2AMLogic/sg13g2-pll/sim/README.md

# sim/ — append-only PVT evidence records

This is the first work to land here (previously "Empty until the first work
lands here" — see the repo README's "Repo layout" and `spec/porting-plan.md`
§1.3, "Testbench / corner-harness structure"). The convention below is
carried over **as-is** from `gf180-pll`'s own `sim/README.md` (itself copied
from `2AMLogic/gf180-bandgap`) per that section's own disposition table — it
is methodology, not circuit data, so it needs no per-PDK re-derivation.

## Directory / naming convention

```
sim/
  <slug>/
    testbench/            ngspice deck(s) + any generator script that builds
                           per-corner netlists from them
    netlist-snapshots/    the exact design/**/netlist/*.spice this record
                           simulated, frozen at commit time -- independent of
                           whatever the live export says today
    corners/               the PVT/sensitivity matrix definition and the raw
                           per-corner results (a CSV or equivalent)
    records/               one Markdown file per run, `RECORD-NNN-<title>.md`,
                           numbered and never edited in place
```

One directory per **claim under test**, not per run — `<slug>` names the
claim (e.g. `sg13cmos5l-loop-filter-momcap`), and every new run against that
same claim adds a new `RECORD-NNN` file, not a rewrite of an old one. A
genuinely different DUT (a different block, a different question) gets its
own sibling slug rather than being folded into an existing one.

**Records are append-only.** A record's conclusion can be superseded by a
later record (e.g. a re-run against an updated netlist), but the old record
stays in place, unedited — the evidence trail is the history, not just the
latest answer.

**Netlist provenance.** Every record's `netlist-snapshots/` freezes the
exact `.spice` export it simulated, plus the commit SHA it was frozen at (in
each snapshot's own header comment) — independent of whatever
`design/**/netlist/*.spice` says by the time someone reads the record later.

**PVT corner matrix.** The default sweep is the full process x supply x temp
matrix; any subset (e.g. a passive network with no supply-dependent device,
so "supply corner" does not apply) must state the reason explicitly in the
record, not silently drop an axis. The corner *count* is PDK-specific — see
each record for the axes it actually swept and why.

**Host requirement — `cap_cmomi`-bearing decks need an x86-64 host, unless
the two MOM-capacitor OSDI models are rebuilt locally first.** The installed
`ihp-sg13cmos5l` tree ships `cap_cmomi.osdi` and `cap_cmomf.osdi` as
**prebuilt x86-64 ELF binaries tracked in upstream git** — unlike
`psp103`/`psp103_nqs`/`mosvar`/`r3_cmc`, which are host-local build products
of the sibling `ihp-sg13g2` tree. On an arm64 macOS host the two therefore
fail `dlopen` ("slice is not valid mach-o file") and every deck that
*instantiates* a `cap_cmomi` device aborts with `Unable to find definition of
model xcap:cap_cmomi_mod`. **That failure is a host/PDK-provisioning gap, not
a broken testbench.** The PDK ships its own fix —
`ihp-sg13cmos5l/libs.tech/verilog-a/openvaf-compile-va.sh` recompiles exactly
those two models from the Verilog-A sources in the same tree — and issue #59
verified on x86-64 that a locally rebuilt model reproduces two whole committed
campaigns byte-identically. What is *not* verified is the arm64 build itself
(OpenVAF-Reloaded publishes no macOS binary, so `openvaf-r` has to be built
from source there first). Read
[`PORTING-osdi-host-arch.md`](PORTING-osdi-host-arch.md) before running any
`sim/` campaign on a non-x86-64 host: it carries the rebuild command, what
stays unverified, and the numeric cross-check a rebuilt model must pass before
it is trusted for a **new** record. `sim/tools/check-osdi-arch.sh` is the
preflight the `cap_cmomi`-loading campaigns call, so they abort with that
diagnosis instead of with ngspice's message. One campaign
(`sg13cmos5l-lock-detector-window`) opts that single object out of the abort
with the preflight's `--soft` flag, because it has a validated closed-form
substitute for it and records which source produced every affected number in
the CSV's own `source` column — see `PORTING-osdi-host-arch.md` § "`--soft`".
Every other object stays a hard abort in every campaign, including that one.

**Closed-loop internal-timestep bound** and **charge-domain PFD/CP
characterization** (the other two `spec/porting-plan.md` §1.3 methodology
items carried over as-is) apply once a closed-loop or PFD/CP testbench
exists. **No record below is a transistor-level closed-loop testbench**, so
the internal-timestep bound still does not apply. The charge-domain PFD/CP
characterization is *partially* engaged as of issue #27:
`sg13cmos5l-cp-icp-trim` characterises the charge pump's own delivered
current and up/down mismatch, but at DC with the switches held static —
the *charge*-domain (per-reference-cycle, switching) part of that
methodology item is still not exercised, and that record says so in its own
"What this does not bound".

## Cold start

How a third party reproduces any recorded result, and the PDK revision the
repo is pinned to. Checked by `manifests/check_testbench_coverage.py` (T1
item 9, issue #179); every bench with a `records/` directory must be indexed
below and vice versa.

**Pinned PDK revisions.** One line per PDK tree (parsed by the gate):

```
PDK-PIN ihp-sg13cmos5l 607e18d4bd9214a52575c194b4181ef449f9252f
PDK-PIN ihp-sg13g2 5cccb161f7492697cfa52eb14dc03beb00bdca9e
```

Provenance of the pins, stated honestly: none of the 37 grandfathered
records cites a full PDK commit. They name only the install path and
`ngspice-46`/`-47`. The `ihp-sg13cmos5l` pin is the clean git checkout
installed at `~/share/pdk` on the worker host as of 2026-10-09 (commit date
2026-08-25). Its reflog shows one clone at 2026-08-25 15:54 UTC and no later
checkout.

The `ihp-sg13g2` pin (issue #210) is upstream `IHP-GmbH/IHP-Open-PDK` tag
`v0.3.0`, commit `5cccb161f7492697cfa52eb14dc03beb00bdca9e`. The worker's
tree is a release-tarball install (`.fetched-version` = `0.3.0`), not a git
checkout. The pin was established by a separate user-space clone of that
commit (under `/tmp`, nothing host-wide touched), compared with
`diff -rq` against the installed tree:

* every one of the commit's `ihp-sg13g2/` files is present and
  byte-identical (0 differing files);
* the installed tree only *adds* host-local products: the compiled
  `libs.tech/ngspice/osdi/*.osdi`, `__pycache__/`, and submodule content
  the tarball does not carry.

Upstream `main` has since changed 23 `ngspice/models` files, so a fresh
clone of `main` would not reproduce the run environment. Commands and
output: [`provenance-migration.md`](provenance-migration.md) § "Pin
verification".

Both pins are today's reproducibility targets. Neither proves what an
individual record ran against: several records ran on an arm64 macOS host
whose trees are unknown. Note also that `ihp-sg13cmos5l` tracks most of its
ngspice model cards and the `psp103`/`psp103_nqs`/`mosvar`/`r3_cmc` OSDI
paths as symlinks into the sibling `ihp-sg13g2` tree, so CMOS5L
transistor-level runs read both trees (see `provenance-migration.md`).

All 37 existing records (append-only, so not editable) stay grandfathered in
`KNOWN_DEFECTS`, tracked by issue #182. Their per-record inventory and
recovered/superseded dispositions are in `provenance-migration.md`. Item 9
stays `unmet` until every record is resolved; it is not claimed met here.

### Provenance addenda (append-only migration)

Committed records are never edited, renamed or deleted. A grandfathered
record (`KNOWN_DEFECTS` in `manifests/check_testbench_coverage.py`) is
resolved only by a **new** file `sim/<slug>/records/ADDENDUM-NNN-<topic>.md`
in the same bench, one addendum per original, made of `KEY: value` lines
(other prose is ignored). Two kinds:

```
ADDENDUM-FOR: <slug>/records/RECORD-001-....md   # the original, same bench
ADDENDUM-KIND: recovered
ADDENDUM-SHA256: <sha256 of the original's bytes>  # proves it is unmodified
ADDENDUM-PDK: ihp-sg13g2 <40-hex revision>        # repeat per tree if mixed
ADDENDUM-TOOL: ngspice-46
ADDENDUM-EVIDENCE: <what was recovered, e.g. host PDK checkout log, path/date>
```

```
ADDENDUM-FOR: <slug>/records/RECORD-001-....md
ADDENDUM-KIND: superseded
ADDENDUM-SHA256: <sha256 of the original>
ADDENDUM-RERUN: <slug>/records/RECORD-0NN-....md   # same bench, cites the original by file name
ADDENDUM-EVIDENCE: <what was rerun>
```

* `recovered` establishes the *historical* PDK revision(s) and tool of the old
  run from evidence. Revisions are never inferred from today's installed PDK
  or from the slug; a bench that used both trees lists both `ADDENDUM-PDK`
  lines. A recovered revision that differs from today's pin is kept and
  reported by the gate (the pin is today's reproducibility target, not a claim
  about the past). Contradicting a revision the original itself cites fails.
* `superseded` replaces the *evidence claim* with a new measurement. It must
  not carry `ADDENDUM-PDK`/`ADDENDUM-TOOL`: a new run does not prove the old
  run's environment. The rerun is an ordinary `RECORD-*.md` and must itself
  cite a PDK revision and tool version (and match the pin).
* A `RECORD-*.md` (including a rerun) may cite revisions for more than one
  known tree, written `PDK <tree> revision <hex>` or `<tree> <hex>`. Each
  tree-qualified revision is compared with **that tree's** pin; a mismatch is
  a DISCREPANCY. Use this when a `sg13cmos5l-*` bench reads `ihp-sg13g2`
  content through the upstream symlinks (cite both trees; never drop one).
  An unqualified revision is compared with the bench tree's pin, as before.
* The gate fails closed on: missing fields, bad hash, dangling or cross-bench
  references, a rerun that does not cite the original (unrelated), cyclic or
  self supersession, duplicate addenda for one record, unknown PDK tree or
  contradictory revisions, an addendum for a record with no defect, and an
  unresolved rerun. Resolved `KNOWN_DEFECTS` entries are retained (reported as
  resolved) until a human removes them; unresolved ones stay open.
  Item 9 stays unmet and uncited while any record is unresolved or any pin is
  `UNKNOWN`.

**Install steps** (no host-wide tools; everything is user-space):

1. Fetch the PDK trees and expose them as siblings under `PDK_ROOT`.
   `ihp-sg13cmos5l` is the `ihp-sg13cmos5l/` subtree of
   `https://github.com/IHP-GmbH/IHP-Open-PDK` (the split
   `IHP-GmbH/ihp-sg13cmos5l` repository is archived). Install pin, fetched as
   an exact-commit tarball and checked before extraction (copy the subtree
   into `$PDK_ROOT/ihp-sg13cmos5l`; do not symlink it, so its relative model
   symlinks resolve to the sibling `ihp-sg13g2`):
   `curl -fsSL -o pdk.tgz https://codeload.github.com/IHP-GmbH/IHP-Open-PDK/tar.gz/f7bca32694fe3d58be0cc7d9df4b9f5db7161a14 && echo "5eb6f8a9b0b2ecc4fa08cc30627668406f85b1a97834f278036c43f0c0dbc70b  pdk.tgz" | sha256sum -c - && tar -xzf pdk.tgz --strip-components=1 -C "$PDK_UNIFIED" IHP-Open-PDK-f7bca32694fe3d58be0cc7d9df4b9f5db7161a14/ihp-sg13cmos5l && cp -a "$PDK_UNIFIED/ihp-sg13cmos5l" "$PDK_ROOT/ihp-sg13cmos5l"`
   Note: the `PDK-PIN ihp-sg13cmos5l` line above and the recorded evidence
   still name the legacy split-repository commit; evidence reruns on the new
   pin and the pin switch are owned by #213-#218, so records made before that
   cite the legacy revision, not this install pin.
   The `ihp-sg13g2` tree is the `ihp-sg13g2/` subdirectory of
   `https://github.com/IHP-GmbH/IHP-Open-PDK` at its pin:
   `git clone https://github.com/IHP-GmbH/IHP-Open-PDK "$PDK_SRC" && git -C "$PDK_SRC" checkout 5cccb161f7492697cfa52eb14dc03beb00bdca9e`,
   then expose `$PDK_SRC/ihp-sg13g2` as `$PDK_ROOT/ihp-sg13g2`. It must be a
   sibling of `ihp-sg13cmos5l`, whose relative model symlinks resolve into
   it.
2. ngspice 46 with OSDI support (records were produced with `ngspice-46`;
   a few with `ngspice-47`, noted in those records).
3. Build the OSDI models the tree needs (`psp103`, `psp103_nqs`, `mosvar`,
   `r3_cmc`) per the PDK's `libs.tech/verilog-a/openvaf-compile-va.sh`; on a
   non-x86-64 host also rebuild `cap_cmomi`/`cap_cmomf` (see the host
   requirement above). `sim/tools/check-osdi-arch.sh` preflights this.
4. `export PDK_ROOT=<parent dir>`; `export PDK=ihp-sg13cmos5l` (or
   `ihp-sg13g2`), then run the entry point from the repo root.

On a shared worker, multi-corner grids go through `klt sim` to the batch
fleet rather than hand-launched ngspice loops.

**Bench index** (slug, entry point, invocation):

| Bench | Entry point | Invocation |
| --- | --- | --- |
| `sg13cmos5l-closed-loop-lock` | `testbench/run.sh` | `PDK_ROOT=$PDK_ROOT PDK=ihp-sg13cmos5l sim/sg13cmos5l-closed-loop-lock/testbench/run.sh` |
| `sg13cmos5l-closed-loop-lock` (mismatch-gain grid, batch fleet) | `testbench/gen_mismatch_gain_requests.py` | `python3 -I sim/sg13cmos5l-closed-loop-lock/testbench/gen_mismatch_gain_requests.py --pinned-pdk $PINNED_PDK OUTDIR && klt sim --batch-set OUTDIR/dc/*/request.json --wait-for-capacity 600 && klt sim --batch-set OUTDIR/loop/*/request.json --wait-for-capacity 600` (then `testbench/mismatch_gain_post.py`; see `records/RECORD-014`) |
| `sg13cmos5l-closed-loop-real-divider` | `testbench/run.sh` | `PDK_ROOT=$PDK_ROOT PDK=ihp-sg13cmos5l sim/sg13cmos5l-closed-loop-real-divider/testbench/run.sh` |
| `sg13cmos5l-cp-icp-trim` | `testbench/run.sh` | `PDK_ROOT=$PDK_ROOT PDK=ihp-sg13cmos5l sim/sg13cmos5l-cp-icp-trim/testbench/run.sh` |
| `sg13cmos5l-cp-icp-trim-mc` | `testbench/gen_requests.py` | `cd sim/sg13cmos5l-cp-icp-trim-mc && python3 -I testbench/gen_requests.py --pinned-pdk $PINNED_PDK && klt sim testbench/mc.request.json --backend batch --wait-for-capacity 600 --report-out reports/sim.mc.json` |
| `sg13cmos5l-divider-nrange-retiming` | `testbench/run.sh` | `PDK_ROOT=$PDK_ROOT PDK=ihp-sg13cmos5l sim/sg13cmos5l-divider-nrange-retiming/testbench/run.sh` |
| `sg13cmos5l-divider-retiming-sizing` | `testbench/gen_sizing_requests.py` | `python3 -I sim/sg13cmos5l-divider-retiming-sizing/testbench/gen_sizing_requests.py setup b:b && klt sim <request> --backend batch --wait-for-capacity 600` |
| `sg13cmos5l-klt-pex-signoff` | `run-klt-pex.sh` | `PDK_ROOT=$PDK_ROOT sim/sg13cmos5l-klt-pex-signoff/run-klt-pex.sh <block>` |
| `sg13cmos5l-lock-detector-window` | `testbench/run.sh` | `PDK_ROOT=$PDK_ROOT PDK=ihp-sg13cmos5l sim/sg13cmos5l-lock-detector-window/testbench/run.sh` |
| `sg13cmos5l-lock-detector-window` (batch fleet) | `testbench/run_batch.sh` | `sim/sg13cmos5l-lock-detector-window/testbench/run_batch.sh` (full grid; `NOMINAL_ONLY=1` for one corner; see `testbench/BATCH.md`) |
| `sg13cmos5l-supply-range` | `testbench/run_batch.sh` | `sim/sg13cmos5l-supply-range/testbench/run_batch.sh` |
| `sg13cmos5l-loop-bandwidth-pm` | `testbench/run.sh` | `PDK_ROOT=$PDK_ROOT PDK=ihp-sg13cmos5l sim/sg13cmos5l-loop-bandwidth-pm/testbench/run.sh` |
| `sg13cmos5l-loop-filter-momcap` | `testbench/run.sh` | `PDK_ROOT=$PDK_ROOT PDK=ihp-sg13cmos5l sim/sg13cmos5l-loop-filter-momcap/testbench/run.sh` |
| `sg13cmos5l-postlayout-pex-pvt` | `testbench/run.sh` | `PDK_ROOT=$PDK_ROOT PDK=ihp-sg13cmos5l sim/sg13cmos5l-postlayout-pex-pvt/testbench/run.sh` |
| `sg13cmos5l-vco-decap-momcap` | `testbench/run.sh` | `PDK_ROOT=$PDK_ROOT PDK=ihp-sg13cmos5l sim/sg13cmos5l-vco-decap-momcap/testbench/run.sh` |
| `sg13cmos5l-vco-duty-cycle` | `testbench/run.sh` | `PDK_ROOT=$PDK_ROOT PDK=ihp-sg13cmos5l sim/sg13cmos5l-vco-duty-cycle/testbench/run.sh` |
| `sg13cmos5l-vco-output-levels` | `testbench/run.sh` | `PDK_ROOT=$PDK_ROOT sim/sg13cmos5l-vco-output-levels/testbench/run.sh WORKDIR` |
| `sg13cmos5l-vco-kvco-table` | `testbench/run.sh` | `PDK_ROOT=$PDK_ROOT PDK=ihp-sg13cmos5l sim/sg13cmos5l-vco-kvco-table/testbench/run.sh` |
| `sg13g2-pfd-reset-parity` | `testbench/run.sh` | `PDK_ROOT=$PDK_ROOT PDK=ihp-sg13g2 sim/sg13g2-pfd-reset-parity/testbench/run.sh` |
| `sg13g2-divider-repair-reverification` | `testbench/run.sh` | `PDK_ROOT=$PDK_ROOT PDK=ihp-sg13g2 sim/sg13g2-divider-repair-reverification/testbench/run.sh` |
| `sg13g2-hbt-characterization` | `testbench/run.sh` | `PDK_ROOT=$PDK_ROOT PDK=ihp-sg13g2 sim/sg13g2-hbt-characterization/testbench/run.sh` |
| `sg13g2-lock-detector-window` | `testbench/run.sh` | `PDK_ROOT=$PDK_ROOT PDK=ihp-sg13g2 sim/sg13g2-lock-detector-window/testbench/run.sh` |
| `sg13g2-vco-kvco-table` | `testbench/run.sh` | `PDK_ROOT=$PDK_ROOT PDK=ihp-sg13g2 sim/sg13g2-vco-kvco-table/testbench/run.sh` |

**`sg13cmos5l-cp-icp-trim-mc` takes `$PINNED_PDK`, not `$PDK_ROOT`.** (So
does `sg13cmos5l-closed-loop-lock`'s `gen_mismatch_gain_requests.py`, for a
different reason: it ships the pinned model bytes with each batch job via
`options.stage_model_inputs` rather than resolving them on the fleet image.)
`sg13cmos5l-cp-icp-trim-mc` is the bench whose *result* depends on which of
the two `ihp-sg13cmos5l` revisions above it reads: the newer install defaults the HV MOS mismatch
subcircuits to `mm_ok=0`, and this repo's netlists carry no `mm_ok=` on their
instance lines, so the Monte Carlo campaign would return sigma exactly 0 on
every measurement and still report `pass`. `$PINNED_PDK` must be an
`ihp-sg13cmos5l` checkout at the `PDK-PIN` revision above; the bench's
generator refuses to emit a request against a tree it cannot prove will draw.
See `sg13cmos5l-cp-icp-trim-mc/README.md` and its `records/RECORD-002`.

**The `±3.5 %` that bench grades against is retired** (issue #385).
`spec/decision-records/DR-013-cp-mismatch-limit.md` retires it and proposes
no replacement bound: `sg13cmos5l-closed-loop-lock`'s
`records/RECORD-014-cp-mismatch-phase-error-gain.md` re-measured the gain it
was derived from on the DR-010 `cp` and found it ~30× smaller, of the
opposite sign, and not through the origin.
`sg13cmos5l-cp-icp-trim-mc/records/RECORD-003-regrade-proposed-limit.md`
re-grades the committed 1500 samples against DR-013's evidence-coverage
bound with `klt yield --limits` (99.60 %, `required_n` 154, sample-size
verdict `sufficient`), writing `reports/yield.mc.proposed-limit.json` beside
— never over — `reports/yield.mc.json`. `testbench/mc.request.json` is
unedited, so its `min -3.5 / max 3.5` is history, not a live bound. The
ruling the ratifiers are asked for is `spec/target-spec.md` R-12.

## PDK scope — two independent campaigns, one convention

This repo targets two PDKs in parallel (`design/README.md` "SG13CMOS5L
port"): the original SG13G2 design directly under `design/`, and the
SG13CMOS5L port under `design/sg13cmos5l/`. Both campaigns use the directory
convention above, distinguished by the `<slug>` prefix (`sg13cmos5l-*` here;
an unprefixed or `sg13g2-*` slug for the original PDK once that campaign
starts). **SG13G2 now has its own campaign** (`sg13g2-lock-detector-window`,
issues #81 and #82, Part of #16 via #78) — see "SG13G2 campaign status" below. Every
earlier campaign issue was scoped to the SG13CMOS5L port only, and none of
those add or edit an SG13G2 result. **One exception worth naming, because it
predates #81 and is a measurement of an SG13G2 netlist living in a
`sg13cmos5l-*` slug**:
`sg13cmos5l-lock-detector-window/corners/schmitt_rewire.csv` (issue #66)
carries a `pdk` column and 54 of its 108 rows measure
`design/netlist/lock_detector.spice`'s `schmitt_hv` on `ihp-sg13g2`. That is
deliberate — issue #66 fixes the same two-net feedback defect in the shared
cell on both PDKs, and "measured on both" is a stronger claim than "measured
on one and argued across". It is filed under the CMOS5L slug rather than
opening an SG13G2 slug for two nets, and it does not constitute an SG13G2
campaign: the SG13G2 `lock_detector`'s own `XRPU`/`XCW`/`XMPD` are still at
their pre-#52 values and nothing here measures them.

## SG13CMOS5L campaign status

Tracks issues #23, #27, #30, #36, #37, #38, #52 and #66 (all Part of #16). #23 owns the
specific obligation `spec/decision-records/DR-003-sg13cmos5l-port-readiness.md`
Finding 2 names: every spec row sensitive to the design's three `cap_cmomi`
MOM-cap instance sites (`loop_filter.XC1`/`XC2`, `vco.XCDECAP`) must be swept
across a plausible MOM-model-uncertainty band, because the installed PDK's
own `cap_cmomi`/`cap_cmomf` models carry **no characterised process-corner
or mismatch spread** (`cornerCAP.lib`'s own header, confirmed directly by
this campaign — see records below) and are "not validated on CMOS5L
silicon." #27 picks up the rows #23 explicitly deferred: the ones needing a
charge-pump characterisation, a loop-level combination of the three
measured block records, or a longer/edge-resolved transient. #36 (split out
of #27) takes row 3 — the `divider_chain`'s own functional N range and
retiming margin — which #27 built an exploratory testbench for but
deliberately never published. #37 (also split out of #27) picks up the
three rows that specifically need a real transistor-level closed loop, none
of which #27's own three records is. #38 measures `lock_detector` (row 16),
never attempted in #27, and closes the MOM-uncertainty gap on its own two
`cap_cmomi` instances (`XCW`/`XDW.XC1`), which are outside DR-003 Finding
2's three-instance list. #52 is the first issue in this campaign to
**change the design and re-measure it**: it re-sizes the three
`lock_detector` devices #38's own record root-caused (`XRPU`, `XCW`,
`XDW.XC1`) and re-runs #38's campaign against the resized block, appending
`RECORD-002` beside `RECORD-001` rather than replacing it. #66 then fixes the
two mechanisms RECORD-002 measured but was out of scope to change
(`schmitt_hv`'s feedback wiring and the `XRPU`/`XMPD` strength ratio) and
runs the campaign a third time, appending `RECORD-003` — closing row 16's
last measurable criterion. **#30 is the first campaign here that measures a
*layout* rather than a schematic**: it re-runs two of the matrices below
against parasitic-annotated netlists extracted from the routed GDS, each
alongside a schematic-level control arm re-run on the same host, and is the
named follow-up issue #24 deferred post-layout PVT to. It adds **no new spec
row and amends none** — it re-measures rows already bounded above and reports
how far layout moves them. The table below is the whole campaign, in the
order the records landed.

| Slug | Claim under test | Spec row(s) (`spec/porting-plan.md` §1.2) | Status |
|---|---|---|---|
| [`sg13cmos5l-loop-filter-momcap`](sg13cmos5l-loop-filter-momcap/) | `loop_filter` R1/C1/C2 corner + MOM-cap-uncertainty sensitivity (zero/pole location) | 6/6a (loop bandwidth / phase margin) | Zero/pole location **bounded** by a real PVT+MOM sweep; the row's own kHz/degree numbers stay `insufficient-evidence` (needed the not-yet-re-derived Kvco table and Icp-trim table; both landed, and `sg13cmos5l-loop-bandwidth-pm` below now closes the row) |
| [`sg13cmos5l-vco-decap-momcap`](sg13cmos5l-vco-decap-momcap/) | `vco.XCDECAP` capacitance value + supply-decoupling pole sensitivity | 8 (period jitter), 12 (supply sensitivity) | Capacitance value **bounded** by a real MOM sweep; the absolute jitter-ps / dB-attenuation numbers stay `insufficient-evidence` (need a post-layout parasitic source impedance and a closed-loop phase-noise method ngspice cannot run today — DR-002 Decision 5) |
| [`sg13cmos5l-vco-kvco-table`](sg13cmos5l-vco-kvco-table/) | Open-loop `vco` frequency vs. `VCTRL` vs. 2-bit band code, real transient sweep (not MOM-cap-sensitive — no `cap_cmomi` instance survives this testbench's own XCDECAP-strip, see that record's "Tooling note") | 4/5 (Kvco bound / band-selection rule) | Kvco-vs-band-code table **bounded** by a real PVT-cornered open-loop sweep (3 corner bundles x 4 band codes x 5 `VCTRL` points); row 6/6a's own loop-bandwidth number is now closed by `sg13cmos5l-loop-bandwidth-pm` below, and row 3 (divider retiming margin) still needs the divider chain's own re-derivation |
| [`sg13cmos5l-cp-icp-trim`](sg13cmos5l-cp-icp-trim/) | `cp` delivered current vs. mirror trim code, and up/down mismatch vs. output voltage (all-MOS DUT — no resistor and no `cap_cmomi` instance, so neither the RES-corner nor the MOM axis applies) | 6/6a (Icp-trim table), 10 (reference spur, mismatch input) | Icp-trim table **bounded** by 306 real DC sweeps (5 MOS corners x 3 temps + a ±10% supply sub-axis x 6 trim codes x 3 switch states): the mirror-referenced ladder tracks its reference to within 0.14% across the whole PVT matrix. Row 10's own dBc number stays `insufficient-evidence` — the *static* mismatch is now real, but a spur level additionally needs switching charge mismatch, the PFD reset window, and a stable loop to define a carrier |
| [`sg13cmos5l-loop-bandwidth-pm`](sg13cmos5l-loop-bandwidth-pm/) | Linearised open-loop gain around the **real** `loop_filter` subckt, with `Icp` and `Kvco` taken from the two measured records above | 6/6a (loop bandwidth / phase margin) | **`insufficient-evidence` CLEARED — and the bound is a failure to meet the criteria.** `f_c` = 0.33–4.64 MHz, PM = 1.55–20.33° across 90 real-subckt AC runs; **0 of 90 meet the ≥45° criterion** with the as-drawn filter, and `Icp` cannot trade one criterion against the other. A separate proposal sweep (`corners/proposal.csv`, explicitly *not* the committed design) shows `R1` ×20 with the 10 µA trim code meets both criteria at every PVT bundle. Also records that the ported `f_ref` = 1–25 MHz / `N` = 4–64 rows are mutually inconsistent with the measured VCO band |
| [`sg13cmos5l-vco-duty-cycle`](sg13cmos5l-vco-duty-cycle/) | Open-loop `vco` output duty cycle (rising *and* falling 50%-of-rail crossings), plus the ring's own average supply current | 13 (output duty cycle), 11 (power, one domain) | Duty cycle **bounded** by 300 real transient runs (5 MOS corners — including the `mos_sf`/`mos_fs` split corners the Kvco record left open — x 3 temps x 4 band codes x 5 `VCTRL` points): 43.74–51.56%, with **30 of 300 points below the 45% floor**, all at −40 C. Reproduces gf180-pll's own carried-forward duty-cycle design flag on a different process. Row 11 stays `insufficient-evidence` (only the `vdd_vco` and `cp` domains are measured) |
| [`sg13cmos5l-vco-output-levels`](sg13cmos5l-vco-output-levels/) | Open-loop `vco` output levels (settled V_OH / V_OL) into a 50 fF load on `CLK`, as one `klt sim` batch request | 14 (output levels / drive) | **54 of 54 points inside the bounds** (3 PVT bundles x 3 temps x band `00`/`11` x 3 `VCTRL`): worst V_OH 3.003 V vs >= 2.97 V (`mos_ss`, 125 C, band `11`, `VCTRL` 2.7 V, +33 mV), worst V_OL 0.122 V vs <= 0.33 V. Schematic only; `mos_sf`/`mos_fs`, band `01`/`10`, mismatch, post-layout not swept. Spec row not edited (R-10) |
| [`sg13cmos5l-closed-loop-lock`](sg13cmos5l-closed-loop-lock/) | Transistor-level closed loop (`pfd`+`cp`+`loop_filter`+`vco`+`divider_chain`+`lock_detector`, testbench-local wiring — no `pll_top` schematic exists), single PVT point (runtime-cost subset, see that record's own `corners/matrix.md`) | 7 (lock time), 10 (reference spur), 11 (power, remaining domains) | **Row 11 bounded** (with caveats): all five remaining domains measured simultaneously at one operating point — `pfd`+`cp`+`vco`+`lock_detector` = 2.483 mA (8.20 mW); `divider_chain` alone = 7.653 mA (25.26 mW), but flagged as very likely inflated by that block's own known malfunction (see below), not a clean design figure. **Rows 7 and 10 stay `insufficient-evidence`**, but the `pfd` self-reset inverter-parity defect `records/RECORD-002` (issue #50) root-caused is now **fixed and re-verified** (`records/RECORD-003`, issue #56): with the corrected `pfd`, the proposal loop (Part B) achieves genuine **frequency lock** (`Δf`/`f_ref` within 0.03% of `f_ref` for a full microsecond, zero cycle slips — vs. `RECORD-001`'s own monotonically-diverging ≈23% `Δf`) but settles at a stable **static phase error of ≈9.18% of a reference period**, ~1.8× this record's own 5% row-7 threshold, so the dual lock criterion is still not met. **`records/RECORD-004` (issue #70) then confirms the mechanism**: an ideal, diagnostic-only substitution forcing `cp`'s `up`/`dn` currents to be exactly equal (NOT a change to the committed `cp`) collapses the static phase error to a mean of −0.00044% in the pinned dual-tree rerun (`records/RECORD-012-icp-mismatch-diagnostic-rerun-pinned.md`, #228; −0.00235% in the original run; both from 9.176%, `RECORD-003`'s own final-20-cycle window) and to simulator floating-point noise in the fully-settled tail, while also extending the longest continuous dual-lock run from 4 cycles to 41 (41 cycles and the 450 ns `lock_time` reproduce identically in the rerun). RECORD-004's own decision: this is a design-level `cp` current-mirror-matching defect worth mitigating, not an acceptable residual — filed as issue #72. The as-drawn loop (Part A) still does not lock, independently over-determined by the separate `divider_chain` defect (#36). **`records/RECORD-005` (issue #72) then implements and re-runs the real mitigation** (`design/sg13cmos5l/cp.sch` gains an on-chip high-swing cascode bias replica, `spec/decision-records/DR-006`): the DC-measured up/dn mismatch this mitigation targets drops 20x at the loop's own operating point (`sim/sg13cmos5l-cp-icp-trim/records/RECORD-002`: −6.42% → −0.298%), but the closed-loop static phase error only drops from 9.176% to **8.203%** — an ~11% relative reduction, not the ~3,900x collapse RECORD-004's idealized diagnostic showed for the same nominal mechanism — and the longest continuous dual-lock run stays at 4 cycles. **Row 7 still fails for the mitigated design, not just the as-drawn one.** RECORD-005's own analysis: RECORD-004's ideal substitution likely also removed switching/dynamic charge-mismatch effects (already flagged as unmeasured by `sim/sg13cmos5l-cp-icp-trim/RECORD-002`) alongside the DC magnitude term it was built to isolate, and that dynamic term — not DC magnitude, which is now small — is the best-fitting remaining candidate for row 7's residual, though not itself confirmed by a dedicated diagnostic. **This slug's own testbench also hosts `run_closed_loop_vwin_dwell.sh` (issue #76)**, which instruments both `lock_detector` revisions side by side inside a closed-loop acquisition to answer a `sg13cmos5l-lock-detector-window` question (whether `schmitt_hv`'s crowbar current is reachable in real operation, not a claim this slug's own rows track) — see that slug's `records/RECORD-004-crowbar-current-mitigation.md`<br><br>**`RECORD-006` (#150, diagnostic, nominal corner, proposal deck): the 8.2% residual is dump-node charge sharing in `cp`** (`VDUMP` ≈0.94 V below `VOUT`, ≈41 fC per cycle); an ideal `VDUMP = VOUT` reaches 1.05%/locked, but row 7 still fails for the committed design<br><br>**`RECORD-014` (#385, diagnostic, proposal deck, −40/27/125 °C): the mismatch-to-static-phase-error gain on the DR-010 `cp` is −0.0394 to −0.0484 pp/pp — ~30× smaller than the +1.43 pp/pp the `sg13cmos5l-cp-icp-trim-mc` ±3.5% screening limit assumed, and of the opposite sign.** Six injected DC mismatch points spanning −11.998 to +12.009% (±3.1σ), each snapshot's own mismatch measured rather than assumed; a linear-through-origin model is rejected (forcing the intercept to zero multiplies the fit residual by 22×–90×) because the intercept is the DR-010 `cp`'s own 0.75–0.84 pp zero-mismatch residual. The worst static phase error anywhere in the span is 1.3265%, against the 5% criterion. `spec/decision-records/DR-013` retires the ±3.5% value and proposes no replacement bound; target-spec R-12 carries the ruling. **New failure retained: at 125 °C the proposal deck does not acquire lock at any mismatch point, including the unperturbed one** (`vctrl` rails at 3.289 V) — newly visible because every earlier closed-loop record here ran at 27 °C only |
| [`sg13cmos5l-closed-loop-real-divider`](sg13cmos5l-closed-loop-real-divider/) | Nominal-only (`mos_tt`/`res_typ`/27 C/3.3 V, one point, pre-layout) closed loop with the repaired transistor-level `divider_chain` (N=64, 20 MHz ref), vs. a behavioural /64 control arm; plus a divider-alone speed diagnostic at 200/640/1280 MHz (edge counts persisted in `corners/edges_divspeed_*`) | 7 (lock time) | **Row 7 still fails**: the real-divider loop does not acquire (dual-lock never met); the divider alone divides by 64 at 200 and 640 MHz but by 96 at 1.28 GHz. Not a PVT campaign and no post-layout or sign-off claim. See [`records/RECORD-001`](sg13cmos5l-closed-loop-real-divider/records/RECORD-001-repaired-divider-in-loop-nominal.md) (issue #159, follow-up #168) |
| [`sg13cmos5l-lock-detector-window`](sg13cmos5l-lock-detector-window/) | Real-subckt `lock_detector` assert window, hysteresis, chatter and supply current, plus the `XCW`/`XDW.XC1` MOM-uncertainty sensitivity | 16 (lock-detector targets), 11 (power, one more domain) | **`RECORD-001` (#38, pre-resize): window, hysteresis and no-chatter all bounded, and all three fail the ported criteria at every corner.** Window = 0.219–0.409 ns (target ≥2.5 ns); no hysteresis resolves at the ladder's 0.15×-window step at any of 92 points (target ≥25% of window); **92/92 points chatter**, including at a 10×-window static phase error. Cause is measured directly: the integrating node's own `XRPU`·`XCW` time constant (0.71–1.71 ns) is 23–1412× shorter than the reference period across the whole ported 1–25 MHz range, so `VWIN` fully re-settles every cycle regardless of phase-error size. The ±20% MOM band moves the window 7–8% (not the dominant term) and does not change the chatter/no-hysteresis verdict at any point. Static-phase-offset comparison stays `insufficient-evidence` (needs an unmeasured PFD/CP record); `lock_detector`'s own supply current (0.79–60.3 µA) is bounded, corroborating the combined figure in the `sg13cmos5l-closed-loop-lock` row above with a dedicated per-domain measurement.<br><br>**`RECORD-002` (#52, post-resize): `XRPU` `l=6u`→`l=700u`, `XCW` `w=8u l=8u`→`w=40u l=40u`, `XDW.XC1` `w=4u l=4u`→`w=40u l=40u` — the window and no-chatter criteria now PASS.** Window = 3.688–11.24 ns against the ≥2.5 ns floor at 81/81 points (worst-case margin 1.475×, including an explicit worst-case axis stack RECORD-001's grid did not contain); `steady` at 18/18 ladder corners at a 10×-window static phase error, at both ends of row 2's DR-005-amended 3.5–24.4 MHz range; `R·C` = 2.29–5.58 µs = **8.0–19.5×** the slowest reference period (6.4–23.4× including the ±20% MOM band), against 23–1412× *below* it before. **Hysteresis still fails** (<20% of window vs ≥25%), and RECORD-002 separates the cause into two measured terms that are both outside the three devices #52 resized: `schmitt_hv`'s feedback devices are tied to the wrong rails (0.9–1.6 mV measured, vs 881–979 mV for the classic connection) and — binding over that — the settled-`VWIN`-vs-phase-error transition is ≤0.05× the window wide, set by the `XRPU`/`XMPD` strength ratio, so rewiring the Schmitt alone measurably changes nothing. Row 11's `lock_detector` domain re-bounded at 2.48–95.1 µA for the resized block. One fixed sizing covers the whole amended `f_ref` range, so **row 2 needs no narrowing and no decision record is owed**.<br><br>**`RECORD-003` (#66, post-hysteresis-fix): `schmitt_hv`'s two feedback devices re-tied to the classic connection and `XMPD` `w=2u l=0.5u`→`w=0.25u l=16u` — ALL THREE of row 16's measurable criteria now PASS.** Hysteresis **50–800% of the window, 0 of 21 corners below the ≥25% criterion** (worst case 50%, i.e. 2.0× the criterion, at the 24.4 MHz corners); `steady` at **21/21** at a **20×**-window static phase error (RECORD-002 probed 10×); assert window **3.688–11.24 ns at 102/102** points and `R·C` **byte-identical** to RECORD-002 at 8.0–19.5× `T_ref`, so #52's two passing criteria are re-measured rather than assumed. The two fixes are each necessary and neither is sufficient: `schmitt_hv` goes from **0.88–1.58 mV** to **804 mV–1.058 V** of input-referred hysteresis (measured on **both** PDKs, 108 rows), and `XMPD`'s size is a **two-sided measured bound** — stronger fails the criterion at the fast end, weaker pushes the de-assert threshold past two-thirds of a reference period at the slow end. This record also runs on **x86-64**, so `cap_cmomi.osdi` loads and the `real` DUT variant returns: it closes RECORD-002's own arm64 gap (the closed-form nominal matches the real model to every printed digit; `real` vs. `ideal0.00` moves `twin_r` by ≤0.057%). Row 11's `lock_detector` domain re-bounds to **2.47–234 µA**, the top of which is attributed by control to `schmitt_hv` crowbar current while `VWIN` rests inside the now-wide hysteresis band, not to switching<br><br>**`RECORD-004` (#76, post-crowbar-mitigation): decided by measurement that the crowbar current is an accepted residual in realistic operation, then mitigated anyway.** A `sg13cmos5l-closed-loop-lock` deck (`run_closed_loop_vwin_dwell.sh`) instruments the pre-mitigation block inside a genuine closed-loop acquisition at three initial control voltages, now representative since issue #72's `cp` mismatch closed via #85: **`VWIN` never enters the hysteresis band** (`dwell_frac` = 0.000000 at all three `VC0` points; the pre-#52 control block reaches 0.0001 at one). `schmitt_hv`'s six channel lengths are lengthened `l=0.5u`→`l=2u` regardless (crowbar current 3.2–4.3× lower at every corner, `../sg13cmos5l-lock-detector-window/corners/schmitt_crowbar_variants.csv`, 180 rows; hysteresis-in-volts changes only 0.978–1.036×; the static in-band phase-error zone this cell reaches is unchanged at every corner to within ~1.4 percentage points of `T_ref`) and landed on the SG13G2 sibling `schmitt_hv.sch` in this same change. **All three of row 16's measurable criteria re-verified, unchanged in substance**; row 11's `lock_detector` domain re-bounds to **2.48–113 µA** (10×-window probe, down from 234 µA) / 40.75–103.29 µA (20×-window probe, now the full 21-corner matrix rather than one spot-checked corner)<br><br>**`RECORD-005` (#136, `XRPU` bulk `sub!`→`VSS`, the layout LVS repair): nominal corner only, byte-identical to `RECORD-004`; full grid NOT re-run.** One netlist line changes (`XRPU VDD VWIN sub! rhigh` → `… VSS …`); every deck in this slug already ties `sub!` and `VSS` to 0 V. At `mos_tt`/`res_typ`/27 °C/3.3 V/3.5 MHz/`real` every reduced row (window, R, C, Schmitt, assert/de-assert, hysteresis 300 % of window, `steady`, `trec`, `idd`) is byte-identical to `RECORD-004`; 4/21 raw ladder rows differ by ≤ 20 µV on `VWIN` (solver noise, disclosed). The other 20 ladder corners and the window/Schmitt grids were not run: this host class must send corner grids to the batch fleet, and `klt sim`'s batch backend refuses `ihp-sg13cmos5l` (klayout-tools#2727). Full-PVT verdicts remain `RECORD-004`'s, owed a re-run<br><br>**`RECORD-011` (#139, full grid on the batch fleet, `run_batch.sh`, jobs `klt-sim-4cd2688193ce`/`b42084f0bd7f`/`c47978accdd4`/`91d00c2cba7d`): the full-grid run for the `XRPU`-bulk DUT is done, compared with `RECORD-004`'s `*_crowbarfix` outputs, 0 missing rows.** All R-independent rows (window, Schmitt, tstep, C extraction) match to the last printed digit at 163 of 165 rows; the ladder shifts at 21/21 corners because the PDK `rhigh` card moved after the pins (`f7bca326` vs `607e18d4`, R(XRPU) −4.5 to −8.7 %), so ladder-derived row-16/row-11 results are **not attributed to the DUT alone** (same-PDK control owed to #257). Row 16 criteria hold on the current PDK (0/102 below 2.5 ns, 0/21 below 25 %, `steady` 21/21); row 11 10×-probe 2.49–116 µA. The 20×-window `idd_outlock` probe is not in the batch driver and is still owed; full-grid status for it is not cleared |
| [`sg13cmos5l-divider-nrange-retiming`](sg13cmos5l-divider-nrange-retiming/) | `divider_chain` functional N range + `XFRT` retiming margin at the measured top-of-band frequency, plus the chain's own average supply current | 3 (multiplication ratio / retiming margin), 11 (power, one more domain) | **The committed (as-drawn) design does not function as a divider at any of 9 tested corners** — its `dff_tg_hv` hold path is a self-biased inverter, not a real latch (0/9 corners hold at the rail; settles to a process/supply-dependent mid-rail voltage instead). This is the block-level root cause of the same non-toggling feedback node `sg13cmos5l-closed-loop-lock`'s Part A independently observed in a real closed loop. A proposal variant (`fbfix`, not committed) with a minimal 3-line hold-path fix holds cleanly at the rail in 9/9 corners and divides by exactly `N=64` (one exact simulated calibration point) at a 100 MHz low-frequency baseline, matching the structural `N ∈ [64,127]` formula's floor. Retiming margin at the measured top-of-band frequency (1562.0 MHz) is judged **inadequate** for this specific proposal sizing (its own single-flop setup-time sweep fails to capture at every tested `TSU` up to 300 ps, at all 3 tested corners) — no numeric margin bound is claimed (`insufficient-evidence`, whole-chain transient convergence was not reliably reproducible in this session). The missing-reset / OP-convergence gap is recorded as its own design finding, not routed around. On row 11: the functional `fbfix` variant draws ≈166 µA average at the 100 MHz baseline, ~46× below the 7.653 mA the closed-loop record measured for the as-drawn `divider_chain` — corroborating that row's own flag that its figure is inflated by the malfunction rather than a clean design number (different variant and operating frequency, so corroboration, not a like-for-like substitute) |
| [`sg13cmos5l-divider-retiming-sizing`](sg13cmos5l-divider-retiming-sizing/) | `dff_tg_hv` width-sizing sweep against the row-3 one-edge retiming closure (issue #189) | 3 (retiming closure, R-3) | **Closure at 1562.0 MHz not reached; partial campaign.** Uniform width scaling breaks the chain; per-group sizing (8 variants) leaves the tt/27 and ff/-40 setup floor at 500 to 600 ps (needs `t_arr` <= ~140 ps vs 484.9 ps measured); only ss/125 improved (1000-1500 to 600-700 ps, feedback weakened). No resized variant has a measured `t_arr`, so no improved closing bound is claimed. RECORD-002: 9-corner retime of feedback-weakened variants + opposite-edge retiming (best deck bound 1301 MHz at tt/-40 C, still short); ss/27 C and tt/125 C divider core stops dividing between 1400 and 1562 MHz; in-situ capture looks k+1, conflicting with the setup-deck reading (unresolved). RECORD-003 (waveforms, tt/27 C and tt/-40 C, 1562 MHz): rising `DIVOUT` is captured k+1 with clk->Q 387 to 451 ps (nrange RECORD-003's k+2 reading excluded), falling `DIVOUT` is captured k+2 (retimed `FB` duty-distorted by about one period); the isolated setup deck only scores `Q` correct within 160 ps, which explains the disagreement; spec unchanged |
| [`sg13cmos5l-postlayout-pex-pvt`](sg13cmos5l-postlayout-pex-pvt/) | **Post-layout**: the `vco` and `cp` campaigns above re-run against parasitic-annotated netlists `klt extract --deck sg13cmos5l --parasitics` produced from the ROUTED layout, each alongside a schematic-level control arm re-run on the same host | 4/5 (Kvco), 6/6a (Icp trim) -- re-measured post-layout, not re-derived | **Real extracted parasitics WERE modelled** -- stated in as many words, per issue #30's own AC: klt's curated `sg13cmos5l` metal R/C coefficients (klayout-tools#2126, merged 2026-09-19, closing #2113), with `metals_without_coefficient` EMPTY for all six routed blocks. Extraction re-run from a clean upstream checkout and reproduces the committed netlists byte-identically. **`cp` (LVS match, 20/20 devices): the ratified Icp-trim table survives post-layout unchanged** -- +0.055..+0.632% (UP) / +0.017..+0.211% (DN) over 306 PVT points, worst case 0.51 uA on a 2.5-80 uA ladder. **`vco`: 0.4768-0.5312x the schematic frequency at 60/60 points** (band 223.7-789.5 MHz vs. 445.3-1562.0 MHz), attributed by a 7-variant diagnostic to **~99% parasitic CAPACITANCE** (extracted device geometry alone: 0.69%; parasitic R: a further ~0.7 pp). **Three caveats the record states rather than implies**: (a) that 2x is an UPPER BOUND set by routing style, not a floorplan prediction -- this flow draws 7178 um of wire for a ~45-device ring VCO, 413 um on `ring1` alone, and a C-scaling bracket puts a 10x-less-wire floorplan near -6..-10%; (b) `vco` has NO confirmed layout-vs-schematic topology match, so part of its deviation could be the unmatched comparison (bounded, not root-caused); (c) the deck's coefficients are the uncalibrated public-data starter values klayout-tools' own docstring says they are. Both control arms reproduce their committed campaigns (VCO 60/60 byte-identical; `cp` to 4.9e-5%). **No spec row is amended** on a non-representative floorplan |
| [`sg13cmos5l-klt-pex-signoff`](sg13cmos5l-klt-pex-signoff/) | `klt pex` envelopes (nominal corner) for `pfd`, `cp`, `loop_filter`, `vco`, `divider_chain` on the layout record the manifest's `4.analog` names (`20261010-012952-a4ca1b8` since #195; `20261003-183059-dc5644a` before) -- the evidence T1 item 7 cites (#152); `lock_detector` withheld (#157) | 7 (post-layout) | `RECORD-001`: all five `body_bias: biased`; deltas not graded (no limits): vco period +151 %, loop_filter t63 +29.6 %, pfd up_avg +77.8 %, cp +0.17 %/-0.05 %, divider ratio 64.0 both legs.<br><br>**`RECORD-002` (#195): re-bound to the DR-010 `pll_cp` redraw.** All five were re-run on the new record. The four unchanged blocks reproduce RECORD-001 exactly. cp is now +0.141 %/-0.039 % (Icp at DC only; the bench does not observe `VDUMP` tracking). Needs an OSDI-v0.4 ngspice (ngspice-46); the host's ngspice-42 cannot load the PDK's `psp103`, and `--backend batch` refuses `osdi_preload`. |

**Still deferred, and explicitly `insufficient-evidence`** (follow-up issues
filed off #27, each Part of #16):

| Spec row | Why it is still open |
|---|---|
| 3 — divider retiming margin, numeric bound only (#36) | The functional half of this row is now **closed** by `sg13cmos5l-divider-nrange-retiming` (above): the committed design does not divide at any tested corner (root cause: a `dff_tg_hv` hold path that is a single inversion loop, not a bistable latch — the same defect `sg13cmos5l-closed-loop-lock`'s Part A saw as a non-toggling feedback node), and a proposal variant's low-frequency `N=64` behaviour is bounded against the structural `N ∈ [64,127]` range. What remains open is the narrower gap: the specific top-of-band (1562.0 MHz) retiming-margin *number* stays `insufficient-evidence` — the whole-chain transient there was not reliably reproducible within that session's compute budget, so the qualitative "inadequate margin" conclusion rests on a lighter-weight single-flop setup-time sweep instead |
| 7 — lock time (#37) | `sg13cmos5l-closed-loop-lock` attempted this directly. `records/RECORD-001` found neither loop acquiring lock; `records/RECORD-002` (issue #50) root-caused Part B's own non-convergence to a `pfd` self-reset inverter-parity defect; `records/RECORD-003` (issue #56) fixes that defect and re-runs both decks. Part B now **frequency-locks** (zero cycle slips, `Δf`/`f_ref` within 0.03% of `f_ref` held for the full final microsecond) but settles at a stable ≈9.18%-of-`T_ref` static phase error, above the 5% threshold this record's own row-7 criterion uses. `records/RECORD-004` (issue #70) then **confirms** the previously-stated-but-unconfirmed hypothesis: a diagnostic-only substitution forcing `cp`'s `up`/`dn` currents exactly equal collapses that residual to noise-level (mean −0.00044% in the pinned dual-tree rerun, `RECORD-012`; −0.00235% in the original run, vs. 9.176%) and extends the longest dual-lock-holding run from 4 to 41 cycles (identical in the rerun), with the reset-chain delay-symmetry candidate correspondingly ruled out as a material contributor. Still `insufficient-evidence` for the COMMITTED design (no mitigated `cp` has been built or verified yet — that is issue #72's own scope), but the causal chain is now bounded rather than merely plausible, and a specific design-level mitigation path (tighten `cp`'s current-mirror matching) is identified. Part A still does not lock, independently over-determined by the separate `divider_chain` defect (#36). **`records/RECORD-005` (issue #72) implements that mitigation** (`design/sg13cmos5l/cp.sch`'s on-chip cascode bias replica, `DR-006`) and re-runs Part B against the real, transistor-level mitigated block: the static phase error drops only to **8.203%** (from 9.176%), still above the 5% threshold — **row 7 stays `insufficient-evidence`/fails for the mitigated design too**, and the causal weight shifts from the now-small DC magnitude mismatch (−0.298% at this operating point) toward an unconfirmed but best-fitting switching/dynamic charge-mismatch candidate RECORD-005 names but does not itself isolate **`records/RECORD-006` (issue #150) isolates that candidate on the same proposal deck, nominal corner only: it is dump-node charge sharing, not switch timing or the PFD reset window.** `cp_dumpbuf` (an NMOS source follower) holds `VDUMP` ≈0.94 V below `VOUT`, so every UP and every DN turn-on pulls ≈20–23 fC out of the filter to recharge the leg's switch-common node (open-loop: −41.3 fC per pulse pair, same sign for both legs, width-independent). That predicts 8.22% vs. 8.20% measured. An ideal `VDUMP = VOUT` diagnostic gives 1.05% with a 45-cycle lock (lock time 250 ns); restoring only the 0.94 V level shift brings 7.40% back; ideal switches give 5.18%; and reset-window changes (overlap 0.86×/1.17×) move the error by ≤0.012 pp. **Row 7 still fails for the committed design**; the proposed fix (make `VDUMP` track `VOUT` at DC) is a separately scoped `cp.sch` change **Nominal real-divider re-run (issue #159, evidence retained in #168):** with the repaired `divider_chain` in the loop at the nominal point only, the N=64 loop still does not acquire and the divider alone miscounts at 1.28 GHz (96 edges per FB period) — see [`sg13cmos5l-closed-loop-real-divider/records/RECORD-001`](sg13cmos5l-closed-loop-real-divider/records/RECORD-001-repaired-divider-in-loop-nominal.md); not a PVT or post-layout result, row 7 still fails |
| 10 — reference spur (#37) | `sg13cmos5l-closed-loop-lock` attempted this directly; stays `insufficient-evidence` — even post-`pfd`-fix (`records/RECORD-003`, issue #56), Part B is frequency-locked but not phase-locked within row 7's own criterion, so there is still no stable, locked carrier to define a spur around per this row's own requirement |

Row 16 (lock-detector window/hysteresis/chatter) is no longer deferred —
`sg13cmos5l-lock-detector-window` (#38) bounds it, and the bound is a
failure to meet the ported criteria at every corner; (#52) then re-sizes
the block and re-measures it — the assert-window and no-chatter criteria
pass at every corner re-measured, with the hysteresis criterion still
failing and its cause separated into two measured terms outside that
resize's own scope; (#66) then fixes both of those terms and re-measures
again — **all three of row 16's measurable criteria now pass**, hysteresis
at 50–800% of the window against a ≥25% target with 0 of 21 corners below
it. The "≥ 2× worst static phase offset" half of the row stays
`insufficient-evidence` (see the campaign table above). Row 11 (power) is likewise no longer deferred as a whole: every
domain has now been measured somewhere in the campaign table — `vdd_vco`
(#27), `cp` (#27), the five remaining domains simultaneously at one
operating point (#37), `lock_detector` per-domain (#38) and
`divider_chain` per-domain (#36) — though the as-drawn `divider_chain`
figure carries the malfunction caveat noted in both of those rows, so a
clean whole-PLL total still waits on the design fixes (#56). Row 3 is the
only row above whose *functional* question is answered while a numeric
sub-bound stays open. None of the remaining deferred rows is
MOM-cap-sensitive in DR-003 Finding 2's own sense, so they remain outside
that record's specific obligation even though they are open
`spec/porting-plan.md` "re-derive" rows.

## SG13G2 campaign status

Tracks issues #81, #82 (Part of #16 via #78), #97 and #120. #81/#82 are
Phases 1/2 and 2/2 of the decomposition #78's own Scope section calls for
("stand up the slug + extract R/C" then "re-derive and re-measure"); both
have landed. #97 is a second, independent SG13G2 slug — the SG13G2 twin of
the SG13CMOS5L port's own `sg13cmos5l-vco-kvco-table` (issue #23). #120 is
the third: re-verification of the #112 divider repair ported to the
non-port `design/` tree.

| Slug | Claim under test | Spec row(s) (`spec/porting-plan.md` §1.2) | Status |
|---|---|---|---|
| [`sg13g2-lock-detector-window`](sg13g2-lock-detector-window/) | Real-subckt SG13G2 `lock_detector` assert window, hysteresis, chatter and supply current, plus `cap_cmim`'s own real process-corner sensitivity | 16 (lock-detector targets), 11 (power, `lock_detector` domain) | **Phase 1 (#81, pre-resize): extraction and stand-up only, no `RECORD-NNN`** — `rc_extract.csv`: `R` = 11.8–28.6 kΩ, `C` = 22.2–27.1 fF (`XDW.XC1`) and 49.5–60.4 fF (`XCW`) across `cap_cmim`'s own real `cap_typ`/`cap_bcs`/`cap_wcs` corner × temperature (a real corner axis this device has and SG13CMOS5L's `cap_cmomi` does not — see the slug's README). The window/ladder/schmitt/tstep CSVs from that run show the same pre-resize signature the SG13CMOS5L sibling's `RECORD-001` found (`R·C` = 0.65–1.57 ns, 0.0023–0.038× `T_ref`; chatter at 36/36; window 0.219–0.393 ns).<br><br>**`RECORD-001` (#82, post-re-derivation): `XRPU` `l=6u`→`l=500u`, `XCW` `w=6u l=6u`→`w=45u l=45u`, `XDW.XC1` `w=4u l=4u`→`w=45u l=45u`, `XMPD` `w=2u l=0.5u`→`w=0.25u l=12u` — ALL THREE of row 16's measurable criteria PASS.** Assert window **3.732–10.249 ns at 37/37** points (worst case 1.493× the ≥2.5 ns floor, at an explicit worst-case axis stack #81's grid did not contain); **`steady` at 21/21** ladder corners at a **20×**-window static phase error; hysteresis **25–800% of window, 0 of 21 corners below the ≥25% criterion**, and the single 25.0% corner — which is the ladder's own 0.25×-window quantum — resolves to **43.0% (1.72×)** on a 0.05×-window sweep interpolated against that corner's own measured Schmitt trip points (`hysteresis_diag.csv`). `R·C` = **2.65–7.88 µs = 9.26–27.59×** the slowest reference period, against 0.0023–0.038× before. **Every one of the four numbers is derived on THIS PDK, and none equals the SG13CMOS5L sibling's** (`rc_sizing.csv`/`rc_pairing.csv`, `window_sizing.csv`, `xmpd_sizing.csv` are the sizing evidence) — `cap_cmim` is ≈1.5 fF/µm² against `cap_cmomi`'s ≈1.06, so SG13G2 reaches the same window delay from 2025 µm² of MIM instead of 2 × 1600 µm² of MoM, and can afford a lower-impedance 0.97–2.36 MΩ integrating node. **Two findings recorded beyond the pass**: (a) the settled-`VWIN` characteristic has a *narrow-pulse knee* that makes row 16's hysteresis criterion **non-monotonic in `XMPD`'s length** (`l=8u` measures 13.0%, worse than the stronger `l=6u`'s 20.3%), so a bisecting sizing pass would converge to the wrong answer; (b) the admissible `XMPD` band is narrow (~1.6× in `L`, ~1.03× if de-assert must stay inside half a reference period) because row 16's hysteresis and the de-assert threshold's reach pull against each other across row 2's 7× `f_ref` span — structural, not fixable with the four devices in scope. Row 11's `lock_detector` domain bounded at **2.44–100.5 µA** (20×-window out-of-lock probe, not comparable with #81's 10× probe). The record also documents a **measurement error it made and corrected**: a 16 µs settling cap left `settle_frac` = 0.893 at the `res_wcs`/−40 °C corner, and an under-settled two-start-state ladder **manufactures hysteresis** — the committed data runs at 32 µs, `settle_frac` ≥ 0.9817 everywhere |
| [`sg13g2-vco-kvco-table`](sg13g2-vco-kvco-table/) | Open-loop SG13G2 `vco` frequency vs. `VCTRL` vs. 2-bit band code, real transient sweep (`XCDECAP`/`cap_cmim` kept, not stripped — see that record's `corners/matrix.md`) | 1 (output band), 4/5 (Kvco bound / band-selection rule) | **`RECORD-001` (#97): output band and Kvco-vs-band-code table bounded by a real PVT-cornered open-loop sweep (3 corner bundles x 4 band codes x 5 `VCTRL` points, 60/60 valid).** Band **445.26–1561.97 MHz**; Kvco avg **144.2–422.4 MHz/V**, Kvco peak local **162.2–379.9 MHz/V**; band select inert at `VCTRL=0.3V`, up to ~2.8x spread at `VCTRL=2.7V` (same shape as the SG13CMOS5L sibling). **Every one of the 60 measured frequencies is byte-for-byte identical to `sg13cmos5l-vco-kvco-table/records/RECORD-001`'s own table** — expected, since both designs' active devices (`sg13_hv_nmos`/`sg13_hv_pmos`) and corner-model files are literally shared between the two PDK trees, and the one per-instance difference (`XCDECAP`'s `cap_cmim`/`cap_cmomi` decap) is provably invisible to an ideal-voltage-source-driven measurement. **Confirms, rather than contradicts, `spec/decision-records/DR-005-fref-n-vco-band-reconciliation.md`'s own SG13CMOS5L-proxy assumption** — the SG13G2 band does not fall outside what DR-005 cited, so no follow-up decision record is needed. Row 3's top-of-band data point (1561.97 MHz) likewise matches DR-005's own 1562.0 MHz figure |
| [`sg13g2-divider-repair-reverification`](sg13g2-divider-repair-reverification/) | The non-port SG13G2 `divider_chain`, as repaired by #120 (the #112 repair ported verbatim to `design/dff_tg_hv.sch`): latch hold, exact commanded divide ratio, OP convergence, and the chain's own average supply current | 3 (multiplication ratio / retiming margin), 11 (power, `divider_chain` domain) | **`RECORD-001` (#120): the repair is confirmed on the SG13G2 PDK itself — DC OP converges (both ic modes; the broken as-drawn design never did), latch hold 9/9 corners at the rail, and the divide ratio is exact at every freshly simulated point (`N=64.000` at the `mos_tt`/`mos_ss`/`mos_ff` speed bracket; `N` = 65.000/96.000/127.000 structural bracket at nominal), with `idd` −218.6…−237.7 µA inside the port record's own 9-corner range.** The DUT netlist, every model card, and every OSDI object the all-MOS DUT loads are **byte-identical** to the port campaign's already-swept set (three `cmp`/`diff` checks quoted in the record), so the port RECORD-003 numbers for the stages not freshly re-run (remaining PVT points, remaining code words, tolerance arms, `setup`/`retime`) transfer as the same simulation — the same cross-PDK identity pattern `sg13g2-vco-kvco-table` established. Row 3's retiming-margin numeric sub-bound stays open exactly as the port record left it; row 3's functional-`N` half is now closed for the SG13G2 tree too |

Issue #82 (Part of #16 via #78) has since closed that loop: it re-derived
`XRPU`/`XCW`/`XDW.XC1` against `R·C ≫ T_ref` and `XMPD` against a two-sided
hysteresis / de-assert-reach bound using this slug's own `rc_extract.csv`,
and recorded the result as this slug's
`records/RECORD-001-resized-window-hysteresis-chatter.md` — following the
SG13CMOS5L sibling's `RECORD-001`→`RECORD-002`→`RECORD-003` precedent
(issue #38 measures, #52 resizes `XRPU`/`XCW`/`XDW.XC1`, #66 resizes `XMPD`)
but compressed into a single record on this PDK, because `schmitt_hv`'s
feedback wiring was already fixed here by #66 and so the second half of that
sibling sequence had nothing left to repair. **The two PDKs' `lock_detector`
sizings are now both measured and are deliberately not identical** — see
`design/README.md` § "SG13G2 `lock_detector`: re-derived, no longer
provisional" for the device-by-device comparison.

## Provenance of this convention

Per `spec/porting-plan.md` §1.3: this directory structure and its
append-only discipline are carried over from `2AMLogic/gf180-pll`'s own
`sim/README.md` (itself copied from `2AMLogic/gf180-bandgap`) — a
methodology convention, not circuit data, so no SG13G2/SG13CMOS5L
re-derivation applies to the convention itself.
