2AMLogic/sg13g2-pll/sim/sg13cmos5l-closed-loop-lock/records/RECORD-014-cp-mismatch-phase-error-gain.md

# RECORD-014: the DC up/dn mismatch-to-static-phase-error gain on the DR-010 `cp` is -0.039 to -0.048 %/% , about 30x smaller than the +1.43 %/% the `+/-3.5 %` screening limit assumes, and not through the origin

- **Slug**: `sg13cmos5l-closed-loop-lock`
- **Issue**: #385 (follow-up to #178). The limit this measurement feeds:
  `spec/decision-records/DR-013-cp-mismatch-limit.md`. The campaign whose
  screening limit it re-derives:
  `../../sg13cmos5l-cp-icp-trim-mc/records/RECORD-002-cp-mismatch-mc-yield.md`
  and its re-grade `../../sg13cmos5l-cp-icp-trim-mc/records/RECORD-003-regrade-proposed-limit.md`.
- **Append-only.** This record edits no earlier record, snapshot, CSV or
  script. New files: `../testbench/gen_mismatch_gain_requests.py`,
  `../testbench/mismatch_gain_metrics.py`, `../testbench/mismatch_gain_post.py`,
  `../testbench/test_mismatch_gain_metrics.py`, and
  `../corners/{mismatch_gain.csv, mismatch_gain_fit.json,
  mismatch_gain_points.json, sim_mismatch_gain_dc.json,
  sim_mismatch_gain_loop.json}`. `cpdiag_metrics.py`, `cpdiag_build.py`,
  `cpdiag_post.py`, `tb_pll_cpdiag.sp.tmpl` and
  `run_closed_loop_otabuf.sh` are used **unmodified** (their sha256 are
  cited by the committed `cpdiag_summary_*.json` files and must not move).
- **What this is, and what it is not.** This is RECORD-007's deck -- which is
  RECORD-005/006's **proposal deck** -- re-run at seven injected DC
  mismatch points. Everything that makes it a proposal deck is unchanged
  and the numbers are **not committed-PLL performance and not sign-off
  evidence**:
  - a behavioural XSPICE divide-by-64 instead of the committed
    `divider_chain`;
  - `R1` resized 120u to 2400u;
  - ideal capacitors for every MOM cap;
  - `XCDECAP` stripped;
  - ideal `IREF` sources into `cp`'s bias pins.

  The `cp` itself is the committed DR-010 design, perturbed only as
  described below.
- **Tooling**: `ngspice-47` on the fleet workers (`/usr/local/bin/ngspice`,
  `environment.engine_version: "47"` in every corner report) and
  `ngspice-47` locally for the two single-point checks below;
  `klt 0.9.2.dev964+g02db14ecf46b` (client; it submitted, sharded and
  collected every unit).
  PDK `ihp-sg13cmos5l` revision `607e18d4bd9214a52575c194b4181ef449f9252f`
  -- the `sim/README.md` pin -- shipped to the workers as bytes by `options.stage_model_inputs` rather
  than resolved on the fleet image (17 staged files per unit;
  `cornerMOShv.lib` `source_sha256` `5a1f862dc304fdfe...`, equal to the
  hash RECORD-013 cites for the pinned tree; `cornerRES.lib`
  `2c18502104146804...`; OSDI `psp103` `2e4299c46839...`, `psp103_nqs`
  `839b16448320...`, `mosvar` `25e64a374ab5...`, `r3_cmc` `4fead17bc2e9...`,
  the same prefixes RECORD-013 cites). Python 3.12.3 (stdlib only),
  `set num_threads=1` per unit. Fleet instances `c7i.8xlarge`, `us-east-1`.

## What was injected, and how the x-axis is measured

`design/sg13cmos5l/cp.sch` is **not** edited. This is a diagnostic
substitution in the style of RECORD-004: the committed snapshot
`../netlist-snapshots/cp_otabuf.spice` (sha256 `c8a55d8d2234c468...`) is
copied and the **two cascode mirror devices of the UP leg only**
(`.subckt cp_leg_p`: `XM1` tail and `XM2` cascode, `sg13_hv_pmos w=24u
l=1u`) have their width scaled by one factor `k`. The DN leg, the bias
replica, both steering-switch pairs, the inverters and the DR-010 dump
buffer are byte-identical to the committed snapshot at every point.
`k = 1` returns the snapshot **byte for byte** -- the `mm_nom` deck's
sha256 is `c8a55d8d2234c468...`, equal to `cp_otabuf.spice` -- so the
unperturbed baseline is the committed `cp`, not a re-rendered copy of it.

**The x-axis is measured, not assumed.** Each perturbed snapshot's own DC
up/dn mismatch is measured by a separate `klt sim` DC request using the
Monte Carlo bench's own deck and definition
(`../../sg13cmos5l-cp-icp-trim-mc/README.md`: one `Vup` sweep over
{0, 3.3 V} through one `XCP`, `VOUT` = 2.40 V, `Iref` = 10 uA,
`mismatch_pct = (Iup + Idn) / ((Iup - Idn) / 2) * 100`), at the same three
temperatures as the closed-loop runs.

Scaling one mirror leg gives clean, monotonic steps that land within
0.08 pp of their target at every temperature, and the DN-leg current does
not move with `k` at all:

| point | `k` | `mismatch_pct` -40 C | 27 C | 125 C | `Idn` (all `k`, 27 C) |
|---|---|---|---|---|---|
| `mm_n12` | 0.889453 | -11.9984 % | -11.9616 % | -11.9268 % | -10.0300 uA |
| `mm_n8`  | 0.925841 | -8.0141 %  | -7.9757 %  | -7.9395 %  | " |
| `mm_nom` | **1.0 (committed)** | -0.3396 % | **-0.2985 %** | -0.2603 % | " |
| `mm_p4`  | 1.043929 | +3.9457 %  | +3.9881 %  | +4.0272 %  | " |
| `mm_p8`  | 1.086577 | +7.9345 %  | +7.9779 %  | +8.0177 %  | " |
| `mm_p12` | 1.131043 | +11.9244 % | +11.9686 % | +12.0089 % | " |
| `mm_n4`  | 0.963658 | -4.0287 %  | -3.9888 %  | -3.9514 %  | " |

The `mm_nom` value at 27 C, **-0.298465 %**, equals the Monte Carlo bench's
own negative-control value (`../../sg13cmos5l-cp-icp-trim-mc/README.md`:
-0.298465 %) and the sibling corner bench's nominal
(`../../sg13cmos5l-cp-icp-trim/records/RECORD-002`: -0.298 %) to every
printed digit, so the DC deck here reproduces the committed figure before
anything is perturbed.

The span reached is **-11.998 % to +12.009 %**, i.e. +/-3.1 sigma of the
campaign's measured 3.8769 % mismatch sigma (`RECORD-002`); 3 sigma is
11.63 %.
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
