2AMLogic/sg13g2-pll/sim/sg13cmos5l-loop-filter-momcap/records/RECORD-003-rc-corner-momcap-rerun-batch.md

# RECORD-003: rerun of RECORD-001's R1/C1/C2 corner and MOM-cap sensitivity on the batch fleet (issue #321)

- **Slug**: `sg13cmos5l-loop-filter-momcap`
- **Issue**: #321 (split from #214, item 9 provenance migration, Part of #199). Append-only. Reruns the bench of `RECORD-001-rc-corner-momcap-sensitivity.md` and is the `ADDENDUM-RERUN` target of `ADDENDUM-001-record-001-superseded.md`. It edits neither the original nor its CSVs; new data is `../corners/results_rerun321.csv`.
- **DUT**: ``loop_filter` as drawn at `fac4e4a`: `XR1` rppd `w=4u l=120u`, `XC1` cap_cmomi `w=40u l=40u`, `XC2` cap_cmomi `w=10u l=10u` (`../netlist-snapshots/loop_filter.spice`, unmodified)`. Corner coverage: the original's full grid, 3 process (`res_typ`/`res_bcs`/`res_wcs`) x 3 temperature (-40/27/125 C) x 3 uniform MOM-cap fractions (-20/0/+20 %) = 27 rows (R1 measured per process x temperature = 9 decks; C1/C2 measured at 27 C and checked at -40/125 C; the MOM band is applied analytically exactly as in `run.sh`). Supply is not swept (the DUT has no active device), as in the original.
- **Not rerun**: `testbench/tb_composite_ac_crosscheck.sp` (RECORD-001's composite AC cross-check) was not part of this grid.
- **Tool / host**: `klt sim --backend batch --wait-for-capacity 600` (client `klt 0.9.2.dev868+g937ab1c98ca5`, runner klt 0.9.0) on the Spot batch fleet; ngspice-46 (`/usr/local/bin/ngspice` on the runner). Submitted from `loom-worker-1`. The originals state no host or ngspice build beyond "ngspice-46, x86-64 Linux" (RECORD-001 Tooling line), so host equivalence is unknown.
- **Batch jobs**: single-corner probe `klt-sim-ace9d0bf810c` (as-drawn R1, `res_typ`, 27 C; `c7i.8xlarge` spot, exit 0, `rval = 7.805817e+03`), then the grid `klt-sim-c165c43bf163` (24 decks shared by this record and its sibling, `m7i.4xlarge` spot, exit 0, 24/24 pass). A previous attempt's grid submit failed with `batch_no_capacity` (job `klt-sim-b25621d67592`, `BATCH_MAX_VCPU=224`, quota shared with `ci-spot`) and was never run locally; this is the retry. No local grid was run.
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
