2AMLogic/sg13g2-pll/sim/sg13cmos5l-divider-retiming-sizing/corners/setup-pvt9.csv

variant | corner | temp_c | t_setup_lo_ps | t_setup_hi_ps
cb_f1-1-0p25-1 | mos_ff | 27 | 500.0 | 600.0
cb_f1-1-0p25-1 | mos_fs | 27 | 500.0 | 600.0
cb_f1-1-0p25-1 | mos_sf | 27 | 500.0 | 600.0
cb_f1-1-0p25-1 | mos_ss | 27 | 500.0 | 600.0
cb_f1-1-0p25-1 | mos_tt | -40 | 500.0 | 600.0
cb_f1-1-0p25-1 | mos_tt@2.97V | 27 | 500.0 | 600.0
cb_f1-1-0p25-1 | mos_tt | 27 | 500.0 | 600.0
cb_f1-1-0p25-1 | mos_tt@3.63V | 27 | 500.0 | 600.0
cb_f1-1-0p25-1 | mos_tt | 125 | 600.0 | 700.0
cb_f1-1-0p5-1 | mos_ff | 27 | 500.0 | 600.0
cb_f1-1-0p5-1 | mos_fs | 27 | 500.0 | 600.0
cb_f1-1-0p5-1 | mos_sf | 27 | 500.0 | 600.0
cb_f1-1-0p5-1 | mos_ss | 27 | 500.0 | 600.0
cb_f1-1-0p5-1 | mos_tt | -40 | 500.0 | 600.0
cb_f1-1-0p5-1 | mos_tt@2.97V | 27 | 500.0 | 600.0
cb_f1-1-0p5-1 | mos_tt | 27 | 500.0 | 600.0
cb_f1-1-0p5-1 | mos_tt@3.63V | 27 | 500.0 | 600.0
cb_f1-1-0p5-1 | mos_tt | 125 | 600.0 | 700.0
cb_f2-0p5-0p5-1 | mos_ff | 27 | 500.0 | 600.0
cb_f2-0p5-0p5-1 | mos_fs | 27 | 500.0 | 600.0
cb_f2-0p5-0p5-1 | mos_sf | 27 | 500.0 | 600.0
cb_f2-0p5-0p5-1 | mos_ss | 27 | 500.0 | 600.0
cb_f2-0p5-0p5-1 | mos_tt | -40 | 500.0 | 600.0
cb_f2-0p5-0p5-1 | mos_tt@2.97V | 27 | 500.0 | 600.0
cb_f2-0p5-0p5-1 | mos_tt | 27 | 500.0 | 600.0
cb_f2-0p5-0p5-1 | mos_tt@3.63V | 27 | 500.0 | 600.0
cb_f2-0p5-0p5-1 | mos_tt | 125 | 500.0 | 600.0
cb_fb | mos_ff | 27 | 500.0 | 600.0
cb_fb | mos_fs | 27 | 600.0 | 700.0
cb_fb | mos_sf | 27 | 500.0 | 600.0
cb_fb | mos_ss | 27 | 600.0 | 700.0
cb_fb | mos_tt | -40 | 500.0 | 600.0
cb_fb | mos_tt@2.97V | 27 | 600.0 | 700.0
cb_fb | mos_tt | 27 | 500.0 | 600.0
cb_fb | mos_tt@3.63V | 27 | 500.0 | 600.0
cb_fb | mos_tt | 125 | 600.0 | 700.0
