2AMLogic/sg13g2-pll/sim/sg13g2-hbt-characterization/corners/analysis-output.md

### HBT r_o (ohm), npn13G2 Nx=1, mirror-biased; span 0.9->1.5 V Vce (forward-active at every corner) | span 0.6->0.9 V
| process | T (C) | Vbe @ Iref=2.5/10/80 uA (V) | r_o 2.5 uA | r_o 10 uA | r_o 80 uA | (0.6->0.9) 10 uA | Ic(1.5V)/Iref @10 uA |
|---|---|---|---|---|---|---|---|
| hbt_typ | -40 | 0.776 / 0.804 / 0.848 | 58.14 M | 8.80 M | 0.279 M | 9.22 M | 1.0039 |
| hbt_typ | 27 | 0.689 / 0.726 / 0.784 | 55.45 M | 9.49 M | 0.335 M | 10.52 M | 1.0008 |
| hbt_typ | 125 | 0.555 / 0.604 / 0.681 | 40.73 M | 8.66 M | 0.393 M | 12.00 M | 0.9988 |
| hbt_bcs | -40 | 0.771 / 0.799 / 0.843 | 57.53 M | 8.63 M | 0.264 M | 9.06 M | 1.0061 |
| hbt_bcs | 27 | 0.683 / 0.720 / 0.777 | 54.60 M | 9.30 M | 0.319 M | 10.34 M | 1.0047 |
| hbt_bcs | 125 | 0.547 / 0.596 / 0.672 | 39.58 M | 8.41 M | 0.376 M | 11.78 M | 1.0051 |
| hbt_wcs | -40 | 0.782 / 0.810 / 0.855 | 59.06 M | 9.02 M | 0.297 M | 9.44 M | 1.0004 |
| hbt_wcs | 27 | 0.697 / 0.734 / 0.792 | 56.76 M | 9.77 M | 0.356 M | 10.78 M | 0.9945 |
| hbt_wcs | 125 | 0.565 / 0.615 / 0.692 | 42.43 M | 9.02 M | 0.417 M | 12.34 M | 0.9885 |

### HBT mirror-ratio mismatch (50 MC samples x 4 output devices = 200 ratios per cell; ratio = Ic_out/Iref at Vce = 0.9 V)
| process | T (C) | Iref | mean ratio | sigma(ratio) % | sigma(dVbe-equiv) mV = Vt*sigma(ln ratio) |
|---|---|---|---|---|---|
| hbt_bcs | -40 | 2p5u | 1.0189 | 13.91 | 2.75 |
| hbt_bcs | -40 | 10u | 1.0193 | 13.91 | 2.75 |
| hbt_bcs | -40 | 80u | 1.0210 | 13.92 | 2.75 |
| hbt_bcs | 27 | 2p5u | 0.9807 | 13.21 | 3.41 |
| hbt_bcs | 27 | 10u | 0.9813 | 13.21 | 3.41 |
| hbt_bcs | 27 | 80u | 0.9843 | 13.22 | 3.41 |
| hbt_bcs | 125 | 2p5u | 0.9948 | 13.49 | 4.64 |
| hbt_bcs | 125 | 10u | 0.9956 | 13.50 | 4.64 |
| hbt_bcs | 125 | 80u | 1.0001 | 13.52 | 4.65 |
| hbt_typ | -40 | 2p5u | 1.0420 | 15.61 | 3.13 |
| hbt_typ | -40 | 10u | 1.0426 | 15.61 | 3.13 |
| hbt_typ | -40 | 80u | 1.0441 | 15.62 | 3.13 |
| hbt_typ | 27 | 2p5u | 0.9830 | 13.28 | 3.45 |
| hbt_typ | 27 | 10u | 0.9838 | 13.28 | 3.45 |
| hbt_typ | 27 | 80u | 0.9866 | 13.29 | 3.45 |
| hbt_typ | 125 | 2p5u | 1.0231 | 13.23 | 4.52 |
| hbt_typ | 125 | 10u | 1.0241 | 13.24 | 4.52 |
| hbt_typ | 125 | 80u | 1.0284 | 13.26 | 4.52 |
| hbt_wcs | -40 | 2p5u | 0.9902 | 12.96 | 2.53 |
| hbt_wcs | -40 | 10u | 0.9909 | 12.97 | 2.53 |
| hbt_wcs | -40 | 80u | 0.9922 | 12.97 | 2.53 |
| hbt_wcs | 27 | 2p5u | 1.0147 | 14.42 | 3.75 |
| hbt_wcs | 27 | 10u | 1.0158 | 14.43 | 3.76 |
| hbt_wcs | 27 | 80u | 1.0186 | 14.44 | 3.76 |
| hbt_wcs | 125 | 2p5u | 0.9749 | 12.93 | 4.35 |
| hbt_wcs | 125 | 10u | 0.9760 | 12.94 | 4.35 |
| hbt_wcs | 125 | 80u | 0.9797 | 12.95 | 4.36 |

### CMOS cp_leg_n cascode leg, mos_tt/novdd/27C only (local single-corner probe)
| Iref | Isink @0.3/0.9/1.5/2.1/3.0 V Vout (uA) | r_o 1.2->3.0 V | r_o 0.9->1.5 V | Vout where Isink >= 98% of Isink(3.0V) |
|---|---|---|---|---|
| 2p5u | 2.493 / 2.502 / 2.507 / 2.512 / 2.529 | 75.09 M | 119.05 M | 0.3 |
| 10u | 9.810 / 10.003 / 10.015 / 10.025 / 10.056 | 39.22 M | 51.72 M | 0.6 |
| 80u | 67.087 / 79.521 / 80.216 / 80.258 / 80.293 | 11.38 M | 0.86 M | 0.9 |
