2AMLogic/sg13g2-pll/sim/sg13cmos5l-vco-kvco-table/corners/results_rerun318.csv

pvt_bundle | mos_corner | res_corner | temp_c | band_code | vctrl_v | period_s | freq_hz
typ | mos_tt | res_typ | 27 | 00 | 0.3 | 2.024444e-09 | 493962786.81949216
typ | mos_tt | res_typ | 27 | 00 | 0.9 | 1.875885e-09 | 533081718.7620777
typ | mos_tt | res_typ | 27 | 00 | 1.5 | 1.526759e-09 | 654982220.5076244
typ | mos_tt | res_typ | 27 | 00 | 2.1 | 1.270005e-09 | 787398474.8091543
typ | mos_tt | res_typ | 27 | 00 | 2.7 | 1.097720e-09 | 910979120.3585614
typ | mos_tt | res_typ | 27 | 10 | 0.3 | 2.024444e-09 | 493962786.81949216
typ | mos_tt | res_typ | 27 | 10 | 0.9 | 1.822716e-09 | 548631821.9623902
typ | mos_tt | res_typ | 27 | 10 | 1.5 | 1.337217e-09 | 747821782.104176
typ | mos_tt | res_typ | 27 | 10 | 2.1 | 1.042432e-09 | 959295186.6404716
typ | mos_tt | res_typ | 27 | 10 | 2.7 | 8.849525e-10 | 1130004152.7652614
typ | mos_tt | res_typ | 27 | 01 | 0.3 | 2.024444e-09 | 493962786.81949216
typ | mos_tt | res_typ | 27 | 01 | 0.9 | 1.792122e-09 | 557997725.6012704
typ | mos_tt | res_typ | 27 | 01 | 1.5 | 1.233190e-09 | 810905051.1275635
typ | mos_tt | res_typ | 27 | 01 | 2.1 | 9.302927e-10 | 1074930503.0556512
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
