2AMLogic/sg13g2-pll/sim/sg13cmos5l-vco-duty-cycle/corners/results_rerun317.csv

mos_corner | res_corner | temp_c | band_code | vctrl_v | period_s | thigh_s | duty_pct | period2_s | thigh2_s | duty2_pct | idd_avg_a
mos_tt | res_typ | -40 | 00 | 0.3 | 1.920070e-09 | 8.597100e-10 | 44.7749 | 1.920000e-09 | 8.597000e-10 | 44.7760 | 1.370040e-03
mos_tt | res_typ | -40 | 00 | 0.9 | 1.803020e-09 | 8.074300e-10 | 44.7821 | 1.803820e-09 | 8.099200e-10 | 44.9003 | 1.410270e-03
mos_tt | res_typ | -40 | 00 | 1.5 | 1.466870e-09 | 6.621100e-10 | 45.1376 | 1.466670e-09 | 6.624500e-10 | 45.1669 | 1.525200e-03
mos_tt | res_typ | -40 | 00 | 2.1 | 1.219460e-09 | 5.563600e-10 | 45.6235 | 1.219400e-09 | 5.560500e-10 | 45.6003 | 1.665530e-03
mos_tt | res_typ | -40 | 00 | 2.7 | 1.053910e-09 | 4.872600e-10 | 46.2335 | 1.054600e-09 | 4.853800e-10 | 46.0250 | 1.784690e-03
mos_tt | res_typ | -40 | 10 | 0.3 | 1.920070e-09 | 8.597100e-10 | 44.7749 | 1.920000e-09 | 8.597000e-10 | 44.7760 | 1.370040e-03
mos_tt | res_typ | -40 | 10 | 0.9 | 1.759390e-09 | 7.880900e-10 | 44.7934 | 1.759350e-09 | 7.877900e-10 | 44.7773 | 1.416370e-03
mos_tt | res_typ | -40 | 10 | 1.5 | 1.282690e-09 | 5.832600e-10 | 45.4716 | 1.282710e-09 | 5.833500e-10 | 45.4779 | 1.621810e-03
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
