2AMLogic/sg13g2-pll/sim/sg13g2-divider-repair-reverification/corners/func.csv

tag | variant | mos_corner | temp_c | vdd_v | fin_hz | p_word | n_nominal | reltol | ck1_max | ck1_min | ck2_max | ck2_min | ck3_max | ck3_min | ck4_max | ck4_min | ck5_max | ck5_min | dvo_max | dvo_min | fb_max | fb_min | tdiv_a_s | tdiv_b_s | tck_a_s | tck_b_s | idd_a
baseline | repaired | mos_tt | 27 | 3.3 | 1.000000e+08 | 000000 | 64 | 0.001 | 3.35633e+00 | -3.94779e-02 | 3.35697e+00 | -3.65241e-02 | 3.35755e+00 | -3.79401e-02 | 3.35660e+00 | -3.69907e-02 | 3.35646e+00 | -3.71396e-02 | 3.38280e+00 | -9.01653e-02 | 3.39637e+00 | -7.66895e-02 | 6.53560e-07 | 1.29356e-06 | 2.00300e-08 | 3.00300e-08 | -2.27600e-04
baseline | repaired | mos_ss | 27 | 3.3 | 1.000000e+08 | 000000 | 64 | 0.001 | 3.36093e+00 | -3.75635e-02 | 3.35672e+00 | -3.72541e-02 | 3.36141e+00 | -3.45907e-02 | 3.35226e+00 | -3.53086e-02 | 3.35235e+00 | -3.76612e-02 | 3.38163e+00 | -8.63069e-02 | 3.40396e+00 | -8.35469e-02 | 6.54001e-07 | 1.29400e-06 | 2.00300e-08 | 3.00300e-08 | -2.18878e-04
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
