2AMLogic/sg13g2-pll/sim/sg13g2-divider-repair-reverification/corners/hold.csv

variant | mos_corner | temp_c | vdd_v | q_end_v | s_end_v | t_decay_s
repaired | mos_tt | 27 | 3.3 | 3.30000e+00 | 3.30000e+00 | NA
repaired | mos_ss | 27 | 3.3 | 3.30000e+00 | 3.30000e+00 | NA
repaired | mos_ff | 27 | 3.3 | 3.30000e+00 | 3.30000e+00 | NA
repaired | mos_sf | 27 | 3.3 | 3.30000e+00 | 3.30000e+00 | NA
repaired | mos_fs | 27 | 3.3 | 3.30000e+00 | 3.30000e+00 | NA
repaired | mos_tt | -40 | 3.3 | 3.30000e+00 | 3.30000e+00 | NA
repaired | mos_tt | 125 | 3.3 | 3.30000e+00 | 3.30000e+00 | NA
repaired | mos_tt | 27 | 2.97 | 2.97000e+00 | 2.97000e+00 | NA
repaired | mos_tt | 27 | 3.63 | 3.63000e+00 | 3.63000e+00 | NA
