2AMLogic/sg13g2-pll/sim/sg13g2-divider-repair-reverification/corners/opconv.csv

variant | ic | converged | note
repaired | none | yes | ok
repaired | applied | yes | ok
