2AMLogic/sg13g2-pll/sim/sg13cmos5l-vco-duty-cycle/corners/results.csv

mos_corner | res_corner | temp_c | band_code | vctrl_v | period_s | thigh_s | duty_pct | period2_s | thigh2_s | duty2_pct | idd_avg_a
mos_tt | res_typ | -40 | 00 | 0.3 | 1.909220e-09 | 8.543900e-10 | 44.7507 | 1.909440e-09 | 8.544400e-10 | 44.7482 | 1.368460e-03
mos_tt | res_typ | -40 | 00 | 0.9 | 1.794440e-09 | 8.057100e-10 | 44.9004 | 1.793690e-09 | 8.034900e-10 | 44.7954 | 1.411620e-03
mos_tt | res_typ | -40 | 00 | 1.5 | 1.460480e-09 | 6.597000e-10 | 45.1701 | 1.460460e-09 | 6.596700e-10 | 45.1686 | 1.527420e-03
mos_tt | res_typ | -40 | 00 | 2.1 | 1.213470e-09 | 5.543500e-10 | 45.6830 | 1.214670e-09 | 5.549900e-10 | 45.6906 | 1.665400e-03
mos_tt | res_typ | -40 | 00 | 2.7 | 1.048990e-09 | 4.838600e-10 | 46.1263 | 1.049140e-09 | 4.837700e-10 | 46.1111 | 1.792380e-03
mos_tt | res_typ | -40 | 10 | 0.3 | 1.909220e-09 | 8.543900e-10 | 44.7507 | 1.909440e-09 | 8.544400e-10 | 44.7482 | 1.368460e-03
mos_tt | res_typ | -40 | 10 | 0.9 | 1.750670e-09 | 7.861500e-10 | 44.9057 | 1.750380e-09 | 7.859000e-10 | 44.8988 | 1.423460e-03
mos_tt | res_typ | -40 | 10 | 1.5 | 1.277640e-09 | 5.810400e-10 | 45.4776 | 1.276680e-09 | 5.815800e-10 | 45.5541 | 1.623390e-03
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
