2AMLogic/sg13g2-pll/sim/sg13cmos5l-closed-loop-lock/corners/results_as_drawn_rerun225.csv

tag | tstop_s | i_pfd_a | i_cp_a | i_vco_a | i_div_a | i_ld_a | vc_avg_v | vc_max_v | vc_min_v | vc_end_v | vc_start_v | lock_time_s | spur_dbc | vctrl_ripple_at_fref_v | n_ref_cycles_observed
as_drawn | 5.000000000000001e-07 | -1.88111e-05 | -2.25564e-05 | -0.00243096 | -0.00765327 | -1.11825e-05 | 2.401285 | 2.421593 | 2.264026 | 2.39371315 | 2.46 |  | -39.6489105993124 | 0.0012674530404634318 | 0
