2AMLogic/sg13g2-pll/sim/sg13cmos5l-cp-icp-trim/corners/rerun-record-001-results.csv

mos_corner | temp_c | vdd_v | iref_a | state | vout_v | icp_a
mos_tt | 27 | 3.3 | 2.5u | up | 1.6500 | 2.517839e-06
mos_tt | 27 | 3.3 | 2.5u | dn | 1.6500 | -2.648221e-06
mos_tt | 27 | 3.3 | 2.5u | both | 1.6500 | -1.303817e-07
mos_tt | 27 | 3.3 | 5u | up | 1.6500 | 5.029253e-06
mos_tt | 27 | 3.3 | 5u | dn | 1.6500 | -5.240831e-06
mos_tt | 27 | 3.3 | 5u | both | 1.6500 | -2.115773e-07
mos_tt | 27 | 3.3 | 10u | up | 1.6500 | 1.004605e-05
mos_tt | 27 | 3.3 | 10u | dn | 1.6500 | -1.036921e-05
mos_tt | 27 | 3.3 | 10u | both | 1.6500 | -3.231609e-07
mos_tt | 27 | 3.3 | 20u | up | 1.6500 | 2.006837e-05
mos_tt | 27 | 3.3 | 20u | dn | 1.6500 | -2.052925e-05
mos_tt | 27 | 3.3 | 20u | both | 1.6500 | -4.608806e-07
mos_tt | 27 | 3.3 | 40u | up | 1.6500 | 4.008966e-05
mos_tt | 27 | 3.3 | 40u | dn | 1.6500 | -4.069191e-05
mos_tt | 27 | 3.3 | 40u | both | 1.6500 | -6.022494e-07
mos_tt | 27 | 3.3 | 80u | up | 1.6500 | 8.007441e-05
mos_tt | 27 | 3.3 | 80u | dn | 1.6500 | -8.076259e-05
mos_tt | 27 | 3.3 | 80u | both | 1.6500 | -6.881761e-07
mos_tt | 125 | 3.3 | 2.5u | up | 1.6500 | 2.518475e-06
mos_tt | 125 | 3.3 | 2.5u | dn | 1.6500 | -2.630235e-06
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
