2AMLogic/sg13g2-pll/sim/sg13cmos5l-cp-icp-trim/corners/results.csv

mos_corner | temp_c | vdd_v | iref_a | state | vout_v | icp_a
mos_tt | 27 | 3.3 | 2.5u | up | 1.6500 | 2.500258e-06
mos_tt | 27 | 3.3 | 2.5u | dn | 1.6500 | -2.508545e-06
mos_tt | 27 | 3.3 | 2.5u | both | 1.6500 | -8.287036e-09
mos_tt | 27 | 3.3 | 5u | up | 1.6500 | 5.000325e-06
mos_tt | 27 | 3.3 | 5u | dn | 1.6500 | -5.012047e-06
mos_tt | 27 | 3.3 | 5u | both | 1.6500 | -1.172204e-08
mos_tt | 27 | 3.3 | 10u | up | 1.6500 | 1.000047e-05
mos_tt | 27 | 3.3 | 10u | dn | 1.6500 | -1.001753e-05
mos_tt | 27 | 3.3 | 10u | both | 1.6500 | -1.705763e-08
mos_tt | 27 | 3.3 | 20u | up | 1.6500 | 2.000082e-05
mos_tt | 27 | 3.3 | 20u | dn | 1.6500 | -2.002622e-05
mos_tt | 27 | 3.3 | 20u | both | 1.6500 | -2.540491e-08
mos_tt | 27 | 3.3 | 40u | up | 1.6500 | 4.000269e-05
mos_tt | 27 | 3.3 | 40u | dn | 1.6500 | -4.004874e-05
mos_tt | 27 | 3.3 | 40u | both | 1.6500 | -4.604798e-08
mos_tt | 27 | 3.3 | 80u | up | 1.6500 | 8.004954e-05
mos_tt | 27 | 3.3 | 80u | dn | 1.6500 | -8.023154e-05
mos_tt | 27 | 3.3 | 80u | both | 1.6500 | -1.819514e-07
mos_tt | 125 | 3.3 | 2.5u | up | 1.6500 | 2.500495e-06
mos_tt | 125 | 3.3 | 2.5u | dn | 1.6500 | -2.508103e-06
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
