2AMLogic/sg13g2-pll/sim/sg13cmos5l-cp-icp-trim/corners/results_issue79_finetrim.csv

mos_corner | temp_c | vdd_v | iref_a | state | vout_v | icp_a
mos_ff | -40 | 3.3 | 11u | up | 1.6500 | 1.100049e-05
mos_ff | -40 | 3.3 | 11u | dn | 1.6500 | -1.102240e-05
mos_ff | -40 | 3.3 | 11u | both | 1.6500 | -2.191701e-08
mos_tt | 27 | 3.3 | 11u | up | 1.6500 | 1.100050e-05
mos_tt | 27 | 3.3 | 11u | dn | 1.6500 | -1.101848e-05
mos_tt | 27 | 3.3 | 11u | both | 1.6500 | -1.797570e-08
mos_ss | 125 | 3.3 | 11u | up | 1.6500 | 1.100077e-05
mos_ss | 125 | 3.3 | 11u | dn | 1.6500 | -1.101604e-05
mos_ss | 125 | 3.3 | 11u | both | 1.6500 | -1.529873e-08
