2AMLogic/sg13g2-pll/sim/sg13cmos5l-loop-bandwidth-pm/records/RECORD-005-issue196-cp-vout-capacitance-pm-recheck.md

# RECORD-005: the real `cp`'s idle VOUT capacitance in the PM bench, and the DR-007 / DR-008 tuples re-checked (issue #196)

- **Slug**: `sg13cmos5l-loop-bandwidth-pm`
- **Issue**: #196 (Part of #16).
- **Append-only.** This record edits no earlier record, template, script,
  snapshot or corners file. `RECORD-001`..`RECORD-004`,
  `tb_loop_ac_real_resized.sp.tmpl`, `run_issue79_finetrim.sh`,
  `run_issue83_finetrim.sh` and every existing `../corners/*.csv` are
  untouched. Every artifact cited below is new.
- **Claim under test**: `RECORD-003` (DR-007) and `RECORD-004` (DR-008)
  closed their spec row 6/6a tuples with an ideal transconductor `Gcp` on the
  loop-filter node. That model leaves out everything the real `cp` hangs on
  VCTRL: the off steering switches, the leg drains, and (since DR-010) the
  `cp_dumpbuf` input gates. `C2` is only about 100 fF, and DR-008's `fast`
  bundle closed with a 0.592 deg PM margin. This record measures the missing
  capacitance and puts the real `cp` back on VCTRL.
- **DUTs** (frozen, `../netlist-snapshots/`):
  - `loop_filter_resized.spice` (sha256 `5c829308…843a`), the same DR-006
    filter `RECORD-002`..`004` use.
  - `cp_otabuf.spice` (sha256
    `c8a55d8d2234c4686f85054830d92eb4b41a256bfaeb44e039b1089033294452`). This
    is a byte-identical copy of
    `../../sg13cmos5l-cp-icp-trim/netlist-snapshots/cp_otabuf.spice`, the
    DR-010 `cp` measured by cp-icp-trim `RECORD-005`. Its body is identical to
    today's `design/sg13cmos5l/netlist/cp.spice` (checked with `diff` when
    this record was written).
- **Operating points**: `Icp`, `Kvco`, `n_div` and `f_ref` for each tuple are
  read from the committed `../corners/results_resized_issue79_finetrim.csv`
  (DR-008, 11 uA) and `../corners/results_resized_issue83_finetrim.csv`
  (DR-007, 3.75 uA) by the generator. They are not re-derived.
- **Tooling**: `klt 0.7.0+g5e5b55992a7f` (`klt sim`), `ngspice-46`
  (`~/.local/bin/ngspice`),
  `ihp-sg13cmos5l` PDK revision `607e18d4bd9214a52575c194b4181ef449f9252f` (clean checkout, equal to the
  `sim/README.md` pin), x86-64 Linux shared worker.
- **Scope: schematic only.** Every capacitance here comes from the
  schematic-level compact models. Layout parasitics of `pll_cp` (and the
  DR-010 redraw, #195) are not included. That is PEX territory.

## Method

Both benches are generated by `../testbench/gen_issue196_ccp_requests.py` and
reduced by `../testbench/summarize_issue196.py`.

### 1. Idle cp capacitance on VOUT: `tb_cp_cout_issue196.sp`

For 14 VOUT points (0.3 to 2.9 V, 0.2 V steps), four idle cp instances
(UP = DN = 0, the state the loop filter sees between reference edges) sit on
one AC source. Each has its own 0 V ammeter:

- the real `cp` at the 3.75 uA (DR-007), 10 uA and 11 uA (DR-008) codes;
- `cp_idealdump` at 10 uA. This is the snapshot's `cp` with `XBUF` replaced
  by an ideal VCVS, as in cp-icp-trim's `tb_cp_otabuf_cin.sp`. It is the legs,
  switches and bias replica without the buffer.

Nothing else loads the source, so `imag(i)/omega` is the **total** cp
capacitance ("real cp vs no cp"). That is the quantity cp-icp-trim's
buffer-only bench could not give. `c10 - b10` is the buffer-only part.

### 2. PM with the real cp on VCTRL: `tb_loop_ac_ccp_issue196.sp`

This uses option 2 of the issue: the real `cp` subckt, idle, on the
loop-filter node. It is not a lumped estimate, so the cp's whole small-signal
admittance (C and G) is in the loop, at the tuple's own trim code. For each
of the four tuples the deck holds:

- `<t>_nocp`: the `RECORD-003`/`004` loop verbatim (ideal `Gcp`, no cp). This
  is the regression anchor.
- `<t>_lonly`: the VCTRL bias network alone (1 TH inductor to a 1.5 V source,
  no cp). This control must equal `_nocp`.
- `<t>_v<V>`: the loop plus the real idle cp, with VCTRL biased to V through
  the inductor, for the same 14 points. At 400 kHz the inductor is 2.5e15 Ohm
  against R1 = 344 kOhm. Its resonance with C1 + C2 is about 0.1 Hz, below
  the 10 Hz sweep start. The VCO integrator is driven by `v(vc) - v(vb)`. `vb`
  has no AC, so the AC loop is unchanged, but without this the DC bias winds
  the ideal integrator to about 1e23 V and the operating point fails. That
  happened on the first attempt and was fixed before any result was taken.

PM = 180 deg + `vp(fb)` at `|fb| = 0 dB` (ngspice `.meas`, linear
interpolation; the sweep is `dec 200 10 1e9` as before).

**Which VCTRL is graded.** Each tuple's Kvco is the secant of its own
interval (`../corners/matrix.md`): `low` is 0.3 to 0.9 V and `mid` is 0.9 to
1.5 V. So the loop really sits inside that interval. Two verdicts are reported
per tuple: the worst case over the tuple's **own interval** points, and the
worst case over the **full 0.3-2.9 V** range, as the issue's test plan asks.
The full-range figure is the more conservative of the two.

**Every corner evaluates every tuple's loops.** A `klt sim` request has one
netlist and cannot bind per-corner `.param` values to a process bundle (see
2AMLogic/klayout-tools#2725). So all four tuples' loops are in one deck, and
a tuple's result is read only from its own bundle's corner. The off-bundle
loops at the `typ` corner are used below only as a labelled sensitivity
estimate. They are never used as a verdict.

**Bundles**, as in `RECORD-002`..`004`: `fast` = `mos_ff` + `res_bcs` at
-40 C, `typ` = `mos_tt` + `res_typ` at 27 C, `slow` = `mos_ss` + `res_wcs` at
125 C.

## What was run, and what was not

| Request (`../testbench/`) | Corners | Backend | Ran? | Report (`../reports/`) |
|---|---|---|---|---|
| `cout_nominal.request.json` | `typ` (mos_tt / 27 C) | local, one corner | **yes**, pass (report-only) | `sim.cout_nominal.json` |
| `pm_ccp_nominal.request.json` | `typ` (mos_tt + res_typ / 27 C) | local, one corner | **yes**, pass (report-only) | `sim.pm_ccp_nominal.json` |
| `pm_ccp_bundles.request.json` | `fast`, `slow` (2) | batch fleet | **submitted, not run** (runner refused) | `sim.pm_ccp_bundles.batch.json` |
| `cout_bundles.request.json` | `fast`, `slow` (2) | batch fleet | **not run** (withdrawn before launch, same runner) | none |

**Why the grids did not run.** Host policy sends every corner grid to the
Spot batch fleet as a `klt sim` request and forbids a local grid.
`pm_ccp_bundles.request.json` was submitted once. It launched
(`m6i.4xlarge` spot, job `klt-sim-3a086f48e27a`) and exited 87 after 4 s.
The fleet runner runs `klt 0.5.0` against the `0.7.0+g5e5b55992a7f` client
(`runner_compatibility: mismatch`), so both corners came back
`batch_job_failed` and the request was not run. This is the same refusal
cp-icp-trim `RECORD-005` hit (2AMLogic/klayout-tools#2851 and #2901; data
point posted on #2851). `models.pdk` is omitted because the batch backend
refuses `ihp-sg13cmos5l` (#2727). `cout_bundles.request.json` would hit the
same runner, so it was withdrawn rather than spend another instance on a
known failure. **No corner other than `typ` was simulated for this record,
and no local grid was run.** The two batch requests are committed and ready
to re-submit.

## Result 1: the cp's idle VOUT capacitance (typ, 1 MHz)

From `../corners/cout_issue196.csv`:

| VOUT (V) | 0.3 | 0.5 | 0.7 | 0.9 | 1.1 | 1.3 | 1.5 | 1.7 | 1.9 | 2.1 | 2.3 | 2.5 | 2.7 | 2.9 |
|---|---|---|---|---|---|---|---|---|---|---|---|---|---|---|
| total, 11 uA (fF) | 11.64 | 11.75 | **13.28** | 12.21 | 10.42 | 10.05 | 9.92 | 9.83 | 9.78 | 9.75 | 9.95 | 14.82 | **16.58** | 14.99 |
| total, 3.75 uA (fF) | 11.35 | 11.67 | 12.54 | **10.49** | 10.07 | 9.93 | 9.84 | 9.76 | 9.71 | 9.67 | 9.66 | 10.41 | **15.81** | 14.92 |
| total, 10 uA (fF) | 11.61 | 11.74 | 13.23 | 12.04 | 10.34 | 10.03 | 9.91 | 9.83 | 9.77 | 9.74 | 9.87 | 14.51 | 16.53 | 14.98 |
| legs + switches only, 10 uA (fF) | 6.43 | 6.34 | 6.26 | 6.19 | 6.14 | 6.09 | 6.06 | 6.03 | 6.02 | 6.01 | 6.02 | 6.03 | 6.07 | 6.12 |
| buffer only, 10 uA (fF) | 5.17 | 5.40 | 6.97 | 5.85 | 4.20 | 3.94 | 3.85 | 3.79 | 3.75 | 3.73 | 3.86 | 8.48 | 10.46 | 8.85 |

- **The method reproduces the earlier buffer-only measurement.** The
  buffer-only row matches cp-icp-trim `RECORD-005`'s `cin_ff_*` at every
  point to the printed 0.01 fF (5.17 ... 10.46 ... 8.85).
- **The legs and switches add 6.0-6.4 fF.** The issue estimated about
  5-6 fF.
- **Total C_cp at 11 uA (DR-008)** is 11.6-13.3 fF over the `low` interval
  (max 13.28 fF at 0.7 V) and 9.7-16.6 fF over the full range (max
  **16.58 fF at 2.7 V**, 0.98% of C1). **At 3.75 uA (DR-007)** it is
  9.8-10.5 fF over the `mid` interval (max 10.49 fF at 0.9 V) and at most
  15.81 fF over the full range. The trim code matters only where the buffer's
  tails do (around 0.7-0.9 V and 2.5 V).
- **Frequency and conductance.** At 11 uA the 400 kHz and 1 MHz values agree
  to 0.01 fF except at 0.5 V (12.01 vs 11.75) and 2.9 V (15.35 vs 14.99). The
  conductance is -0.4 to +1.9 nS, which is negligible against R1. The PM bench
  carries both effects anyway, because it uses the real cp, not this table.

## Result 2: PM and f_c per tuple, before and after

Spec row 6/6a: PM >= 45 deg and f_c < f_ref/10 = 450 kHz. "Before" is the
committed `RECORD-003`/`004` value. The anchor is this bench with no cp. From
`../corners/results_resized_issue196_ccp.csv`:

| Tuple | Bundle | Code | PM before (deg) | Anchor, no cp (deg) | PM after, own interval (deg) [worst VCTRL] | PM after, full 0.3-2.9 V (deg) [worst VCTRL] | f_c after, max (Hz) | Verdict, own interval | Verdict, full range |
|---|---|---|---|---|---|---|---|---|---|
| DR-008 band 00 / low / 4.5 MHz | `typ` | 11 uA | 49.043 | 49.043 | **48.390** [0.7 V] | **48.231** [2.7 V] | 383449 | **pass** | **pass** |
| DR-008 band 00 / low / 4.5 MHz | `fast` | 11 uA | 45.592 | -- | **blocked** | **blocked** | -- | **not measured** | **not measured** |
| DR-008 band 00 / low / 4.5 MHz | `slow` | 11 uA | 53.454 | -- | **blocked** | **blocked** | -- | **not measured** | **not measured** |
| DR-007 band 00 / mid / 4.5 MHz | `slow` | 3.75 uA | 49.973 | -- | **blocked** | **blocked** | -- | **not measured** | **not measured** |

At `typ` the real cp costs DR-008's tuple **-0.653 deg** over the `low`
interval and **-0.812 deg** over the full range. The tuple still passes with
3.2-3.4 deg of margin. f_c falls from 385151 to at most 383449 Hz, 14.8% under
the ceiling.

**The regression anchor holds.** For `dr008_typ`, `_nocp` gives 49.043 deg /
385151 Hz against `RECORD-004`'s 49.043 deg / 385147.8 Hz. The 3 Hz difference
is `.meas` linear interpolation versus the old script's log interpolation.
The bias-only control gives 49.043 deg, so the bias network is invisible.

**Sanity check against the issue's analytic estimate.** That estimate was
about -0.9 deg for +16 fF at f_c = 0.5 MHz. This bench gives -0.81 deg at
f_c = 0.38 MHz with up to 16.6 fF (`typ`, full range). The two agree in sign
and size. In every case f_c moves *down* (by about 0.4-0.5%), so the
450 kHz ceiling only gains headroom.

## Verdict flips

**No flip was measured.** The one tuple that could be measured (`typ`) passes
before and after.

**One flip is projected: DR-008's `fast` tuple.** It closed with +0.592 deg
of margin (45.592 deg). The `dr008_fast` loops were also evaluated at the
`typ` corner, with the `fast` tuple's own Kd, Kv and N but `typ` models and
the `typ` cp. They lose **-0.658 deg** (own interval) and **-0.818 deg**
(full range) to the cp. Applied to the measured `fast` baseline, that
projects **about 44.93 deg (own interval) and 44.77 deg (full range)**, both
below the 45 deg floor. This is an estimate, not a verdict. The `fast`
corner's own models and cp capacitance were not simulated. It is filed as
**#203** (a measured `fast`/`slow` grid, then a new decision record if it
fails). DR-008 is not edited here.

The other blocked tuples project well clear. They use the same off-bundle
sensitivities (`dr008_slow` -0.848 deg, `dr007_slow` -0.705 deg, full range),
with the same caveat:

| Tuple | Before (deg) | Sensitivity at `typ` models, full range (deg) | Projected (deg) | Projected verdict |
|---|---|---|---|---|
| DR-008 `fast` | 45.592 | -0.818 (own interval -0.658) | 44.77 (44.93) | **fail (projected flip)** |
| DR-008 `slow` | 53.454 | -0.848 (own interval -0.682) | 52.61 | pass |
| DR-007 `slow` | 49.973 | -0.705 (own interval -0.470) | 49.27 | pass |

f_c moves down in every loop (by 0.4-0.5% at `typ`), so the f_c < f_ref/10
criterion cannot newly fail because of the cp. This matters most for DR-008
`slow`, which had only 3.28% of headroom.

## Spec-row disposition

- **Row 6a is not relaxed.** DR-007 and DR-008 are not edited.
- **Row 6/6a, DR-008 band 00 / low / f_ref 4.5 MHz, `typ`**: passes with
  the real cp's idle capacitance in the loop (48.231 deg worst case,
  schematic-level).
- **DR-008 `fast` and `slow`, and DR-007 `slow`: not re-verified.** They are
  blocked on the batch runner (klayout-tools#2851 / #2727). DR-008 `fast` is
  **projected to fail** row 6a by about 0.07-0.23 deg once the cp is
  included. Until #203 lands a measured grid, `RECORD-004`'s `fast` closure
  should be read as resting on the ideal-Gcp model and as at risk.

## What this does not bound

- **Layout parasitics.** Everything here is schematic-level (see Scope).
  `pll_cp`'s routed VOUT net and the DR-010 redraw (#195) add capacitance on
  the same node. The post-layout PM is owed to the PEX flow.
- **Supply corners and Monte Carlo.** VDD is 3.3 V throughout. No mismatch
  sampling was run.
- **The sampled-loop and dynamic cp effects.** This is still a linear,
  continuous-time open-loop AC bench. The cp's charge-sharing and switching
  terms are closed-loop transient territory
  (`sim/sg13cmos5l-closed-loop-lock`).
- **The other 28 (band, interval, f_ref) combinations of `RECORD-002`.** They
  were not re-run. Their PM margins are wider than the sub-1-deg ones
  re-checked here, but none is re-verified by this record.

## Reproduce

```bash
cd sim/sg13cmos5l-loop-bandwidth-pm/testbench
PDK_ROOT=$HOME/share/pdk python3 gen_issue196_ccp_requests.py   # regenerates decks + requests
klt sim cout_nominal.request.json   --backend local --format json > ../reports/sim.cout_nominal.json
klt sim pm_ccp_nominal.request.json --backend local --format json > ../reports/sim.pm_ccp_nominal.json
# grids: batch fleet only, never locally
klt sim cout_bundles.request.json   --format json
klt sim pm_ccp_bundles.request.json --format json
python3 summarize_issue196.py      # writes ../corners/{cout_issue196,results_resized_issue196_ccp}.csv
```

Both local runs were repeated in a fresh `klt sim` invocation. The
measurement values were identical to every printed digit.
