2AMLogic/sg13g2-pll/sim/sg13cmos5l-loop-bandwidth-pm/testbench/tb_cp_cout_issue196.sp

* sg13g2-pll :: sim/sg13cmos5l-loop-bandwidth-pm (issue #196, RECORD-005)
* GENERATED by gen_issue196_ccp_requests.py -- do not edit by hand.
* Circuit body for `klt sim` (AC, 400 kHz / 700 kHz / 1 MHz). Total idle-state (UP =
* DN = 0) capacitance the cp presents on VOUT: each instance is alone on its
* own 0 V ammeter Vm_<inst> from the shared source Vs_<k> (no baseline is
* subtracted), so imag(i(Vm))/omega is the whole cp ("real cp vs no cp").
.include ../netlist-snapshots/cp_otabuf.spice

* buffer-less baseline: the snapshot's cp top-level subckt with XBUF -> EDUMP
.subckt cp_idealdump UP DN IBP ICP IBN ICN VOUT VDD VSS
*.ipin UP
*.ipin DN
*.iopin IBP
*.iopin ICP
*.iopin IBN
*.iopin ICN
*.opin VOUT
*.iopin VDD
*.iopin VSS
XIUP UP UPB VDD VSS inv_hv
XIDN DN DNB VDD VSS inv_hv
XLEGP IBP ICP UP UPB VOUT VDUMP VDD cp_leg_p
XLEGN IBN ICN DN DNB VOUT VDUMP VSS cp_leg_n
EDUMP VDUMP VSS VOUT VSS 1
XMBP nxp IBP VDD VDD sg13_hv_pmos w=24u l=1u ng=1 m=1
XMBPC IBP ICP nxp VDD sg13_hv_pmos w=24u l=1u ng=1 m=1
XMCP ICP ICP VDD VDD sg13_hv_pmos w=6u l=3u ng=1 m=1
XMBN nxn IBN VSS VSS sg13_hv_nmos w=8u l=1u ng=1 m=1
XMBNC IBN ICN nxn VSS sg13_hv_nmos w=8u l=1u ng=1 m=1
XMCN ICN ICN VSS VSS sg13_hv_nmos w=2u l=3u ng=1 m=1
.ends

Vdd VDD 0 dc 3.3
Xc375_0 0 0 ibp_c375_0 icp_c375_0 ibn_c375_0 icn_c375_0 vo_c375_0 VDD 0 cp
Irbp_c375_0 ibp_c375_0 0 dc 3.75u
Ircp_c375_0 icp_c375_0 0 dc 3.75u
Irbn_c375_0 0 ibn_c375_0 dc 3.75u
Ircn_c375_0 0 icn_c375_0 dc 3.75u
Vm_c375_0 vs_0 vo_c375_0 dc 0
Xc10_0 0 0 ibp_c10_0 icp_c10_0 ibn_c10_0 icn_c10_0 vo_c10_0 VDD 0 cp
Irbp_c10_0 ibp_c10_0 0 dc 10u
Ircp_c10_0 icp_c10_0 0 dc 10u
Irbn_c10_0 0 ibn_c10_0 dc 10u
Ircn_c10_0 0 icn_c10_0 dc 10u
Vm_c10_0 vs_0 vo_c10_0 dc 0
Xc11_0 0 0 ibp_c11_0 icp_c11_0 ibn_c11_0 icn_c11_0 vo_c11_0 VDD 0 cp
Irbp_c11_0 ibp_c11_0 0 dc 11u
Ircp_c11_0 icp_c11_0 0 dc 11u
Irbn_c11_0 0 ibn_c11_0 dc 11u
Ircn_c11_0 0 icn_c11_0 dc 11u
Vm_c11_0 vs_0 vo_c11_0 dc 0
Xb10_0 0 0 ibp_b10_0 icp_b10_0 ibn_b10_0 icn_b10_0 vo_b10_0 VDD 0 cp_idealdump
Irbp_b10_0 ibp_b10_0 0 dc 10u
Ircp_b10_0 icp_b10_0 0 dc 10u
Irbn_b10_0 0 ibn_b10_0 dc 10u
Ircn_b10_0 0 icn_b10_0 dc 10u
Vm_b10_0 vs_0 vo_b10_0 dc 0
Vs_0 vs_0 0 dc 0.3 ac 1
Xc375_1 0 0 ibp_c375_1 icp_c375_1 ibn_c375_1 icn_c375_1 vo_c375_1 VDD 0 cp
Irbp_c375_1 ibp_c375_1 0 dc 3.75u
Ircp_c375_1 icp_c375_1 0 dc 3.75u
Irbn_c375_1 0 ibn_c375_1 dc 3.75u
Ircn_c375_1 0 icn_c375_1 dc 3.75u
Vm_c375_1 vs_1 vo_c375_1 dc 0
Xc10_1 0 0 ibp_c10_1 icp_c10_1 ibn_c10_1 icn_c10_1 vo_c10_1 VDD 0 cp
Irbp_c10_1 ibp_c10_1 0 dc 10u
Ircp_c10_1 icp_c10_1 0 dc 10u
Irbn_c10_1 0 ibn_c10_1 dc 10u
Ircn_c10_1 0 icn_c10_1 dc 10u
Vm_c10_1 vs_1 vo_c10_1 dc 0
Xc11_1 0 0 ibp_c11_1 icp_c11_1 ibn_c11_1 icn_c11_1 vo_c11_1 VDD 0 cp
Irbp_c11_1 ibp_c11_1 0 dc 11u
Ircp_c11_1 icp_c11_1 0 dc 11u
Irbn_c11_1 0 ibn_c11_1 dc 11u
Ircn_c11_1 0 icn_c11_1 dc 11u
Vm_c11_1 vs_1 vo_c11_1 dc 0
Xb10_1 0 0 ibp_b10_1 icp_b10_1 ibn_b10_1 icn_b10_1 vo_b10_1 VDD 0 cp_idealdump
Irbp_b10_1 ibp_b10_1 0 dc 10u
Ircp_b10_1 icp_b10_1 0 dc 10u
Irbn_b10_1 0 ibn_b10_1 dc 10u
Ircn_b10_1 0 icn_b10_1 dc 10u
Vm_b10_1 vs_1 vo_b10_1 dc 0
Vs_1 vs_1 0 dc 0.5 ac 1
Xc375_2 0 0 ibp_c375_2 icp_c375_2 ibn_c375_2 icn_c375_2 vo_c375_2 VDD 0 cp
Irbp_c375_2 ibp_c375_2 0 dc 3.75u
Ircp_c375_2 icp_c375_2 0 dc 3.75u
Irbn_c375_2 0 ibn_c375_2 dc 3.75u
Ircn_c375_2 0 icn_c375_2 dc 3.75u
Vm_c375_2 vs_2 vo_c375_2 dc 0
Xc10_2 0 0 ibp_c10_2 icp_c10_2 ibn_c10_2 icn_c10_2 vo_c10_2 VDD 0 cp
Irbp_c10_2 ibp_c10_2 0 dc 10u
Ircp_c10_2 icp_c10_2 0 dc 10u
Irbn_c10_2 0 ibn_c10_2 dc 10u
Ircn_c10_2 0 icn_c10_2 dc 10u
Vm_c10_2 vs_2 vo_c10_2 dc 0
Xc11_2 0 0 ibp_c11_2 icp_c11_2 ibn_c11_2 icn_c11_2 vo_c11_2 VDD 0 cp
Irbp_c11_2 ibp_c11_2 0 dc 11u
Ircp_c11_2 icp_c11_2 0 dc 11u
Irbn_c11_2 0 ibn_c11_2 dc 11u
Ircn_c11_2 0 icn_c11_2 dc 11u
Vm_c11_2 vs_2 vo_c11_2 dc 0
Xb10_2 0 0 ibp_b10_2 icp_b10_2 ibn_b10_2 icn_b10_2 vo_b10_2 VDD 0 cp_idealdump
Irbp_b10_2 ibp_b10_2 0 dc 10u
Ircp_b10_2 icp_b10_2 0 dc 10u
Irbn_b10_2 0 ibn_b10_2 dc 10u
Ircn_b10_2 0 icn_b10_2 dc 10u
Vm_b10_2 vs_2 vo_b10_2 dc 0
Vs_2 vs_2 0 dc 0.7 ac 1
Xc375_3 0 0 ibp_c375_3 icp_c375_3 ibn_c375_3 icn_c375_3 vo_c375_3 VDD 0 cp
Irbp_c375_3 ibp_c375_3 0 dc 3.75u
Ircp_c375_3 icp_c375_3 0 dc 3.75u
Irbn_c375_3 0 ibn_c375_3 dc 3.75u
Ircn_c375_3 0 icn_c375_3 dc 3.75u
Vm_c375_3 vs_3 vo_c375_3 dc 0
Xc10_3 0 0 ibp_c10_3 icp_c10_3 ibn_c10_3 icn_c10_3 vo_c10_3 VDD 0 cp
Irbp_c10_3 ibp_c10_3 0 dc 10u
Ircp_c10_3 icp_c10_3 0 dc 10u
Irbn_c10_3 0 ibn_c10_3 dc 10u
Ircn_c10_3 0 icn_c10_3 dc 10u
Vm_c10_3 vs_3 vo_c10_3 dc 0
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
Xb10_13 0 0 ibp_b10_13 icp_b10_13 ibn_b10_13 icn_b10_13 vo_b10_13 VDD 0 cp_idealdump
Irbp_b10_13 ibp_b10_13 0 dc 10u
Ircp_b10_13 icp_b10_13 0 dc 10u
Irbn_b10_13 0 ibn_b10_13 dc 10u
Ircn_b10_13 0 icn_b10_13 dc 10u
Vm_b10_13 vs_13 vo_b10_13 dc 0
Vs_13 vs_13 0 dc 2.9 ac 1
