2AMLogic/sg13g2-pll/sim/sg13g2-hbt-characterization/layout-probe/npn_probe.extracted.spice

* extracted by klt extract --deck sg13g2

* cell npn_probe
* pin vsubs
.SUBCKT npn_probe vsubs
.ENDS npn_probe
