2AMLogic/sg13g2-pll/sim/sg13g2-hbt-characterization/layout-probe/npn_probe.reference.spice

* Reference netlist for the minimal npn13G2 probe cell (one device, Nx=1).
.subckt npn_probe c b e sub
XQ1 c b e sub npn13G2 Nx=1
.ends npn_probe
