2AMLogic/sg13g2-pll/layout/pll/reports/20261027-175143-74cf8d0-dirty/divider_chain_nfet_w2_l0p5.spice

* extracted by klt extract --deck sg13g2

* cell divider_chain_nfet_w2_l0p5
* pin vsubs
.SUBCKT divider_chain_nfet_w2_l0p5 vsubs
* device instance $1 r0 *1 0.67,1 nfet
M$1 \$199 \$1 \$198 vsubs nfet L=0.5U W=2U AS=0.84P AD=0.84P PS=4.84U PD=4.84U
* device instance $2 r0 *1 2.41,1 nfet
M$2 \$201 \$2 \$200 vsubs nfet L=0.5U W=2U AS=0.84P AD=0.84P PS=4.84U PD=4.84U
* device instance $3 r0 *1 4.15,1 nfet
M$3 \$203 \$3 \$202 vsubs nfet L=0.5U W=2U AS=0.84P AD=0.84P PS=4.84U PD=4.84U
* device instance $4 r0 *1 5.89,1 nfet
M$4 \$205 \$4 \$204 vsubs nfet L=0.5U W=2U AS=0.84P AD=0.84P PS=4.84U PD=4.84U
* device instance $5 r0 *1 7.63,1 nfet
M$5 \$207 \$5 \$206 vsubs nfet L=0.5U W=2U AS=0.84P AD=0.84P PS=4.84U PD=4.84U
* device instance $6 r0 *1 9.37,1 nfet
M$6 \$209 \$6 \$208 vsubs nfet L=0.5U W=2U AS=0.84P AD=0.84P PS=4.84U PD=4.84U
* device instance $7 r0 *1 11.11,1 nfet
M$7 \$211 \$7 \$210 vsubs nfet L=0.5U W=2U AS=0.84P AD=0.84P PS=4.84U PD=4.84U
* device instance $8 r0 *1 12.85,1 nfet
M$8 \$213 \$8 \$212 vsubs nfet L=0.5U W=2U AS=0.84P AD=0.84P PS=4.84U PD=4.84U
* device instance $9 r0 *1 14.59,1 nfet
M$9 \$215 \$9 \$214 vsubs nfet L=0.5U W=2U AS=0.84P AD=0.84P PS=4.84U PD=4.84U
* device instance $10 r0 *1 16.33,1 nfet
M$10 \$217 \$10 \$216 vsubs nfet L=0.5U W=2U AS=0.84P AD=0.84P PS=4.84U PD=4.84U
* device instance $11 r0 *1 18.07,1 nfet
M$11 \$219 \$11 \$218 vsubs nfet L=0.5U W=2U AS=0.84P AD=0.84P PS=4.84U PD=4.84U
* device instance $12 r0 *1 19.81,1 nfet
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
* device instance $187 r0 *1 324.31,1 nfet
M$187 \$571 \$187 \$570 vsubs nfet L=0.5U W=2U AS=0.84P AD=0.84P PS=4.84U
+ PD=4.84U
* device instance $188 r0 *1 326.05,1 nfet
M$188 \$573 \$188 \$572 vsubs nfet L=0.5U W=2U AS=0.84P AD=0.84P PS=4.84U
+ PD=4.84U
* device instance $189 r0 *1 327.79,1 nfet
M$189 \$575 \$189 \$574 vsubs nfet L=0.5U W=2U AS=0.84P AD=0.84P PS=4.84U
+ PD=4.84U
* device instance $190 r0 *1 329.53,1 nfet
M$190 \$577 \$190 \$576 vsubs nfet L=0.5U W=2U AS=0.84P AD=0.84P PS=4.84U
+ PD=4.84U
* device instance $191 r0 *1 331.27,1 nfet
M$191 \$579 \$191 \$578 vsubs nfet L=0.5U W=2U AS=0.84P AD=0.84P PS=4.84U
+ PD=4.84U
* device instance $192 r0 *1 333.01,1 nfet
M$192 \$581 \$192 \$580 vsubs nfet L=0.5U W=2U AS=0.84P AD=0.84P PS=4.84U
+ PD=4.84U
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
