2AMLogic/sg13g2-pll/sim/sg13cmos5l-closed-loop-lock/corners/log_cppulse_ideal_dump_rerun239.txt

=== cp pulse-charge bench variant=ideal_dump ===
ngspice exit status: 0
i_cp_avg_quiet      =  -3.00001e-05 from=  2.00000e-08 to=  9.00280e-08
i_out_quiet         =  -4.73463e-15 from=  2.00000e-08 to=  9.00280e-08
vdump_quiet         =  2.38700e+00 from=  2.00000e-08 to=  9.00280e-08
i_cp_avg_quiet = -3.00001e-05
i_out_quiet = -4.73464e-15
vdump_quiet = 2.387000e+00
[ideal_dump_rerun239] up: I=10.0002 uA  Q0=-4.394 fC  resid=0.003 fC
[ideal_dump_rerun239] dn: I=-10.0266 uA  Q0=-3.515 fC  resid=0.003 fC
[ideal_dump_rerun239] both: I=-0.0263 uA  Q0=-8.099 fC  resid=0.003 fC
