2AMLogic/sg13g2-pll/(commit log)

2026-08-20 Initial commit: phase-locked loop on IHP SG13G2
    Scaffolds the block: spec, schematics, ngspice sim, and klayout-tools-driven
    layout signoff.
    Second block on the third PDK. The design is deliberately a proven one — a
    port of the fleet's gf180 and sky130 integer-N PLLs — so that anything which
    breaks is attributable to the PDK, the deck, or the tools rather than the
    circuit. SG13G2's real SiGe bipolar devices are the interesting variable:
    they widen the option space exactly where a PLL is sensitive (VCO, charge
    pump, dividers) and hand the young decks a device class they have barely met.
    Unlike sg13g2-bandgap at its opening, this repo starts unblocked: klt
    resolves SG13G2 and a curated D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
2026-08-20 docs: add porting plan from gf180-pll and sky130-pll to spec/ (#2)
    Adds spec/porting-plan.md: a per-block breakdown of what carries over
    from the sibling PLL ports as-is, with a device swap, or must be
    re-derived on SG13G2; what SG13G2's SiGe HBT devices add to the VCO,
    charge pump, and divider option space plus the 1.2V/3.3V/bipolar
    supply-flavor decision; and what the current starter-grade SG13G2
    klayout-tools deck cannot check yet (thick-oxide MOS misclassifies as
    thin-oxide, no bipolar/resistor/capacitor device recognition), read
    directly from the deck's own source. Links spec/README.md to the new
    document.
2026-08-24 docs(spec): ratify PLL architecture + supply/device-flavor decision records (#9)
    Adds DR-001 (loop type, VCO topology, feedback divider architecture) and
    DR-002 (CMOS supply/device flavor + per-element bipolar insertions), the
    two prerequisite decision records spec/porting-plan.md's own closing
    Summary names before any block's schematic/sizing work (#7, #6) can start.
    - DR-001: confirms the type-II charge-pump loop; keeps the ported
    current-starved CMOS ring, explicitly rejecting an HBT-based LC-tank VCO
    for v1 (phase-noise-evidence gap + 20:1 tuning-range mismatch); picks
    gf180-pll's cascaded ÷2/3 (Vaucher) divider over sky130-pll's synchronous
    down-counter, resolving the disagree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
2026-08-25 feat(design): port PLL block schematics to SG13G2 3.3V thick-oxide CMOS (#10)
    Ports the six blocks spec/porting-plan.md Sec1.4 names (PFD, charge pump,
    loop filter, VCO, feedback divider, lock detector) plus their supporting
    leaf cells from gf180-pll's reference design onto SG13G2's sg13_hv_nmos/
    sg13_hv_pmos devices, per DR-001 (architecture) and DR-002 (3.3V
    thick-oxide CMOS throughout, no bipolar in v1). Adds design/netlist.sh to
    regenerate the committed design/netlist/*.spice exports from the
    schematics (checked via --check), and documents the per-block layout,
    first-pass sizing/topology simplifications, and already-tracked upstream
    klayout-tools LVS-deck gaps in design/README.md.
    All 2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
    [cp.sch, cp_dumpbuf.sch, cp_leg_n.sch, cp_leg_p.sch, delaywin_hv.sch, dff_tg_hv.sch, div23_cell.sch, divider_chain.sch]
2026-08-25 ratification: install the two-key reviewer variant (EE key + market key) (#4)
    Installs the generated public reviewer variants — ratification/ee-key/
    and ratification/market-key/ — scoped to this repo's block class
    (pll), mirroring the six prior installs (e.g. gf180-pll#176).
    Part of 2AMLogic/2am#525 (2AMLogic/2am#372 Phase C2 follow-up, Pass 1 of
    the "5 ready canaries" batch).
2026-08-27 ratification: fix inaccurate market-key MANIFEST.md comp-data list (#12)
    The section listed all 4 original COMP_CLASSES entries
    (ldo, pll, sar-adc, bandgap) instead of the single comp file this repo
    actually carries in ratification/market-key/comps/ — the installer
    committed generate-canary-variant.py's raw output instead of hand-scoping
    it per canary-variant.md's install procedure.
    Not a disclosure leak (every listed filename names another public
    canary's own block class); a documentation-accuracy fix only.
    Part of 2AMLogic/2am#589
2026-08-29 layout: derive PLL device-level plan; klt gen blocked for sg13g2 (Part of #13) (#14)
    Adds layout/bin/pll_layout.py, a schematic-driven device plan derived from
    design/netlist/*.spice (six blocks, 482 devices total, recursively
    flattened through each block's own sub-cell hierarchy), plus PDK-free unit
    tests covering the derivation (layout/tests/test_pll_layout_plan.py, 27
    tests) and the DR-002 3.3V-thick-oxide-only device-flavor guard.
    Re-verifying klt gen end-to-end against the exact commit that merged
    klayout-tools#1449 (closing this issue's former dependency, #1448) found
    that closing #1448 did not, in practice, unblock drawing this design:
    mos_array/diff_pair reject the sg13g2 PDK family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
2026-08-29 layout: draw, extract, and compose the PLL device-level layout on sg13g2 (Closes #13) (#15)
    klayout-tools#1448's closure did not, by itself, unblock sg13g2 device
    generation (PR #14's own finding) -- mos_array/diff_pair and res_array
    still hard-rejected the family. Both gaps have since been fixed upstream
    (klayout-tools#1450 via klayout-tools PR #1453, #1451 via PR #1452); bump
    layout/requirements.txt's pin to the main commit that carries both fixes
    and extend layout/bin/pll_layout.py from a plan-only derivation to a real
    draw (klt gen) -> extract (klt extract --deck sg13g2) -> compose
    (klt gen-compose, placement only) flow, with a schematic-vs-extraction
    cross-check per group and per compos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
2026-08-29 docs: audit SG13CMOS5L port readiness for the PLL (DR-003) (#21)
    Reads the installed ihp-sg13cmos5l PDK directly against this design's
    committed netlists: MOSFETs and poly resistors need no device-name change,
    but every cap_cmim instance (loop_filter, vco, lock_detector) has no MIM
    equivalent on SG13CMOS5L and must become cap_cmomi/cap_cmomf with an
    unvalidated, no-corner/mismatch model. Also records a rail-interpretation
    recommendation for the brief's 1.2V/3.3V split and a klayout-tools deck
    tooling gate for the layout phase.
    Part of #16
2026-08-30 schematic: port PLL blocks to SG13CMOS5L (MIM->MoM swap, rail ratification) (#26)
    Draws design/sg13cmos5l/ as a parallel-PDK schematic tree (24 .sch/.sym
    pairs mirroring design/'s flat namespace): MOSFETs/rppd/rhigh need only a
    symbol-library path change per DR-003 Finding 1, and the four cap_cmim (MIM)
    instances become cap_cmomi (MOM) with worked-out mmin/mmax/feed/subblock/
    mm_ok parameters and provisional placeholder sizing. design/sg13cmos5l/
    netlist.sh mirrors design/netlist.sh's --top/--check interface and
    net-lists all six blocks cleanly against the installed ihp-sg13cmos5l PDK;
    design/netlist.sh --check confirms the SG13G2 target is unchanged.
    DR-004 ratifies DR-003 Finding 3's rail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
    [cp.sch, cp_dumpbuf.sch, cp_leg_n.sch, cp_leg_p.sch, delaywin_hv.sch, dff_tg_hv.sch, div23_cell.sch, divider_chain.sch]
2026-08-30 sim: PVT + MOM-cap sensitivity campaign for SG13CMOS5L loop_filter/vco decap (Part of #23) (#28)
    Establishes the sim/ evidence-record convention (previously unused by
    either PDK campaign) and delivers the specific obligation
    DR-003-sg13cmos5l-port-readiness.md Finding 2 names: a PVT-cornered
    sensitivity sweep of the three cap_cmomi MOM-cap instances
    (loop_filter.XC1/XC2, vco.XCDECAP) against the installed PDK's own
    unvalidated, corner/mismatch-free MOM-cap model.
    - sim/sg13cmos5l-loop-filter-momcap: real ngspice extraction of R1
    (rppd, 3 process corners x 3 temps) and C1/C2 (cap_cmomi, +/-20%
    MOM-uncertainty band), closed-form zero/pole derivation, cross-checked
    against a direct AC im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
    [results.csv]
2026-08-30 layout: SG13CMOS5L device-level layout — 477/482 devices DRC-clean and schematic-matched (Closes #24) (#32)
    * layout: SG13CMOS5L device-level layout flow + klt pin bump (Part of #24)
    Adds the SG13CMOS5L sibling of the SG13G2 device-level layout flow, and
    bumps the pinned klayout-tools build.
    - layout/bin/cmos5l_devices.py: SG13CMOS5L device footprints (HV NMOS/PMOS,
    rppd/rhigh poly resistors, shared-well n+ tap, p+ substrate tap), adapted
    from 2AMLogic/sg13g2-bandgap's fleet-proven common_sg13cmos5l.py with
    every constant's PDK source cited. Needed because every `klt gen`
    generator rejects the ihp-sg13cmos5l PDK family (filed upstream as
    klayout-tools#1462) -- the verification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
2026-08-30 sim: SG13CMOS5L VCO Kvco-vs-band-code table (open-loop PVT sweep, Part of #23) (#33)
    Delivers a real, PVT-cornered open-loop measurement of spec/porting-plan.md
    row 4/5 (the Kvco-vs-band-code table) for the SG13CMOS5L `vco`, continuing
    the sim campaign issue #23 owns after PR #28's MOM-cap-sensitivity
    increment: 60 real ngspice transient runs (3 PVT bundles x 4 band codes x
    5 VCTRL points), each measuring the ring's own steady-state CLK period via
    a real oscillation, not a hand estimate.
    Findings worth recording: band select is nearly inert at low VCTRL and
    dominant at high VCTRL (the V-I converter transistor is in cutoff at low
    VCTRL regardless of which degeneration branch is selected), an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
    [results.csv]
2026-08-30 docs: write challenge-6-proposal.md for the SG13CMOS5L PLL port (#34)
    Re-derives every spec/porting-plan.md §1.2 row from the real sim/ and
    layout/ evidence #23 (PRs #28/#33) and #24 (PR #32) already landed: the
    loop_filter/vco.XCDECAP MOM-cap PVT sensitivity sweeps, the open-loop
    Kvco-vs-band-code table, and the 477/482-device DRC-clean, LVS-mismatch
    device-level layout. Rows the existing evidence cannot bound (loop
    bandwidth/phase margin, lock time, reference spur, power, duty cycle,
    lock-detector window, area) are marked insufficient-evidence rather than
    relaxed to pass, per CLAUDE.md's ratified-spec discipline — the remaining
    closed-loop campaign is tracked separately as issue #27.
    C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
2026-08-30 sim: SG13CMOS5L closed-loop PVT campaign — Icp-trim, loop bandwidth/PM, duty cycle (#42)
    * sim: measure SG13CMOS5L Icp trim table and close the loop-bandwidth/phase-margin row
    Adds two append-only sim/ evidence records that together clear the
    insufficient-evidence marking issue #23's records left on
    spec/porting-plan.md row 6/6a.
    - sim/sg13cmos5l-cp-icp-trim: 306 real ngspice DC sweeps of the committed
    cp block (5 MOS corners x 3 temps x a 2-point supply sub-axis x 6 trim
    codes x 3 UP/DN states). The current-mirror-referenced trim ladder tracks
    its reference to within 0.14% across the whole PVT matrix; up/down
    mismatch is -2.5% to -6.1% at mid-rail and reaches -8.1% of Icp at the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
    [compliance.csv, mom_band.csv, proposal.csv, results.csv, tstep_convergence.csv]
2026-08-30 layout: route the SG13CMOS5L PLL blocks and close LVS — 3/3 convertible blocks `match` (Closes #29) (#39)
    * layout: route the SG13CMOS5L PLL blocks (per-net Metal3 channel, Part of #16)
    Draws real interconnect for all six SG13CMOS5L blocks, derived entirely from
    `plan.json`'s own `groups[].members[].ports` port->net map (schematic-derived,
    never typed in), so the composed cells extract with the schematic's own net
    names instead of anonymous `$N` nodes.
    The routing scheme (`layout/bin/cmos5l_route.py`) is a per-net-track channel
    router: one vertical `Metal2` riser per device terminal at its own x column,
    one horizontal `Metal3` trunk per net on its own y track above the block,
    `Via1`/`Via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
2026-08-30 spec: DR-005 reconciles f_ref (row 2) and N (row 3) against the measured VCO band (Part of #16) (#46)
    Rows 2/3 and the measured sg13cmos5l-vco-kvco-table result cannot hold
    simultaneously (f_out = N x f_ref): the ported N=4 floor needs f_ref >= 111
    MHz to reach the VCO's measured 445.3 MHz floor, far outside any credible
    reference-frequency range. DR-005 amends row 3's N range to the divider's
    own structural [64,127] (6-cell Vaucher chain, no holes) and row 2's f_ref
    range to ~3.5-24.4 MHz (measured VCO band / new N endpoints), and shows why
    amending either row alone, or restoring gf180-pll's chain-termination mux,
    does not resolve the contradiction. Row 6/6a is left unamended (no f_ref
    numb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
2026-08-30 layout: re-bump klt past klayout-tools#1461, draw sg13g2's MiM caps (#47)
    Bumps layout/requirements.txt's pinned klayout-tools commit past PR #1461
    (closing #1455), which gives klt gen cap_array a real sg13g2 MiM-capacitor
    plate-layer configuration. pll_layout.py now plans and attempts a
    cap_array request for cap_cmim (keyed per-model via CAP_GENERATORS, not
    per-kind, since kind == "capacitor" now covers both a drawable model and
    the still-blocked SG13CMOS5L cap_cmomi), and _match_group_extraction
    gained an area_um2/perimeter_um comparison branch since a two-plate
    capacitor extracts geometric overlap rather than a single W/L.
    Result: the SG13G2 record moves from 477/482 to 482/482 devices d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
2026-08-30 refactor: dedupe design/netlist.sh into shared design/lib/netlist-export.sh (#48)
    design/netlist.sh (SG13G2) and design/sg13cmos5l/netlist.sh (SG13CMOS5L)
    implemented the identical xschem-export pipeline verbatim -- arg parsing,
    the BLOCKS list, expected_subckts(), check_export(), normalize(), banner(),
    export_block(), and the --check/write drivers -- differing only in a
    design/ vs design/sg13cmos5l/ path prefix and PDK-identifying strings.
    Extract the shared pipeline into design/lib/netlist-export.sh, parameterized
    by DESIGN_REL, SCRIPT_REL, USAGE_NAME, and BANNER_SUFFIX. Both wrappers now
    set those four variables and source the shared script, dropping each from
    ~210 lines to under 50.
    Ve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
2026-08-30 layout: keep the local SG13CMOS5L footprints, with the measurement that decides it (#49)
    * feat: re-measure klt gen footprints and gen-compose block routing every run
    The SG13CMOS5L flow drew its own MOS/resistor footprints and its own
    interconnect because every `klt gen` generator and `klt gen-compose`'s
    router rejected the `ihp-sg13cmos5l` PDK family (klayout-tools#1462).
    That gap closed upstream and this repo's pin carries it, so the record's
    own evidence for the local code had gone stale: the committed two-pad
    `gen-compose` probe only answers "is the family accepted", which is far
    too small a cell to exercise the finding the local router actually rests
    on (klayout-tools#1467, measured o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
2026-08-30 sim: SG13CMOS5L closed-loop transient — lock time, reference spur, power (Part of #16) (#51)
    Builds a transistor-level closed-loop testbench (pfd+cp+loop_filter+vco+
    divider_chain+lock_detector, testbench-local integration — no pll_top
    schematic exists) and attempts spec rows 7 (lock time), 10 (reference
    spur), and 11 (whole-PLL power).
    Runs both decks the issue's own precondition calls for: Part A (as-drawn,
    committed design) and Part B (proposal: R1 x20 + behavioural divider,
    explicitly not committed). Neither acquires lock within the simulated
    window (single PVT point, runtime-cost subset — ~50 min wall for one
    point on this host) — Part A because the real divider_chain's fb outp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
    [lock_trace_as_drawn.csv, lock_trace_proposal.csv, results_as_drawn.csv, results_proposal.csv]
2026-08-30 sim: SG13CMOS5L lock_detector window/hysteresis/chatter + XCW/XDW.XC1 MOM sweep (Part of #38) (#53)
    Real-subckt lock_detector PVT campaign (92 corner points: 5 MOS corners x
    resistor-corner bundles x 3 temps x 4 MOM-band variants, plus supply and
    reference-frequency sub-axes) measuring the assert window, hysteresis and
    chatter behavior spec/porting-plan.md row 16 targets, closing the
    XCW/XDW.XC1 MOM-uncertainty gap design/README.md flagged as open, and
    recording the block's own supply current for row 11.
    Finding: the block fails all three row-16 criteria at every corner tested.
    Window = 0.219-0.409 ns (6-11x below the >=2.5 ns floor); no hysteresis
    resolves at the ladder's 0.15x-window step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
    [ladder.csv, ladder_raw.csv, rc_extract.csv, schmitt.csv, tstep_convergence.csv, window.csv]
2026-08-30 sim: fix unexpanded $PDK_ROOT/$PDK in five already-merged .sp.tmpl testbenches (#55)
    ngspice's .lib/.include netlist parser does not expand shell/OS environment
    variables -- $PDK_ROOT/$PDK inside a .lib/.include line was passed to the
    library loader literally, failing every run with a fatal "library file ...
    not found" error that each run.sh's stderr suppression silently absorbed
    into a false NA/no-oscillation result.
    Fixes all five instances the issue's curator enhancement identified as
    pre-dating PR #42 (out of #44's scope): vco-kvco-table's tb_vco_kvco.sp.tmpl,
    loop-filter-momcap's tb_extract_r.sp.tmpl/tb_extract_c.sp.tmpl, and
    vco-decap-momcap's tb_decap_pole_ac.sp.tmpl/tb_extract_cdeca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
2026-08-30 sim: root-cause SG13CMOS5L closed-loop proposal-deck non-convergence (Part of #16) (#50) (#57)
    RECORD-002 traces #37's own open question (Part B drifts monotonically
    away from lock, a UP/DN pin-swap ruled out) to a real self-reset
    inverter-parity defect in the committed pfd netlist: two inversions after
    NAND(UP,DN) hand `reset` back the same NAND sense instead of AND(UP,DN),
    so UP/DN collapse into phase-blind edge blips. A standalone PFD-only
    testbench shows the as-drawn PFD's UP/DN duty cycles are identical
    regardless of which of REF/FB leads; a diagnostic 3rd-inverter patch
    restores textbook tri-state behaviour there and changes Part B's own
    closed-loop Δf trajectory from accelerating div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
    [lock_trace_proposal_pfdfix.csv, pfd_polarity_diag.csv]
2026-08-30 sim: resolve $PDK_ROOT/$PDK in lock-detector-window testbenches; stop swallowing ngspice errors (#58)
    All five `.sp.tmpl` decks in sim/sg13cmos5l-lock-detector-window/testbench
    spelled the PDK path into their `.lib`/`.include` lines as a literal
    `$PDK_ROOT/$PDK`. ngspice only resolves such a `$VAR` if it is present in
    ngspice's own process environment; otherwise the deck dies with
    `Error: Cannot read environmental variable PDK_ROOT` / `fatal error in
    ngspice, exit(1)`. Switch them to the `@PDK_ROOT@`/`@PDK@` tokens PR #55
    established for the sibling issue #43, substituted by run.sh's existing sed
    lines (and, for the ladder skeleton, by gen_ladder.py's new
    --pdk-root/--pdk arguments, whose un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
2026-08-30 sim: SG13CMOS5L divider chain functional N range + retiming margin (Part of #16) (#60)
    Runs the divider_chain testbench a previous exploratory attempt (#27) left
    unpublished, fixing the run.sh set -euo pipefail bug that silently killed it
    before any data was written. Finding: the committed dff_tg_hv's hold-path
    feedback is a single-inversion loop (a self-biased inverter, not a real
    latch), so the as-drawn chain never holds state and does not divide at any
    tested corner. A non-committed proposal variant with a minimal hold-path fix
    holds cleanly and divides by exactly N=64 at a low-frequency baseline,
    matching the structural N in [64,127] range DR-005 already derived, but its
    own setup-time s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
    [func.csv, hold.csv, opconv.csv, retime.csv, setup.csv]
2026-08-30 sim: cap_cmomi/cap_cmomf OSDI is a rebuildable provisioning gap, not an x86-64-only limitation (Closes #59) (#62)
    * sim: cap_cmomi/cap_cmomf OSDI is a rebuildable provisioning gap, not a permanent x86-64-only limitation (Closes #59)
    The two MOM-capacitor OSDI objects are architecture-specific binaries
    TRACKED in the upstream ihp-sg13cmos5l git repository as prebuilt x86-64
    ELF, while psp103/psp103_nqs/mosvar/r3_cmc are host-local build products
    of the sibling ihp-sg13g2 tree. That split -- upstream states it itself
    in its Makefile's test-gnucap guard -- is why an arm64 macOS host sees
    four arm64 Mach-O objects and two x86-64 ELF objects in one directory,
    and why every cap_cmomi-instantiatin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
2026-08-30 sim: fix check-osdi-arch.sh --help truncation and --self-test macOS printf bug (Closes #64) (#65)
    usage() sliced a hard-coded line range that stopped mid-USAGE-block once the
    header comment grew; switch to an awk sentinel scan from "# USAGE" through
    the line before `set -uo pipefail` so a future comment edit can't silently
    truncate it again.
    _mkhdr() piped hex escapes through `xargs -0 printf`, which execs the
    external printf(1). BSD/macOS printf doesn't understand \xHH, so on macOS
    this wrote literal escape text instead of binary header bytes and every
    classify_osdi self-test assertion returned "unknown unknown". Use bash's
    builtin `printf '%b'` instead, which is confirmed byte-identical t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
2026-08-30 sim: resolve $PDK_ROOT/$PDK in divider-nrange-retiming testbenches (#69)
    Ports the #43/PR #55, #54/PR #58 fix pattern to
    sim/sg13cmos5l-divider-nrange-retiming/testbench/: switch all five
    .lib sites (four .sp.tmpl decks plus the opconv stage's
    heredoc-generated deck) to resolved filesystem paths, and route
    ngspice invocations through a stderr-surfacing wrapper that dies loud
    on a genuine deck error while still tolerating the opconv stage's own
    documented timeout (RECORD-001 Finding 1).
    Re-verification found and fixed a second, independent bug in the
    opconv convergence classifier (a grep pattern that could never match
    ngspice's actual print format), and produced new reproducible evidence
    upg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
    [opconv.csv, retime.csv]
2026-08-30 Fix pfd self-reset inverter-parity defect; re-run closed-loop lock (Part of #16) (#71)
    * fix: correct PFD self-reset chain inverter parity (design/sg13cmos5l)
    design/sg13cmos5l/pfd.sch's self-reset chain hands reset back as
    NAND(UP,DN) instead of the AND(UP,DN) the SR latches need, because it
    applies an even number (2) of inversions after reset_raw = NAND(UP,DN).
    Add a third inv_hv stage (XI1B) so the total is odd, restoring
    reset = AND(UP,DN) -- confirmed root cause in
    sim/sg13cmos5l-closed-loop-lock/records/RECORD-002-pfd-reset-parity-root-cause.md.
    Netlist re-exported via design/sg13cmos5l/netlist.sh; all 6 blocks still
    match their schematics (--check).
    * layout: re-verify SG13CMOS5L p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
    [lock_trace_as_drawn.csv, lock_trace_proposal.csv, pfd.sch, results_as_drawn.csv, results_proposal.csv]
2026-08-30 design+sim: resize SG13CMOS5L lock_detector XRPU/XCW/XDW.XC1 and re-run the PVT campaign (Part of #16) (#68)
    Issue #38's RECORD-001 measured `lock_detector` failing all three of
    spec/porting-plan.md row 16's measurable criteria at every one of 92 corner
    points, and root-caused it to the integrating node's own R*C time constant
    (0.71-1.71 ns) sitting 23-1412x BELOW the reference period. Issue #52 is
    that re-sizing, plus the re-measurement that verifies it.
    Resized (design/sg13cmos5l/lock_detector.sch, delaywin_hv.sch, and the
    regenerated netlist export -- `netlist.sh --check` passes):
    XRPU rhigh l=6u -> l=700u (R 11.8-28.6 kOhm -> 1.35-3.30 MOhm)
    XCW cap_cmomi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
    [delaywin_hv.sch, hysteresis_diag.csv, hysteresis_diag_schmitt.csv, ladder_raw_resized.csv, ladder_resized.csv, lock_detector.sch, rc_extract_resized.csv, schmitt_resized.csv]
2026-08-30 sim: confirm cp Icp_up/Icp_dn mismatch as the closed-loop static phase-error mechanism (Closes #70) (#73)
    RECORD-003 measured a stable ~9.18%-of-T_ref static phase error in the
    sg13cmos5l-closed-loop-lock Part B (proposal) deck after the pfd
    self-reset fix, and named cp's already-measured up/dn current-magnitude
    mismatch (~3% at the 10 uA trim code) as a leading, unconfirmed
    hypothesis.
    Adds a diagnostic-only re-run (run_closed_loop_icp_eq_diag.sh) that
    substitutes cp with an ideal, exactly-symmetric behavioural charge pump
    (NOT a change to design/sg13cmos5l/cp.sch or any committed netlist) and
    re-runs Part B's own deck otherwise unchanged. The hypothesis is
    confirmed: the static phase erro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
    [lock_trace_proposal_icpeq.csv]
2026-08-30 fix: resolve unexpanded $PDK_ROOT/$PDK in PR #42's three sim testbenches (#74)
    ngspice's .lib/.include netlist parser does not expand shell/OS
    environment variables, so tb_cp_dc.sp.tmpl, tb_loop_ac_real.sp.tmpl, and
    tb_vco_duty.sp.tmpl each failed with a fatal "library file not found"
    error on a real PDK_ROOT/PDK install -- silently absorbed by each
    run.sh's 2>/dev/null into a false NA/success result. Same defect and fix
    shape as issue #43/PR #55, applied here to the three testbenches PR #42
    added (out of #43's scope since they postdate that issue's own grep).
    - Switch each .lib/.include line from a literal $PDK_ROOT/$PDK to
    @PDK_ROOT@/@PDK@ tokens, substituted by each run.sh's existing s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
2026-08-30 design+sim: fix lock_detector hysteresis — schmitt_hv feedback rewiring (both PDKs) + XMPD re-size (Closes #66) (#75)
    * design+sim: fix schmitt_hv feedback wiring (both PDKs), re-size lock_detector XMPD, extend the campaign
    Part of #16. Implements issue #66's two design changes and the testbench work
    needed to measure them; the RECORD-003 evidence lands in a follow-up commit
    once the campaign finishes.
    Design (SG13CMOS5L):
    - schmitt_hv.sch: XMP3/XMN3 re-tied to the classic six-transistor connection
    (XMP3 source np / drain VSS, XMN3 source nn / drain VDD).
    - lock_detector.sch: XMPD w=2u l=0.5u -> w=0.25u l=16u. XRPU/XCW/XDW.XC1 are
    untouched, so #52's R*C margin is spent by nothing h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
    [ladder_hystfix.csv, ladder_raw_hystfix.csv, lock_detector.sch, rc_extract_hystfix.csv, schmitt_hv.sch, schmitt_hystfix.csv, schmitt_rewire.csv, tstep_convergence_hystfix.csv]
2026-08-30 design: add cp's on-chip cascode bias replica to tighten up/dn matching (#85)
    * design: add an on-chip high-swing cascode bias replica to cp.sch
    The SG13CMOS5L port left cp's IBP/ICP/IBN/ICN as voltage-input pins with no
    on-chip diode, so every testbench tied IBP=ICP and IBN=ICN. Two devices whose
    gates share one node cannot both saturate, so each leg degenerated into a
    simple mirror of effective length L1+L2 and its delivered current tracked VOUT
    through plain channel-length modulation. The NMOS leg's output conductance is
    ~8x the PMOS leg's, so the two copy errors did not cancel (+0.46% up vs +3.69%
    dn at VOUT=VDD/2, mos_tt/27C) -- the ~3% up/dn magnitude mismatch behind the
    row-7 static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
    [compliance.csv, cp.sch, lock_trace_proposal_cascbias.csv, mom_band.csv, proposal.csv, results.csv]
2026-08-30 design+sim: resize SG13CMOS5L loop_filter R1 and re-verify against amended f_ref range (#80)
    * design+sim: resize SG13CMOS5L loop_filter R1 and re-verify against amended f_ref range (Closes #41)
    RECORD-001 (issue #27) measured 0/90 real-subckt PVT combinations meeting
    the >=45deg phase-margin criterion with R1 as drawn (rppd w=4u l=120u,
    ~7.79 kOhm) -- the filter zero sat one to two decades above any reachable
    crossover. RECORD-001's own proposal.csv identified an "R1 x20" fix,
    validated only at a single fixed f_ref=25MHz point.
    DR-005 (issue #40) has since amended spec/porting-plan.md's f_ref range to
    3.5-24.4 MHz (N in [64,127]), tightening the f_c<f_ref/10 ceiling and,
    critically, requi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
    [loop_filter.sch, results_resized.csv]
2026-08-30 sim+spec: close band=00/mid/f_ref=4.5MHz PM gap with a fine Icp-trim code (#83) (#89)
    RECORD-002 (issue #41/DR-006) found no code in the existing six-code Icp
    trim ladder (2.5/5/10/20/40/80 uA) meets both f_c<f_ref/10 and PM>=45deg
    simultaneously at band=00, mid Kvco interval, f_ref=4.5MHz (slow bundle,
    n_div=119): 2.5uA misses PM by 1.36deg, 5uA blows the fc ceiling.
    cp.sch has no on-chip Icp trim array (design/README.md) -- the "trim code"
    is an external mirror reference current, so an intermediate value is a
    legitimate measurement, not a hardware change. Measured Icp at a new 3.75uA
    code (arithmetic midpoint of the two existing bracketing codes) for the
    slow bundle (the only bundle reach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
    [results_issue83_finetrim.csv, results_resized_issue83_finetrim.csv]
2026-08-31 sim: stand up sg13g2-lock-detector-window and extract R/C over PVT grid (Part of #16 via #78) (#81) (#88)
    Stands up sim/sg13g2-lock-detector-window/ -- the first-ever sim/ campaign
    against the native SG13G2 lock_detector hierarchy, which has carried
    pre-#52/#66 sizing with no measurement behind it on this PDK. Reuses the
    SG13CMOS5L sibling's topology-generic testbench pieces (tb_window,
    tb_lock_ladder_point, tb_lock_recovery, tb_schmitt_hyst, gen_ladder.py,
    run.sh's overall shape) and its itl4=5000/gmin=1e-11 solver settings
    verbatim.
    Confirms cap_cmim (SG13G2's own device, unlike SG13CMOS5L's cap_cmomi) has a
    real characterised process corner (cornerCAP.lib cap_typ/cap_bcs/cap_wcs)
    and a g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
    [ladder.csv, ladder_raw.csv, rc_extract.csv, schmitt.csv, tstep_convergence.csv, window.csv]
2026-08-31 sim: measure schmitt_hv crowbar as an accepted residual, re-verify row 16 (#90)
    * design+sim: lengthen schmitt_hv's six channels 0.5u->2u to cut the in-band crowbar current
    The mechanism, measured rather than argued: a 6T CMOS Schmitt's hysteresis
    comes from feedback devices that pull each stack's internal node toward the
    opposite rail, so while the input rests between the trip points a feedback
    device conducts against an input device in the same stack (VDD-XMN3-nn-XMN2-VSS,
    or its PMOS mirror). That current scales with the devices' absolute strength;
    the trip points scale with their ratio. Scaling all six channel lengths by the
    same factor therefore attacks one without spending the other.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
    [band_zone_static_crowbarfix.csv, band_zone_static_hystfix.csv, ladder_crowbarfix.csv, ladder_raw_crowbarfix.csv, rc_extract_crowbarfix.csv, schmitt_crowbar_variants.csv, schmitt_crowbarfix.csv, schmitt_hv.sch]
2026-08-31 sim+spec: close band=00/low/f_ref=4.5MHz PM gap with a fine 11uA Icp-trim code (#79) (#91)
    simultaneously at band=00, low Kvco interval, f_ref=4.5MHz, reachable at
    all three PVT bundles (n_div=127/114/103 for fast/typ/slow): at 10uA,
    typ/slow pass but fast is 0.87deg short (44.127deg); at 20uA, PM clears
    everywhere but fc blows the ceiling for all three bundles.
    Unlike issue #83's gap (a single binding bundle, wide feasible window), a
    real-subckt scan found this gap's feasible Icp window bounded by TWO
    DIFFERENT bundles at each edge: fast's PM=45d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
    [results_issue79_finetrim.csv, results_resized_issue79_finetrim.csv]
2026-08-31 sim+design: re-derive SG13G2 lock_detector XRPU/XCW/XDW.XC1/XMPD and record RECORD-001 (#96)
    Phase 2/2 of the SG13G2 lock_detector campaign issue #81 stood up. #81
    extracted R/C over the PVT grid against the pre-resize block and drew no
    verdict; this change re-derives all four sizing values from that data on
    THIS PDK and measures spec/porting-plan.md row 16 against the result.
    Landed sizing, each read off a committed CSV under
    sim/sg13g2-lock-detector-window/corners/ (none equals the SG13CMOS5L
    sibling's -- cap_cmim is ~1.5 fF/um^2 against cap_cmomi's ~1.06, so the
    window delay comes from 2025 um^2 of MIM instead of 2 x 1600 um^2 of MoM,
    and the integrating node can sit at a lower 0.97-2.36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
    [delaywin_hv.sch, hysteresis_diag.csv, ladder_raw_resized.csv, ladder_resized.csv, lock_detector.sch, rc_extract_resized.csv, rc_pairing.csv, rc_sizing.csv]
2026-09-05 feat(champion): standing authorization for design-evidence auto-merge (#6850)
    Operator ruling 2026-09-05: Judge-approved, green-CI PRs whose entire
    changed-file set lives in design/, sim/, layout/, measurements/,
    verification/, or docs/ auto-merge without the four-axis human hold.
    Rationale: canary design evidence is fully revertible with no fleet-infra
    blast radius, and the held-PR pattern (sky130-sar-adc#123 sat mergeable for
    days as the sole blocker of a layout chain) costs more than it protects
    here. spec/ and every tool surface fall outside the patterns, so the
    exact-subset rule keeps them on the four-axis judgment automatically.
    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
2026-09-09 sim: stand up sg13g2-vco-kvco-table (SG13G2 twin of sg13cmos5l-vco-kvco-table) (#98)
    Adds the SG13G2-native open-loop VCO output-band / Kvco-vs-band-code
    campaign (spec/porting-plan.md rows 1/4/5), mirroring the SG13CMOS5L
    sibling's testbench/corners/records shape: 3 PVT bundles (typ/slow/fast,
    each bundling a mos/res/cap corner with a temperature) x 4 band codes x 5
    VCTRL points = 60 transient runs at a fixed 3.3V supply (DR-002), all
    valid (zero NA).
    Unlike the SG13CMOS5L sibling, XCDECAP (a cap_cmim MIM decap) is kept
    rather than stripped -- cap_cmim has no OSDI object at all, so there is no
    arm64 cross-architecture risk to route around, and cornerCAP.lib is swept
    as a bundled third corn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
    [results.csv]
2026-09-19 [Part of #16] Post-layout PEX + PVT re-simulation for the SG13CMOS5L PLL port (#99)
    * sim(sg13cmos5l): extract parasitic-annotated netlists for all 6 routed blocks
    Real R/C from klt's curated sg13cmos5l parasitics deck (klayout-tools#2012
    registers the deck, #2126 curates the metal coefficients). Every block
    reports an empty metals_without_coefficient list -- no metal level fell back
    to a zero coefficient.
    Part of #30
    * sim(sg13cmos5l): post-layout VCO PVT testbench (PEX arm + schematic control arm)
    Part of #30
    * sim(sg13cmos5l): resumable PVT run + LVS re-check harness for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
    [control.csv, cp_results.csv, deviation.csv, rc_attribution.csv, results.csv]
2026-09-21 feat: add divider-chain klt erc supply spec and T1 item-11 evidence (#105)
    Commit the first klt erc power-delivery (structural) supply read for an
    IHP SG13-family PDK in the fleet, for the SG13CMOS5L divider chain:
    - layout/sg13cmos5l-pll/erc-supply-spec.json -- the item-11 artifact:
    GatPoly/Activ gate entries, the three metal roles this block actually
    routes supplies on with label layers only where this stream puts PG
    text, Cont/Via1/Via2 vias, both supplies declared kind=supply, and
    ties[] deliberately omitted per the recorded klayout-tools#2169
    workaround with the standing-in well-tie evidence named inline.
    - layout/sg13cmos5l-pll/erc-welltie-check-spec.json -- supplementary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
2026-09-21 layout: locality floorplan pass for pll_vco with PVT re-run (#106)
    * layout: add net-affinity floorplan pass for pll_vco composition
    Permute the group order, the member->unit order inside each matched
    group cell, and the Metal3 track order (a new track_order argument to
    cmos5l_route.route) for the vco block before the channel router draws
    it, minimising the router's own span+riser wire cost. Group cells'
    drawn geometry, every net, every device and every spacing are
    unchanged, so DRC, extraction and LVS comparisons see the same block
    on less wire. Other blocks keep the single-row, by-name-track
    composition byte-for-byte via FLOORPLAN_STRATEGIES opt-in.
    On the current netlists this cuts pll_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
    [deviation.csv, rc_attribution.csv, results.csv]
2026-09-21 sim: add post-layout PVT arms for pfd and lock_detector (RECORD-003) (#107)
    Extend the sg13cmos5l-postlayout-pex-pvt harness (issue #30's follow-on,
    issue #102) from vco/cp to the two blocks RECORD-001 deferred for runtime
    budget:
    - run_pfd.sh + tb_pfd_pex.sp.tmpl (Matrix D): re-run the ratified
    standalone PFD polarity diagnostic at its own single typ point on both
    arms, plus a bounded lead/lag offset axis. Post-layout reflead holds
    stay textbook but uniformly +0.525 ns wider; the fblead steady state
    inverts (UP holds T_ref - tau, DN never holds) at every offset measured
    -- traced to clipped latch race margins on extracted-ar~0.5 ns edges,
    on the LVS-matched block.
    - run_lock_d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
    [ld_deviation.csv, ld_ladder.csv, ld_ladder_raw.csv, ld_rc_control.csv, ld_rc_extract.csv, ld_tstep_convergence.csv, ld_window.csv, ld_window_control.csv]
2026-09-21 sim: re-measure lock_detector PVT arms against c44fa68 extraction (#110)
    Re-runs the RECORD-003 Matrix E campaign (run_lock_detector.sh, fresh
    scratch) against the committed 20260921-155747-c44fa68 re-extraction
    #106 landed: all nine ld_* artifacts regenerate, the control gates stay
    102/102 window rows + 15/15 device rows byte-identical, and pfd evidence
    is untouched (its snapshot is byte-identical at c44fa68).
    The c44fa68 device set retired the revision lag the record's first
    revision measured: the routed cell now carries the #66 XMPD resize and
    the #66/#76 schmitt rewire (verified device-for-device), so the as-layout
    twin is re-derived from the crowbarfix snapshot minus exactly its two
    ca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
    [ld_deviation.csv, ld_ladder.csv, ld_ladder_raw.csv, ld_tstep_convergence.csv, ld_window.csv]
2026-09-22 docs: re-derive challenge-6-proposal.md against current sim/layout evidence (#118)
    * docs: re-derive challenge-6-proposal.md against current sim/layout evidence
    Full re-derivation pass over every §4 spec row, the Status line, and the
    §5 sign-off table, against the evidence that landed since 0ad06e8 (PR #34):
    - Status line: partial pass disclosed (#112/#113/#114/#115 open); framing
    stays 'not a finished sign-off', now on measured evidence.
    - Row 2: DR-005-amended f_ref 3.51-24.4 MHz; pfd self-reset parity defect
    (#50) found+fixed (#56); post-layout PEX pfd +0.53 ns arcs and FB-lead
    discrimination inversion (#102).
    - Row 3: committed divider_chain does not divide at any of 9 corners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
2026-09-22 layout: draw cap_cmomi MoM caps locally on SG13CMOS5L, close loop_filter LVS (#119)
    Add a local interdigitated Metal1-Metal4 MoM-capacitor footprint
    (cmos5l_devices.draw_mom_cap) under a Recog.mom (99/39) marker sized to
    each schematic instance's own w/l, promote the five cap_cmomi plan groups
    to locally drawn ones, and LVS them through a caller-side reference rewrite
    (mom_cap_reference) that emits the X ... PARAMS: W= L= card shape klt
    lvs's custom-device-class reader recognises, expands m= one card per
    drawn marker, and recomputes converted resistor cards' values from the
    deck's own sheet-rho coefficients. Bump the klt pin to daf06a51a
    (klayout-tools#1466/#1475 extraction + #1942/#1944 LVS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
2026-09-22 fix: repair dff_tg_hv hold-path feedback and clock staggering; re-verify divider_chain N range and retiming margin (#121)
    The committed SG13CMOS5L divider did not function at any tested corner
    (RECORD-001 Finding 2): each dff_tg_hv latch's hold-path feedback carried
    a single inversion (a self-biased inverter, not a latch), and all four
    transmission gates were clocked from the single-delay CLBB with no
    master-slave race margin.
    Two structural repairs, matching the proven gf180-pll dff_tg_3v3 fleet
    topology: XIMF/XISF insert the missing second feedback inverter per latch
    (full-strength inv_hv), and XICKBB adds the staggered CKBB clock phase
    with all four TGs retargeted onto it. Netlist regene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
    [dff_tg_hv.sch, func.csv, hold.csv, opconv.csv, retime.csv, setup.csv, tol_convergence.csv]
2026-09-23 fix: declare vco's XBIAS resistor bodies on VSS, close the vco LVS mismatch (#123)
    * design: declare vco's XBIAS resistor bodies on VSS, close vco LVS mismatch
    The six XBIAS resistors were never missing from the layout: vco_bias.sch
    declared their bulk terminals on a private floating sub! global while the
    drawn layout puts every resistor bulk on the one substrate node the NMOS
    body ties also land on, so the reference carried two substrate nodes where
    the layout has one. Re-declare the six bodies on VSS in vco_bias.sch and
    the regenerated vco.spice; rebuild the layout record at a95a887 (also
    absorbing #121's divider_chain fix) and re-run the lvs-recheck flow.
    pll_vco.gds is byte-identical t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
    [vco_bias.sch]
2026-09-23 fix: splice --pdk-root after find subcommand in PDK record renderers (#125)
    Both record renderers built `klt pdk find` and then inserted
    `--pdk-root <root>` at argv index 2 -- before the `find`
    subcommand -- producing `klt pdk --pdk-root <root> find ...`,
    which argparse rejects. The failure was silently swallowed into
    an empty `pdk_info`, so rendered records claimed
    'not resolved (plan-only run)' for full runs. Insert at index 3
    (after `find`) in both renderers.
    Closes #124
2026-09-23 fix: add dual-inversion dff feedback and staggered CKBB clocking (#128)
    Port #112's dff_tg_hv repair verbatim from the SG13CMOS5L port to the
    SG13G2 (non-port) tree: XIMF/XISF second feedback inverters per latch
    (the as-drawn single-inversion hold loop was a self-biased inverter, not
    a bistable latch) and the XICKBB second clock phase with all four
    transmission gates staggered on it (gf180-pll dff_tg_3v3 fleet
    topology). Circuit lines are byte-identical to the merged
    design/sg13cmos5l/dff_tg_hv.sch.
    - design/netlist/divider_chain.spice regenerated (netlist.sh --check
    passes for all 6 blocks)
    - new sim/sg13g2-divider-repair-reverification campaign (issue #120):
    fresh SG13G2-PDK runs conf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
    [dff_tg_hv.sch, func.csv, hold.csv, opconv.csv]
2026-09-23 sim: add post-layout PVT arms for loop_filter and divider_chain (RECORD-004) (#129)
    Completes the six-block post-layout set of sg13cmos5l-postlayout-pex-pvt
    (issue #115, Part of #16): both blocks RECORD-001 declared "unanswerable"
    now have arms, against the schematic-level results #112 (divider repair,
    via #121) and #114 (drawn cap_cmomi pair, via #119) landed.
    - Matrix F (loop_filter): the momcap campaign's 27-row corner x MOM band,
    re-measured as composite driving-point AC on both arms; post-layout
    deviation is capacitance-dominated: Ctot +39.6%, fz -19.1%, fp -41.4%,
    physical R1 change bounded <= +2.0%.
    - Matrix G (divider_chain): the nrange-retiming campaign's functional
    matrix,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
    [div_control.csv, div_results.csv, lf_control.csv, lf_results.csv]
2026-09-24 refactor: route group_size_um's capacitor branch through mom_cap_size (#131)
2026-09-24 test: realign the SG13CMOS5L layout tests with #119's local MoM-cap promotion (#133)
    PR #119 moved cap_cmomi recognition from a caller-side reference/probe device
    map to locally promoting and drawing the groups, but layout/tests/
    test_pll_cmos5l_layout.py was not updated with it, leaving 3 failing and 5
    erroring tests.
    * The blocked-reason assertion now checks the upstream numbers the rewritten
    BLOCKED_REASONS["cap_cmomi"] actually cites (klayout-tools#1466/#1475, the
    closed recognition half) plus the live drawing-side gap and the promotion
    clause, and still asserts the SG13G2 MIM chain (#1454/#1455) never leaks in.
    * The two tests reading the retired REFERENCE_DEVICE_MAP /
    CAPACITO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
2026-09-24 test: fix cap_cmomi blocked_reason assertion after #119 rewording (#135)
    test_plan_block_records_but_never_attempts_cap_cmomi asserted the literal
    substring "never drawn" against BLOCKED_REASONS["cap_cmomi"], but PR #119
    rewrote that reason string and no longer includes it. Update the
    assertion to check for "promotion did not run", which the current text
    still carries and preserves the test's intent: the planner records the
    cap_cmomi group as unattempted with a reason, never silently dropping it.
    Closes #132
2026-10-01 chore: resync installed Loom surfaces
    resynced_by: fleet-resync
    invocation: fleet-resync.sh --fleet-only --push
    <!-- loom:provenance v1 build=unknown 19f4e67fd0a0afbd3d8b6606ca91ceac911377a3 clean prompts=none sweep=none story=none trace=78a5dfbdfd8c530aecd1bb436fd096df host=loom-worker-2 base=e5808e30f575949d57483f1491ad91cc534d1d09 run=loom-run/v1:timer:loom-worker-2/fleet-resync:67c759f7ef3c43e38d3fa8d5f19a2dd1 installs=0.19.593 658650a4f0eff932ac66a8f690eaedf8123fc83b -->
    Loom-Story: none
    Loom-Trace-Id: 78a5dfbdfd8c530aecd1bb436fd096df
    Loom-Build: unknown 19f4e67fd0a0afbd3d8b6606ca91ceac911377a3 clean
2026-10-01 chore: resync installed Loom surfaces
    <!-- loom:provenance v1 build=unknown 56435bf476452911283e43940ecfd9a30f804af9 clean prompts=none sweep=none story=none trace=342405c5ebc99bdbf17afbd983c0c41c host=loom-worker-2 base=042cb2ad69dae6bb55a820913b3068ec86e9fa70 run=loom-run/v1:timer:loom-worker-2/fleet-resync:20c09f231d424cd5b57ca7991848dd8a installs=0.19.603 8c39bf7cde8a8c03d1aaee441f397c017b6a3a9e -->
    Loom-Trace-Id: 342405c5ebc99bdbf17afbd983c0c41c
    Loom-Build: unknown 56435bf476452911283e43940ecfd9a30f804af9 clean
    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
2026-10-01 chore: resync installed Loom surfaces
    <!-- loom:provenance v1 build=unknown f2868e6b4d60d11a8ab47d25cad9e248229d2f66 clean prompts=none sweep=none story=none trace=4e2766ed5160781df891476246a9be2e host=robb-studio base=4897fc2d8b3d4dc8f036ae89312a37a1f7d8b97f run=loom-run/v1:timer:robb-studio/fleet-resync:2d3851d5-1673-43ae-bcc6-e5c971b37f33 installs=0.19.603 74778a6aeea5d9e06b489400942b35f33c8bb766 -->
    Loom-Trace-Id: 4e2766ed5160781df891476246a9be2e
    Loom-Build: unknown f2868e6b4d60d11a8ab47d25cad9e248229d2f66 clean
    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
2026-10-01 chore: resync installed Loom surfaces
    <!-- loom:provenance v1 build=unknown d6714830391f7596338b8de40ee2d0f45dcd12f5 clean prompts=none sweep=none story=none trace=af273f717e759e690d07f372734e9278 host=robb-pro base=0e9ba1321a2682caa81415a0d6096da802b18d08 run=loom-run/v1:timer:robb-pro/fleet-resync:92e2f9ba-d083-411b-833b-ae52d169ef04 installs=0.19.605 6eb2b65a4496b7becb84ef1f944493a541fd01cd -->
    Loom-Trace-Id: af273f717e759e690d07f372734e9278
    Loom-Build: unknown d6714830391f7596338b8de40ee2d0f45dcd12f5 clean
    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
2026-10-01 chore: resync installed Loom surfaces
    <!-- loom:provenance v1 build=unknown e956e9fee69e53f08b887ca20e14d9058d6f9aee clean prompts=none sweep=none story=none trace=1077dafeb758858c149dd37f4ece3c77 host=loom-worker-2 base=48df4f8c5135cee8bdb1ba5874c0728718cfb34b run=loom-run/v1:timer:loom-worker-2/fleet-resync:e3773167b12d4b3aafa1f76848245174 installs=0.19.609 ff30576dacc8c2734b1c7434bedd29c47122caeb -->
    Loom-Trace-Id: 1077dafeb758858c149dd37f4ece3c77
    Loom-Build: unknown e956e9fee69e53f08b887ca20e14d9058d6f9aee clean
    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
2026-10-01 chore: resync installed Loom surfaces
    <!-- loom:provenance v1 build=unknown 617257919edc1b9b9ee27532c5ec1b8a64523388 clean prompts=none sweep=none story=none trace=dbafe4f8526617aa07c890721298a080 host=robb-studio base=a7ad7d20de1e415a75c3d2e59f0204b0a7df93cd run=loom-run/v1:timer:robb-studio/fleet-resync:1817df66-02cc-4b27-927d-a38485da550a installs=0.19.610 c94891dd526cf6db5ee02045424c6913be522048 -->
    Loom-Trace-Id: dbafe4f8526617aa07c890721298a080
    Loom-Build: unknown 617257919edc1b9b9ee27532c5ec1b8a64523388 clean
    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
2026-10-01 chore: resync installed Loom surfaces
    <!-- loom:provenance v1 build=unknown a2a39ac2736eb2686e2c65412d939e67c0438a7d clean prompts=none sweep=none story=none trace=fc1a121767151aae5bd7427c683b7db6 host=robb-pro base=b60e136bfba7956534b20b481b0493f9d9aa63c4 run=loom-run/v1:timer:robb-pro/fleet-resync:708eb7c8-469d-4783-80b7-bafe142df3c4 installs=0.19.612 d25614656adcf70162da95c5e1035e99a0639a1a -->
    Loom-Trace-Id: fc1a121767151aae5bd7427c683b7db6
    Loom-Build: unknown a2a39ac2736eb2686e2c65412d939e67c0438a7d clean
    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
2026-10-01 chore: resync installed Loom surfaces
    <!-- loom:provenance v1 build=unknown 126c80914e42f913c4fc778d3ddce96daa2c7a77 clean prompts=none sweep=none story=none trace=15a20fbea7a00d0922b943088c80e19d host=loom-worker-1 base=85bcbfc2cc8e8e565de75d32b51394f65ccb3c62 run=loom-run/v1:script:loom-worker-1/fleet-resync:ecc423da-4625-49de-b25a-692fd669a029 installs=0.19.612 53aeb18c5541af6b068247d82f62daed412cc2c6 -->
    Loom-Trace-Id: 15a20fbea7a00d0922b943088c80e19d
    Loom-Build: unknown 126c80914e42f913c4fc778d3ddce96daa2c7a77 clean
    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
2026-10-01 chore: resync installed Loom surfaces
    <!-- loom:provenance v1 build=unknown 126c80914e42f913c4fc778d3ddce96daa2c7a77 clean prompts=none sweep=none story=none trace=a0a42bd10fcfa6d7cbcc9c021c406848 host=loom-worker-2 base=e0aaf23ad862c08f8130b8877e0222aa16fbd7a2 run=loom-run/v1:timer:loom-worker-2/fleet-resync:9e174e6bb0fa41d786e4a86e45632b6f installs=0.19.612 6f0871dc66e62b36d8382ced980d2805bfd97e50 -->
    Loom-Trace-Id: a0a42bd10fcfa6d7cbcc9c021c406848
    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
2026-10-01 chore: resync installed Loom surfaces
    <!-- loom:provenance v1 build=unknown 8891f74a5d568fe3d13937ef37fd64371dd2738f clean prompts=none sweep=none story=none trace=1e216ea76cbd2b72542049c4c18c2817 host=loom-worker-1 base=6044d814e49194cc4f4946a826676e3115c7e815 run=loom-run/v1:timer:loom-worker-1/fleet-resync:679feba6c0f347d39eb5943ed77dc87b installs=0.19.612 62fa67f8756bdf59fdf744be053e5ef1709f1335 -->
    Loom-Trace-Id: 1e216ea76cbd2b72542049c4c18c2817
    Loom-Build: unknown 8891f74a5d568fe3d13937ef37fd64371dd2738f clean
    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
2026-10-01 chore: resync installed Loom surfaces
    <!-- loom:provenance v1 build=unknown 6f3411c8a63e68097dde01bce8a8422230f54218 clean prompts=none sweep=none story=none trace=9aa0a46bb352b9665fdaa5f5b3b85dd7 host=robb-pro base=674b6b8e3ad5a2fa3901a2f3ea8a23bd263d5a73 run=loom-run/v1:timer:robb-pro/fleet-resync:ca419e1d-6646-4678-ac7a-b263e4b5119e installs=0.19.612 7731400b3e3e1df39074564166edf656feb0999c -->
    Loom-Trace-Id: 9aa0a46bb352b9665fdaa5f5b3b85dd7
    Loom-Build: unknown 6f3411c8a63e68097dde01bce8a8422230f54218 clean
    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
2026-10-02 chore: resync installed Loom surfaces
    <!-- loom:provenance v1 build=unknown 13c0a3ef467a888520a6529ab34486ab8be826be clean prompts=none sweep=none story=none trace=41356080f367e491d5ff03f17bb98c27 host=loom-worker-2 base=ccafa30e966c592c4fa0e3cdfff07a2c3160cfc3 run=loom-run/v1:timer:loom-worker-2/fleet-resync:44455fbcbab745abb92cea192fafbb1d installs=0.19.614 3c79f7b1d0cc14723e049cff4250ff7330804326 -->
    Loom-Trace-Id: 41356080f367e491d5ff03f17bb98c27
    Loom-Build: unknown 13c0a3ef467a888520a6529ab34486ab8be826be clean
    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
2026-10-02 chore: resync installed Loom surfaces
    <!-- loom:provenance v1 build=unknown ea2dd21f2ba310ec007d047ddfecc6cd27d220ac clean prompts=none sweep=none story=none trace=f04a67f3922788d2ccdd66578c8d18f9 host=loom-worker-1 base=57b8d6de2f13ff0c558b81b95f2f10f2d175fe3c run=loom-run/v1:timer:loom-worker-1/fleet-resync:1c3b601dd998488595adc09040c007d4 installs=0.19.614 79f4897c5d3c78dbfc1b022f77d244838dbf4ccb -->
    Loom-Trace-Id: f04a67f3922788d2ccdd66578c8d18f9
    Loom-Build: unknown ea2dd21f2ba310ec007d047ddfecc6cd27d220ac clean
    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
2026-10-02 chore: resync installed Loom surfaces
    <!-- loom:provenance v1 build=unknown 6f3411c8a63e68097dde01bce8a8422230f54218 clean prompts=none sweep=none story=none trace=acb28d0049e0cc75536f96d503f6e814 host=robb-studio base=08fa042a0f0d90b7c1b665f9bba8febe85b27de9 run=loom-run/v1:timer:robb-studio/fleet-resync:85d2b1b5-e81d-40c3-ab6a-9a00efbc4ee2 installs=0.19.616 d86523eeadb32b95777f3cd3a76dd2f72f0bf792 -->
    Loom-Trace-Id: acb28d0049e0cc75536f96d503f6e814
    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
2026-10-02 chore: resync installed Loom surfaces
    <!-- loom:provenance v1 build=unknown 2b50bd69eddd038dd738465aa58a9ebca11410ac clean prompts=none sweep=none story=none trace=324e4f607054d0396cfdf8fdc01e93ae host=robb-pro base=5b359078cf86d5f0f2e21c797f9615dfaa8a041a run=loom-run/v1:timer:robb-pro/fleet-resync:a63799f1-2ad7-4946-b81d-2ec231bc2d2f installs=0.19.617 81cb2ad7e091b19d6a2b95d1add6938c2100d46b -->
    Loom-Trace-Id: 324e4f607054d0396cfdf8fdc01e93ae
    Loom-Build: unknown 2b50bd69eddd038dd738465aa58a9ebca11410ac clean
    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
2026-10-02 chore: resync installed Loom surfaces
    <!-- loom:provenance v1 build=unknown 00d92b326aed50280cd90dc116b7caec27668251 clean prompts=none sweep=none story=none trace=9a5d23cc82b6d3a1c83bfee47bd04970 host=loom-worker-2 base=94a903fac5a4537711ce903935d9608342fa3291 run=loom-run/v1:timer:loom-worker-2/fleet-resync:12136a7a025d49f3a60b5edb04a3ff81 installs=0.19.619 4c0f505e4f0b76f8ccec07bda6d8b839030c077b -->
    Loom-Trace-Id: 9a5d23cc82b6d3a1c83bfee47bd04970
    Loom-Build: unknown 00d92b326aed50280cd90dc116b7caec27668251 clean
    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
2026-10-02 chore: resync installed Loom surfaces
    <!-- loom:provenance v1 build=unknown 456dad6d90259846313dc3bb80bf4e5471ef2d76 clean prompts=none sweep=none story=none trace=bb9688c03fb5211d06f48c8838a5505c host=robb-studio base=c66903abfabbf986fa6716fece99c32258561086 run=loom-run/v1:timer:robb-studio/fleet-resync:e965c017-8ec7-485d-b46e-aeb399b81fb4 installs=0.19.620 0d28ba49f5a88fdb37271de9cb0144eb3442c6e3 -->
    Loom-Trace-Id: bb9688c03fb5211d06f48c8838a5505c
    Loom-Build: unknown 456dad6d90259846313dc3bb80bf4e5471ef2d76 clean
    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
2026-10-02 chore: resync installed Loom surfaces
    <!-- loom:provenance v1 build=unknown 6c6d2b6565dc13eff4c6811b9c670f452106516b clean prompts=none sweep=none story=none trace=539be979ae694d66ede516a7b5d17e41 host=robb-pro base=70c1961e7386d2680f6213db67b8343a8656b7cf run=loom-run/v1:timer:robb-pro/fleet-resync:9444d216-de08-442f-8352-ba59f6e81bb3 installs=0.19.621 a90dc1d794eb9ff70aaf939ebf495abe716f3bdd -->
    Loom-Trace-Id: 539be979ae694d66ede516a7b5d17e41
    Loom-Build: unknown 6c6d2b6565dc13eff4c6811b9c670f452106516b clean
    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
2026-10-02 chore: resync installed Loom surfaces
    <!-- loom:provenance v1 build=unknown f6d28134bfe476967e005d97424073085f55e8a3 clean prompts=none sweep=none story=none trace=27eb90670d441065f593e941066ee005 host=loom-worker-2 base=79f177b2ee183ace3414ff04de0ae1a8dcb1d815 run=loom-run/v1:timer:loom-worker-2/fleet-resync:04001bba930241cf9e325bf304a9270a installs=0.19.623 ccc19c2bbe2aa65328427730fa53f70eb56128c6 -->
    Loom-Trace-Id: 27eb90670d441065f593e941066ee005
    Loom-Build: unknown f6d28134bfe476967e005d97424073085f55e8a3 clean
    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
2026-10-02 chore: resync installed Loom surfaces
    <!-- loom:provenance v1 build=unknown bc461736314499b6c2c4c0ad51fb2294f60336f5 clean prompts=none sweep=none story=none trace=c3ea68717dd3a908dbbd60a35bc8b5d6 host=robb-studio base=4a20396df58444bb26669ab17800af9dad537881 run=loom-run/v1:timer:robb-studio/fleet-resync:8d4c49e2-3258-4080-b0c8-082499053654 installs=0.19.623 a50aaf70069f8897c41a64b7d90783c5ab8294e0 -->
    Loom-Trace-Id: c3ea68717dd3a908dbbd60a35bc8b5d6
    Loom-Build: unknown bc461736314499b6c2c4c0ad51fb2294f60336f5 clean
    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
2026-10-02 chore: resync installed Loom surfaces
    <!-- loom:provenance v1 build=unknown bc461736314499b6c2c4c0ad51fb2294f60336f5 clean prompts=none sweep=none story=none trace=8bee8a664bfc89e0bbfbb3c2de7342ba host=loom-worker-2 base=a3ad88b6001ed4b2f98173afa6052f3eb2a778c0 run=loom-run/v1:timer:loom-worker-2/fleet-resync:de2ceceb48ea4927a1334d08dc0082fe installs=0.19.624 5f49564fa78ae06f8c48d5224dae9ded04200bb7 -->
    Loom-Trace-Id: 8bee8a664bfc89e0bbfbb3c2de7342ba
    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
2026-10-03 chore: resync installed Loom surfaces
    <!-- loom:provenance v1 build=unknown 752d316233ed1a3da9e4f69ad760eb99bb477747 clean prompts=none sweep=none story=none trace=7851839b67c00a023e97cbdea1f580e1 host=robb-pro base=63068e097d1656445d016c781b04a4275b66ecb0 run=loom-run/v1:timer:robb-pro/fleet-resync:ae492b66-dca0-4da4-acab-8d26778f2d5c installs=0.19.624 121fac45f5006879bf58a18c951b9243d9099a18 -->
    Loom-Trace-Id: 7851839b67c00a023e97cbdea1f580e1
    Loom-Build: unknown 752d316233ed1a3da9e4f69ad760eb99bb477747 clean
    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
2026-10-03 chore: resync installed Loom surfaces
    <!-- loom:provenance v1 build=unknown b34a08286a42f47f917ec46647d4d167c1f5207c clean prompts=none sweep=none story=none trace=a8e453124b899b440f42c9d83837c7b6 host=loom-worker-2 base=b4571767ab1c2179e2038d2c40319be12722c9e2 run=loom-run/v1:timer:loom-worker-2/fleet-resync:f02dd5df715347fe90fe14b9353a1b66 installs=0.19.624 0162badc662fb30c070e70611aa8ff74a8486d54 -->
    Loom-Trace-Id: a8e453124b899b440f42c9d83837c7b6
    Loom-Build: unknown b34a08286a42f47f917ec46647d4d167c1f5207c clean
    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
2026-10-03 chore: resync installed Loom surfaces
    <!-- loom:provenance v1 build=unknown 3437cece5ab759f772122f8d18a6d2f05d246cde clean prompts=none sweep=none story=none trace=bba21427f750636f851279cfae92b4e5 host=loom-worker-1 base=c3164af66c6d16687dccd679ed7e8fa4367cc457 run=loom-run/v1:timer:loom-worker-1/fleet-resync:9440cda9476f404caa282e360a81ee03 installs=0.19.636 e41edfbb52c13982f7d8b0577f42957427a6514c -->
    Loom-Trace-Id: bba21427f750636f851279cfae92b4e5
    Loom-Build: unknown 3437cece5ab759f772122f8d18a6d2f05d246cde clean
    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
2026-10-03 chore: resync installed Loom surfaces
    <!-- loom:provenance v1 build=unknown 28040ed11a4369e20f3b7b0154a3fb2a2c35d38c clean prompts=none sweep=none story=none trace=0cd87d01c45d97a2ee57a99363fc0db2 host=robb-studio base=1cc2145091e4ac6251df38ac3f0d1d1b593d56ff run=loom-run/v1:timer:robb-studio/fleet-resync:74b93657-6b04-4ac5-bc77-e0a1682b0595 installs=0.19.636 e41edfbb52c13982f7d8b0577f42957427a6514c -->
    Loom-Trace-Id: 0cd87d01c45d97a2ee57a99363fc0db2
    Loom-Build: unknown 28040ed11a4369e20f3b7b0154a3fb2a2c35d38c clean
    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
2026-10-03 chore: resync installed Loom surfaces
    <!-- loom:provenance v1 build=unknown 388c7fe0cad997f7a887f70c9f2cfe8781a2d512 clean prompts=none sweep=none story=none trace=2046ffd42f138a06b914f34851de3440 host=loom-worker-2 base=89704165f79e798f571b22822504136ba0cb4da4 run=loom-run/v1:timer:loom-worker-2/fleet-resync:17c9456bb1934c70a545b12081496cce installs=0.19.647 d1fe5dead4202be12a964ab891fd5980e7836170 -->
    Loom-Trace-Id: 2046ffd42f138a06b914f34851de3440
    Loom-Build: unknown 388c7fe0cad997f7a887f70c9f2cfe8781a2d512 clean
    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
2026-10-03 chore: resync installed Loom surfaces
    <!-- loom:provenance v1 build=unknown 8078c29e691123d91cd761a786f99cfd25f1809d clean prompts=none sweep=none story=none trace=45869a6374635c036a11a6f379fe31a4 host=robb-pro base=ab91d9e98d341a3ff6e83707c47f3ed5e9f7caf9 run=loom-run/v1:timer:robb-pro/fleet-resync:b0a94991-052d-4e7d-ba2b-78b971096849 installs=0.19.647 709ca4396e074e5a4d1c5e19721f6ddac7154ca2 -->
    Loom-Trace-Id: 45869a6374635c036a11a6f379fe31a4
    Loom-Build: unknown 8078c29e691123d91cd761a786f99cfd25f1809d clean
    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
2026-10-03 chore: resync installed Loom surfaces
    <!-- loom:provenance v1 build=unknown f9cba29b0602624a23daa17ae04d31d82e10fa91 clean prompts=none sweep=none story=none trace=754b3688f97b6c34894d8cfbf272b81a host=loom-worker-1 base=8beedce994f66fa600453a2bbe166efeb0ccb10a run=loom-run/v1:script:loom-worker-1/fleet-resync:11eb117a-9ff3-4411-88d4-fdd7d6748639 installs=0.19.649 6f2f13b1c31ce420e2250ae040d8e1050c0e761b -->
    Loom-Trace-Id: 754b3688f97b6c34894d8cfbf272b81a
    Loom-Build: unknown f9cba29b0602624a23daa17ae04d31d82e10fa91 clean
    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
2026-10-03 chore: resync installed Loom surfaces
    <!-- loom:provenance v1 build=unknown f9cba29b0602624a23daa17ae04d31d82e10fa91 clean prompts=none sweep=none story=none trace=544a028e3829d4020b8aaa144e5fa628 host=robb-studio base=407c0ca7abd38c89b10089ee0e1680b64c896f98 run=loom-run/v1:script:robb-studio/fleet-resync:5b5b8b83-7139-447d-88bd-417dcf375aa6 installs=0.19.649 6f2f13b1c31ce420e2250ae040d8e1050c0e761b -->
    Loom-Trace-Id: 544a028e3829d4020b8aaa144e5fa628
    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
2026-10-03 chore: resync installed Loom surfaces
    <!-- loom:provenance v1 build=unknown f9cba29b0602624a23daa17ae04d31d82e10fa91 clean prompts=none sweep=none story=none trace=1057aaaf811f6dd2d64a3bb6d4b3ac49 host=robb-pro base=76edacc008aeec811734147223352e6033f50eed run=loom-run/v1:timer:robb-pro/fleet-resync:785c1ea0-d7f2-4810-99e9-cd9368aebe0c installs=0.19.649 2118aabb5a925f1ec4669b4d3d31176a46d8f2a6 -->
    Loom-Trace-Id: 1057aaaf811f6dd2d64a3bb6d4b3ac49
    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
2026-10-03 fix: close SG13CMOS5L lock_detector LVS -- RPU body on VSS, contact the w=0.25u XMPD
    Two independent defects, each owning part of the baseline mismatch:
    - design: lock_detector.sch declared RPU's bulk on the private floating
    sub! global while the drawn rhigh's bulk is the one p-substrate node the
    NMOS substrate taps tie to VSS (same family #113 repaired in vco_bias).
    Re-declare it on VSS and regenerate lock_detector.spice via netlist.sh.
    This alone matches PU and removes SUB!.
    - layout: cmos5l_devices.draw_hv_mos silently drew no source/drain
    contact on a device narrower than one contact row (0.30 um), and the
    fixed 0.45/1.05 um riser columns fell outside that device's Metal1 p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
    [lock_detector.sch]
2026-10-03 layout: fresh SG13CMOS5L record -- 6/6 DRC-clean, 6/6 LVS match (#136)
    Record 20261003-183059-dc5644a (clean tree at dc5644a): 569/569 devices
    drawn and DRC-clean, lock_detector now LVS match 41/41 devices, 23/23
    nets, all three cap_cmomi units drawn and matched. Only
    lock_detector_nfet_w0p25_l16.gds and pll_lock_detector.gds differ from the
    a95a887 baseline; every other GDS is byte-identical.
    diagnosis/issue-136/ carries the raw 2x2 LVS crossing (old/new GDS x
    old/new reference) that splits the baseline's five errors into the
    schematic substrate split (PU, SUB!) and the open narrow-device footprint
    (PD, $13, $28), plus a Via1/Cont geometry probe. README updated (status,
    root cause, frictio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
2026-10-03 sim: RECORD-005 -- lock_detector with RPU bulk on VSS, nominal corner (#136)
    New frozen DUT snapshot lock_detector_bodyfix.spice (one line differs
    from RECORD-004's crowbarfix snapshot). run.sh now targets it with its
    own *_bodyfix suffix (solver_retries suffixed too, so RECORD-004's file
    is never truncated), gains NOMINAL_ONLY=1 for a single-corner run with a
    distinct *_bodyfix_nominal suffix, and refuses the full grid on a
    KLT_SIM_BACKEND=batch shared worker.
    At mos_tt/res_typ/27C/3.3V/3.5MHz/real every reduced row is
    byte-identical to RECORD-004; 4/21 raw ladder rows differ by <= 20 uV on
    VWIN (disclosed). The full PVT grid was NOT re-run: corner grids must go
    to the batch fleet on this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
    [ladder_bodyfix_nominal.csv, ladder_raw_bodyfix_nominal.csv, rc_extract_bodyfix_nominal.csv, schmitt_bodyfix_nominal.csv, tstep_convergence_bodyfix_nominal.csv, window_bodyfix_nominal.csv]
2026-10-03 chore: resync installed Loom surfaces
    <!-- loom:provenance v1 build=unknown 72f61d9aa0fe08f1ef59f1a97a314e474455801e clean prompts=none sweep=none story=none trace=90666a75095c62a013be2ea121ab93f1 host=loom-worker-2 base=3a7af21e084e98d6b08cf353b128abf43a1d5f97 run=loom-run/v1:script:loom-worker-2/fleet-resync:13865fad-1cac-4838-857f-34878fcba5d1 installs=0.19.652 235a64727b907d65529151af0a962b14f16462a0 -->
    Loom-Trace-Id: 90666a75095c62a013be2ea121ab93f1
    Loom-Build: unknown 72f61d9aa0fe08f1ef59f1a97a314e474455801e clean
    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
2026-10-03 chore: resync installed Loom surfaces
    <!-- loom:provenance v1 build=unknown 72f61d9aa0fe08f1ef59f1a97a314e474455801e clean prompts=none sweep=none story=none trace=845aaa0eb340f80f12095e2e8b421ed1 host=robb-pro base=339713687dc61fd84a1cd876e424e23d83c468e5 run=loom-run/v1:script:robb-pro/fleet-resync:344add4b-df8a-49e8-8563-2765673acc76 installs=0.19.652 235a64727b907d65529151af0a962b14f16462a0 -->
    Loom-Trace-Id: 845aaa0eb340f80f12095e2e8b421ed1
    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
2026-10-03 chore: resync installed Loom surfaces
    <!-- loom:provenance v1 build=unknown 21130104346fe9c464ce8a3fdf82c1d3e9667639 clean prompts=none sweep=none story=none trace=36308fff5a3c323c3d1bf6fffb6cd122 host=robb-studio base=6992e8086190f801c5741103f9b2d44fd20d72c4 run=loom-run/v1:timer:robb-studio/fleet-resync:89972fbd-0774-4402-bbb7-26c33a851735 installs=0.19.652 fb69233bd8f1dfc2bdee37d8b934f99274dc0193 -->
    Loom-Trace-Id: 36308fff5a3c323c3d1bf6fffb6cd122
    Loom-Build: unknown 21130104346fe9c464ce8a3fdf82c1d3e9667639 clean
    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
2026-10-03 docs: refresh Challenge 6 proposal against closed #112-#115/#136 evidence
    Re-derive the spec table, sign-off table and friction list against the
    now-closed siblings: divider repair measured exact across N in [64,127]
    plus its post-layout arm (RECORD-004), 569/569 devices drawn with 6/6
    LVS match (record 20261003-183059-dc5644a), loop_filter post-layout
    fz/fp shifts, lock-detector #136 body-tie nominal re-check (full grid
    owed in #139), and the pre-resize fz quote corrected. Adds the parent
    #16 criterion-by-criterion review; distinguishes dated historical
    observations from current state throughout. #16 stays open.
    Closes #137
    Loom-Story: 2AMLogic/sg13g2-pll#137
    Loom-Trace-Id: a32aee051e97f8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
2026-10-03 docs: correct total drawn-wire figure to 269.7 mm (during evaluation)
    Loom-Trace-Id: a32aee051e97f8b7ebf4ba5ffc61a418
    Loom-Build: 0.19.652 235a64727b907d65529151af0a962b14f16462a0 clean
    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
2026-10-03 docs: refresh stale layout/sim README sections to LATEST record 20261003-183059-dc5644a (#140)
    Loom-Story: 2AMLogic/sg13g2-pll#140
    Loom-Trace-Id: a6a23e8c42b68daf932913981630b9fb
    Loom-Build: 0.19.653 20928ea4080713480c010ea10914c11bad21fe5f clean
2026-10-03 docs: fix vco wire-length direction in layout README (#140)
    The "What it is not" bullet said vco's 12.995 mm was "down from
    7 178 um", which is backwards: #101's locality pass cut 7 178 -> 3 913 um
    before the caps were drawn, and drawing them (#114) raised it to
    12 994.65 um. State the record's like-for-like comparison instead
    (12 994.65 um vs 16 304.91 um pre-#101 single-row order, record.md
    line 25), keeping the RECORD-001-era 7 178 um as history.
    Judge nits: merge the double parenthetical in "Routing", rewrap the
    over-long lines, and qualify the sim README caveat 2 "147 mm" with
    "(at RECORD-004's layout)".
    Loom-Story: 2AMLogic/sg13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
2026-10-03 docs: attribute divider_chain wire length to the right layout (#140)
    Caveat 2 said RECORD-004's layout carried 147 mm on divider_chain. That
    layout (20260923-020931-a95a887-dirty, post-#121) routes 181 nets /
    234 509.06 um; 147 145.24 um (142 nets) is the RECORD-001/002 layouts
    (457cf5b, c44fa68). Fix the caveat and the RECORD-004 idd table row.
    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
2026-10-04 chore: resync installed Loom surfaces
    <!-- loom:provenance v1 build=unknown 61870b40779d205c1555e801c6e1d95df083cdea clean prompts=none sweep=none story=none trace=fb9213e215442932d2af05f3b14977de host=robb-pro base=31081b36a2bf68973eb5fb7f4a82db962e393420 run=loom-run/v1:timer:robb-pro/fleet-resync:4c70cd1d-08cd-4add-8e2a-9a75160d163f installs=0.19.655 36c39e3c6f56e1979647ec235b4bd19c77db22f3 -->
    Loom-Trace-Id: fb9213e215442932d2af05f3b14977de
    Loom-Build: unknown 61870b40779d205c1555e801c6e1d95df083cdea clean
    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
2026-10-04 chore: resync installed Loom surfaces
    <!-- loom:provenance v1 build=unknown 61870b40779d205c1555e801c6e1d95df083cdea clean prompts=none sweep=none story=none trace=baa6c2cfcae1a320917c00ff2eb8b630 host=loom-worker-2 base=4740609ae8f33f254933d1d717b4fe2f4ba5a1be run=loom-run/v1:timer:loom-worker-2/fleet-resync:741a7f0f16df4fb1be4e657aeacd1244 installs=0.19.655 fc667a4faae1227f8a6837431f8a0c2d0aeaa7dd -->
    Loom-Trace-Id: baa6c2cfcae1a320917c00ff2eb8b630
    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
2026-10-04 chore: resync installed Loom surfaces
    <!-- loom:provenance v1 build=unknown b922acb2ac655cbccd71daa9e3f05a325a094ca5 clean prompts=none sweep=none story=none trace=833eeb34d4ca65c3f8c6f7824ddca3a3 host=robb-studio base=37f51187ee5491acfccbc14cf823f67d52456cd5 run=loom-run/v1:timer:robb-studio/fleet-resync:0d44f6dc-6a62-4d43-b49d-7cfdd7dbd823 installs=0.19.663 0a51e373e7fe1be156c5774b2c827d4b745368a3 -->
    Loom-Trace-Id: 833eeb34d4ca65c3f8c6f7824ddca3a3
    Loom-Build: unknown b922acb2ac655cbccd71daa9e3f05a325a094ca5 clean
    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
2026-10-04 chore: resync installed Loom surfaces
    <!-- loom:provenance v1 build=unknown 746ecb5f9d7e64ba1d2526f1e997530ad4f3dd43 clean prompts=none sweep=none story=none trace=f09501431241df2ec5688e334ba43dfe host=loom-worker-2 base=97981428bcf42286ea04e4489ab097934aa0d198 run=loom-run/v1:timer:loom-worker-2/fleet-resync:70797dad61fb4e21806716d54f1ce910 installs=0.19.669 59a1f84e3742827a8033bb153ebbedc1759bee72 -->
    Loom-Trace-Id: f09501431241df2ec5688e334ba43dfe
    Loom-Build: unknown 746ecb5f9d7e64ba1d2526f1e997530ad4f3dd43 clean
    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
2026-10-04 chore: resync installed Loom surfaces
    <!-- loom:provenance v1 build=unknown 8080d0485cc1312129ee642b084944c56d1be074 clean prompts=none sweep=none story=none trace=ed180bcab6828041123ad54d8ddb4037 host=robb-pro base=8561bb854a80bf3c70a8986975ff0c637965505b run=loom-run/v1:timer:robb-pro/fleet-resync:e97b2f08-4ad9-4b66-a166-5b19820e2d1f installs=0.19.669 59a1f84e3742827a8033bb153ebbedc1759bee72 -->
    Loom-Trace-Id: ed180bcab6828041123ad54d8ddb4037
    Loom-Build: unknown 8080d0485cc1312129ee642b084944c56d1be074 clean
    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
2026-10-04 chore: resync installed Loom surfaces
    <!-- loom:provenance v1 build=unknown 83cb6647167ffc000d2c2f479b4e816b68f863f4 clean prompts=none sweep=none story=none trace=ccabffa1e1ba495895b262086030816c host=robb-studio base=9b05394bcf6ffff2cc939af54ee2647ef96541a2 run=loom-run/v1:timer:robb-studio/fleet-resync:88a78f1f-d978-47b5-99c3-2aabde811d17 installs=0.19.676 cd4f30bd892ea2595d8218b08150633504b0dd14 -->
    Loom-Trace-Id: ccabffa1e1ba495895b262086030816c
    Loom-Build: unknown 83cb6647167ffc000d2c2f479b4e816b68f863f4 clean
    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
2026-10-04 chore: resync installed Loom surfaces
    <!-- loom:provenance v1 build=unknown 32174d0f7e80508fa66c1a11a2c0fb28c515607e clean prompts=none sweep=none story=none trace=436d7c19b10cd5807625a7ce7190a82f host=loom-worker-2 base=39863d47bedb863e3246d49835281500f55942b7 run=loom-run/v1:timer:loom-worker-2/fleet-resync:19ae50771cc04d8db7b1403c1e66bbea installs=0.19.682 9eccfa110fa294fa32a62ffe8eff669cfcf1a3a6 -->
    Loom-Trace-Id: 436d7c19b10cd5807625a7ce7190a82f
    Loom-Build: unknown 32174d0f7e80508fa66c1a11a2c0fb28c515607e clean
    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
2026-10-04 chore: resync installed Loom surfaces
    <!-- loom:provenance v1 build=unknown 72290fa960e0773b2c50d74042e24914c7327637 clean prompts=none sweep=none story=none trace=f7b6952a649a174398a48b90b6ab4793 host=robb-pro base=7ed46cb563c3be95369a96cb7efd62299c083b3a run=loom-run/v1:timer:robb-pro/fleet-resync:72f32482-5cc4-4b38-ab9e-4d2ef0b64e94 installs=0.19.684 bdb8fb331eb51c7def4cdd2c38b611af06f25f6d -->
    Loom-Trace-Id: f7b6952a649a174398a48b90b6ab4793
    Loom-Build: unknown 72290fa960e0773b2c50d74042e24914c7327637 clean
    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
2026-10-04 chore: resync installed Loom surfaces
    <!-- loom:provenance v1 build=unknown 76cda58637be0e74c4cb5b4c8dbc2000e2a9c3d4 clean prompts=none sweep=none story=none trace=614cbada5ce873c2b34a511816309cfc host=robb-studio base=326d21a4794cf433206c19e31694d9f1069eab2e run=loom-run/v1:timer:robb-studio/fleet-resync:7e559a3b-ffdd-409b-8dd2-ae906a273b0a installs=0.19.692 d4974b9f5ff7843a3cfc06378ea2a69bc120e0f4 -->
    Loom-Trace-Id: 614cbada5ce873c2b34a511816309cfc
    Loom-Build: unknown 76cda58637be0e74c4cb5b4c8dbc2000e2a9c3d4 clean
    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
2026-10-04 chore: resync installed Loom surfaces
    <!-- loom:provenance v1 build=unknown f84bac5c232c093f83c1adc2533d8c75b021cda2 clean prompts=none sweep=none story=none trace=e687830614e4bd1c551ab6cf6186f8f3 host=loom-worker-2 base=8eec5129e79cd3f426c7a6ecc5b245b495d6c963 run=loom-run/v1:timer:loom-worker-2/fleet-resync:2db2c4373ac24de1b7a364e69eaea1ca installs=0.19.695 b0d5b09f207fda439390ea1dd249ad10e7009dfc -->
    Loom-Trace-Id: e687830614e4bd1c551ab6cf6186f8f3
    Loom-Build: unknown f84bac5c232c093f83c1adc2533d8c75b021cda2 clean
    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
2026-10-04 chore: resync installed Loom surfaces
    <!-- loom:provenance v1 build=unknown ac5c275d1c616a9723e747f5a66de93dc80d3512 clean prompts=none sweep=none story=none trace=c777c3912bd31972e9aa3ccab712ae01 host=loom-worker-1 base=75b4f2eeedcd15fac9cd1731e5c3719f5b7260de run=loom-run/v1:script:loom-worker-1/fleet-resync:b51a1b33-4958-4408-be36-166e12e8360b installs=0.19.697 ada83a5c7ff66b56b0060ef0be368c9fe56eb3c6 -->
    Loom-Trace-Id: c777c3912bd31972e9aa3ccab712ae01
    Loom-Build: unknown ac5c275d1c616a9723e747f5a66de93dc80d3512 clean
    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
2026-10-04 chore: resync installed Loom surfaces
    <!-- loom:provenance v1 build=unknown a19f642f5c09599c4c64827d81d228eb031be73e clean prompts=none sweep=none story=none trace=34a80e22764eb5055e37faec0eaf65fb host=robb-pro base=8abd04e7a1ad3efa7f7d2bcb233a6d042523ebf8 run=loom-run/v1:script:robb-pro/fleet-resync:689be620-3ff2-4ff5-a2ce-f6825f6379e2 installs=0.19.698 aa619a1d07e36e8d90ac01fea63dc39285c93567 -->
    Loom-Trace-Id: 34a80e22764eb5055e37faec0eaf65fb
    Loom-Build: unknown a19f642f5c09599c4c64827d81d228eb031be73e clean
    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
2026-10-04 chore: resync installed Loom surfaces
    <!-- loom:provenance v1 build=unknown 693bdd794cb34afdefd7f0c4596824cd53078a61 clean prompts=none sweep=none story=none trace=aa18f1ec102a98d77ffc51c9be6ffbb3 host=robb-studio base=2c07cb030ab65c1a2d91d2f71865be43f92723ac run=loom-run/v1:script:robb-studio/fleet-resync:3cb89ca8-62c2-4a69-8434-c4aaa3b64eaf installs=0.19.698 a58f00e0681c50d6bfc5089d0af4b3715198319f -->
    Loom-Trace-Id: aa18f1ec102a98d77ffc51c9be6ffbb3
    Loom-Build: unknown 693bdd794cb34afdefd7f0c4596824cd53078a61 clean
    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
2026-10-04 chore: resync installed Loom surfaces
    <!-- loom:provenance v1 build=unknown 7a41c2e69ef89d60ed3bd190b94838021bf18d0f clean prompts=none sweep=none story=none trace=d0f04f38b507d85402723643fcf47197 host=loom-worker-1 base=40a3890221fa8f8852da03dffcd485b92baa7db2 run=loom-run/v1:script:loom-worker-1/fleet-resync:8fdc8c1c-f844-4c33-bc80-b424e5b4cf3d installs=0.19.703 89d5a428c652f957d7fad8a546589042d39911bc -->
    Loom-Trace-Id: d0f04f38b507d85402723643fcf47197
    Loom-Build: unknown 7a41c2e69ef89d60ed3bd190b94838021bf18d0f clean
    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
2026-10-05 chore: resync installed Loom surfaces
    <!-- loom:provenance v1 build=unknown ebb37db560de172930e261675a35bd52e429f650 clean prompts=none sweep=none story=none trace=a40e86a64366c7a1e36aea026901334f host=loom-worker-2 base=f9ec86ac189fa549da8e5076685393a20b7ac799 run=loom-run/v1:script:loom-worker-2/fleet-resync:90b6cd74-6cc0-4f58-98ee-6ede0ac6f50c installs=0.19.703 f63c3c82e6bf202f2ca7b205b532f681c5ebb2c8 -->
    Loom-Trace-Id: a40e86a64366c7a1e36aea026901334f
    Loom-Build: unknown ebb37db560de172930e261675a35bd52e429f650 clean
    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
2026-10-05 chore: resync installed Loom surfaces
    <!-- loom:provenance v1 build=unknown 7a41c2e69ef89d60ed3bd190b94838021bf18d0f clean prompts=none sweep=none story=none trace=fc04851db12f586b5d58155325131b6e host=robb-studio base=a550a56a919c368462f7365f37d65191c11ee476 run=loom-run/v1:timer:robb-studio/fleet-resync:a7d5da6f-a896-4d6f-8d00-aebf47f9b266 installs=0.19.703 2ad9a08fb93de4d7dfac9d2b501d12c684c9c2cc -->
    Loom-Trace-Id: fc04851db12f586b5d58155325131b6e
    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
2026-10-05 chore: resync installed Loom surfaces
    <!-- loom:provenance v1 build=unknown afe7e99e397c242cc319fa80702fb3b23e23f5a7 clean prompts=none sweep=none story=none trace=e46782e1dd9c94461b4cf934ce05296b host=loom-worker-2 base=e754f1cbbcaa313ef5bb98a6183a04818af9a639 run=loom-run/v1:timer:loom-worker-2/fleet-resync:caa89259b1fd414ebd2f07500621166d installs=0.19.703 972fe7321be6a9efe2653579379ea3bc40b899b2 -->
    Loom-Trace-Id: e46782e1dd9c94461b4cf934ce05296b
    Loom-Build: unknown afe7e99e397c242cc319fa80702fb3b23e23f5a7 clean
    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
2026-10-05 chore: resync installed Loom surfaces
    <!-- loom:provenance v1 build=unknown b44cb904ebb599db793066ccc631c846862abfbd clean prompts=none sweep=none story=none trace=9590fed7c1b1c9f549ccf3cba24292d7 host=robb-pro base=fc8d8310ddb7783365b8b926e5e11ee408584200 run=loom-run/v1:timer:robb-pro/fleet-resync:dbc6174e-403d-422d-98b6-73a4b6dbf44f installs=0.19.708 dc8faf1eae3143feda6301887c303b1ee45db7f4 -->
    Loom-Trace-Id: 9590fed7c1b1c9f549ccf3cba24292d7
    Loom-Build: unknown b44cb904ebb599db793066ccc631c846862abfbd clean
    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
2026-10-05 chore: resync installed Loom surfaces
    <!-- loom:provenance v1 build=unknown 4548905848fcb7cb875c1c0518f2fd88eb65818e clean prompts=none sweep=none story=none trace=aff5e139797705f6fa0811f102ecd103 host=loom-worker-1 base=f75901f80713230fe16d064d9c3a210e8d2cb7b9 run=loom-run/v1:timer:loom-worker-1/fleet-resync:ba6a9e5686a64abaa842d71acaeae2ca installs=0.19.718 00d99344506bcf00e1aec7e910abe3d13df2d240 -->
    Loom-Trace-Id: aff5e139797705f6fa0811f102ecd103
    Loom-Build: unknown 4548905848fcb7cb875c1c0518f2fd88eb65818e clean
    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
2026-10-05 chore: resync installed Loom surfaces
    <!-- loom:provenance v1 build=unknown e7efbaa6e7b97a7d72da6032044c67525291f4d1 clean prompts=none sweep=none story=none trace=d74a33a6f35e329b3e795991e790ebfd host=robb-studio base=74d51ab9dc453638705184e264bf9b59b0ea4dde run=loom-run/v1:timer:robb-studio/fleet-resync:304f49c8-5b3e-46a9-a557-945b9ae177f0 installs=0.19.718 00d99344506bcf00e1aec7e910abe3d13df2d240 -->
    Loom-Trace-Id: d74a33a6f35e329b3e795991e790ebfd
    Loom-Build: unknown e7efbaa6e7b97a7d72da6032044c67525291f4d1 clean
    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
2026-10-05 chore: resync installed Loom surfaces
    <!-- loom:provenance v1 build=unknown 347b71e65e709d9fd49aba75d3fb67877fc08818 clean prompts=none sweep=none story=none trace=f9653dd318724c98136e7cef63e551ed host=robb-pro base=f6f703fa7a0ffe229c70ec6fe4cbecb0afc61cf9 run=loom-run/v1:timer:robb-pro/fleet-resync:cdc95970-9fb1-49fa-a0e6-037a3fab2099 installs=0.19.728 991dcebf6f6b2de6571f1d3400bec083498c6438 -->
    Loom-Trace-Id: f9653dd318724c98136e7cef63e551ed
    Loom-Build: unknown 347b71e65e709d9fd49aba75d3fb67877fc08818 clean
    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
2026-10-05 chore: resync installed Loom surfaces
    <!-- loom:provenance v1 build=unknown 5c0d18101f48fecb656f10fa37afa9b09bf41631 clean prompts=none sweep=none story=none trace=ddcf49552af364cbf6e884bd59584c1f host=loom-worker-1 base=bb66f9c7c1fd5ec2a0e5e0e1fdc09bd2118d27fa run=loom-run/v1:timer:loom-worker-1/fleet-resync:5eb526a05f244f1985770579e7620ff1 installs=0.19.731 7484b71fce5179a025950e71a82855afaf6fd730 -->
    Loom-Trace-Id: ddcf49552af364cbf6e884bd59584c1f
    Loom-Build: unknown 5c0d18101f48fecb656f10fa37afa9b09bf41631 clean
    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
2026-10-05 chore: resync installed Loom surfaces
    <!-- loom:provenance v1 build=unknown 0b160514b6658e3ab26a71c6525791da25b46fcf clean prompts=none sweep=none story=none trace=311c3eb2c0ab9550d3de38df5523f3d7 host=robb-studio base=7cfad0f6fc712d75e27e4fda69cb743bb7cdc406 run=loom-run/v1:timer:robb-studio/fleet-resync:e6dec631-b42b-4cf2-b854-cc363cfde6e0 installs=0.19.731 d6146becf339a3d4e55e26e8807ac4571213a00b -->
    Loom-Trace-Id: 311c3eb2c0ab9550d3de38df5523f3d7
    Loom-Build: unknown 0b160514b6658e3ab26a71c6525791da25b46fcf clean
    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
2026-10-05 chore: resync installed Loom surfaces
    <!-- loom:provenance v1 build=unknown 5c0d18101f48fecb656f10fa37afa9b09bf41631 clean prompts=none sweep=none story=none trace=f1e8d4c6e73b8eec3e87a8da52e10f2d host=robb-pro base=b967332d214c132e3b2c452c63fe617508c6f9ef run=loom-run/v1:timer:robb-pro/fleet-resync:5518fd33-81cb-479f-93f0-287ea4b08876 installs=0.19.733 4e67131ce3a1317d8cb8904ec342541cc2f45665 -->
    Loom-Trace-Id: f1e8d4c6e73b8eec3e87a8da52e10f2d
    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
2026-10-05 chore: resync installed Loom surfaces
    <!-- loom:provenance v1 build=unknown ca170d11544ef499cc9500a45bbad152edacfbd1 clean prompts=none sweep=none story=none trace=6dcfc713b6a851b40932158c2eeb70af host=loom-worker-3 base=922d34dc3f00bfbcf87dd40879cd9bf5c56d7b96 run=loom-run/v1:timer:loom-worker-3/fleet-resync:20ce0908ea5a468a9e055470104047ed installs=0.19.734 7ba6ea50c36dfdd2b5e2922dd22c65560980a5a2 -->
    Loom-Trace-Id: 6dcfc713b6a851b40932158c2eeb70af
    Loom-Build: unknown ca170d11544ef499cc9500a45bbad152edacfbd1 clean
    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
2026-10-05 chore: resync installed Loom surfaces
    <!-- loom:provenance v1 build=unknown 03f1c42302d15f8a83425a84a4e36ca484f3f625 clean prompts=none sweep=none story=none trace=f1bc879f8aa652d550764ffcd36e27d1 host=loom-worker-1 base=3194710323b8761d673db9d19284b35e34d745a3 run=loom-run/v1:timer:loom-worker-1/fleet-resync:f302a3cc8558413492093df510b02418 installs=0.19.734 967abe71d019ce6606018b4e57dee0223b84d96f -->
    Loom-Trace-Id: f1bc879f8aa652d550764ffcd36e27d1
    Loom-Build: unknown 03f1c42302d15f8a83425a84a4e36ca484f3f625 clean
    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
2026-10-05 chore: resync installed Loom surfaces
    <!-- loom:provenance v1 build=unknown ce7557ba58624d48fedbca2bc037dfa8ce3943e7 clean prompts=none sweep=none story=none trace=e1f2558834c47835cd9a53ec8c9a2ffa host=loom-worker-3 base=2b8bc5071e400658c5a3bbf280ad1449b095db9e run=loom-run/v1:timer:loom-worker-3/fleet-resync:50f5f0046e2c4890961b3221bd360247 installs=0.19.734 ba9edb650872e5265eaca0c47f75e3cb828ecad2 -->
    Loom-Trace-Id: e1f2558834c47835cd9a53ec8c9a2ffa
    Loom-Build: unknown ce7557ba58624d48fedbca2bc037dfa8ce3943e7 clean
    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
2026-10-05 chore: resync installed Loom surfaces
    <!-- loom:provenance v1 build=unknown f92eaec38470a7b0732e065f4864faec9a1905d6 clean prompts=none sweep=none story=none trace=07aa020a8179d52651250562e9808b98 host=robb-studio base=7dc51da7081a40cf4b2e07d43da3c87b39dd939b run=loom-run/v1:timer:robb-studio/fleet-resync:3b3ebdf2-b5f7-48ed-b7bb-5fb945094061 installs=0.19.734 78f3e99c44d0af6d4598adf7577bb6676baf3e8f -->
    Loom-Trace-Id: 07aa020a8179d52651250562e9808b98
    Loom-Build: unknown f92eaec38470a7b0732e065f4864faec9a1905d6 clean
    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
2026-10-06 chore: resync installed Loom surfaces
    <!-- loom:provenance v1 build=unknown ca170d11544ef499cc9500a45bbad152edacfbd1 clean prompts=none sweep=none story=none trace=fca9c14d74d6d634726f5823c51bc62a host=loom-worker-2 base=a1a6b41b4afe844bc96f7f7f384ac4b1abc35651 run=loom-run/v1:timer:loom-worker-2/fleet-resync:23a23f0878c1494cb720941baddfea81 installs=0.19.741 3cede3920c6b567d5400789187a904970d46b0fb -->
    Loom-Trace-Id: fca9c14d74d6d634726f5823c51bc62a
    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
2026-10-06 chore: resync installed Loom surfaces
    <!-- loom:provenance v1 build=unknown e38a22941348fd8e83d1f4b06130d2a214adfb50 clean prompts=none sweep=none story=none trace=a7fe3a9a1fedfce89846c20f2e98ac31 host=robb-pro base=2aa8811e9b27e53b3306a8d346995d20fcc480bd run=loom-run/v1:timer:robb-pro/fleet-resync:2d770a42-f0e7-4695-abfa-b912e75382e6 installs=0.19.744 8bc5bcce93c4d9721817387afe8b4b6d79f26054 -->
    Loom-Trace-Id: a7fe3a9a1fedfce89846c20f2e98ac31
    Loom-Build: unknown e38a22941348fd8e83d1f4b06130d2a214adfb50 clean
    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
2026-10-06 chore: resync installed Loom surfaces
    <!-- loom:provenance v1 build=unknown f66ea90ff1bdec51aa4c8dc3f4b2e8d26e3dfd2d clean prompts=none sweep=none story=none trace=66d96c3bb00b04fae967865ee02fc4de host=loom-worker-3 base=a1fca4a5432f86728708869673ab833b2e719bde run=loom-run/v1:timer:loom-worker-3/fleet-resync:eb2dceb410e848a19d58f96f678c995e installs=0.19.749 6135634b053dc30ef5aa8e6d733bfe79bb2ac734 -->
    Loom-Trace-Id: 66d96c3bb00b04fae967865ee02fc4de
    Loom-Build: unknown f66ea90ff1bdec51aa4c8dc3f4b2e8d26e3dfd2d clean
    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
2026-10-06 chore: resync installed Loom surfaces
    <!-- loom:provenance v1 build=unknown ade8a2c60cc8370d04d72f331141acb6fb32e121 clean prompts=none sweep=none story=none trace=6245fb88b5bdf9f7ccecb6b2168dc335 host=robb-studio base=04205e30c17c74ae7ae697c772d6a93df6af8906 run=loom-run/v1:timer:robb-studio/fleet-resync:b305aed2-1a25-4576-aca7-9b017ac4377e installs=0.19.755 8d97d322e1cb3723988504337089beca73d0511c -->
    Loom-Trace-Id: 6245fb88b5bdf9f7ccecb6b2168dc335
    Loom-Build: unknown ade8a2c60cc8370d04d72f331141acb6fb32e121 clean
    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
2026-10-06 chore: resync installed Loom surfaces
    <!-- loom:provenance v1 build=unknown 2489bb7d5203844b3fbe8efbe007f44aa074685d clean prompts=none sweep=none story=none trace=0b5c9263a55c09e6fbd870b2d9ff5d9b host=loom-worker-2 base=8ec79358893f5beb975b0c9a5f8978cd79546f85 run=loom-run/v1:timer:loom-worker-2/fleet-resync:d3f5a5beb1144f72ac8be575767b3e03 installs=0.19.760 3a509582b179d91c2d5b5a65a7ba4650c3c08985 -->
    Loom-Trace-Id: 0b5c9263a55c09e6fbd870b2d9ff5d9b
    Loom-Build: unknown 2489bb7d5203844b3fbe8efbe007f44aa074685d clean
    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
2026-10-06 chore: resync installed Loom surfaces
    <!-- loom:provenance v1 build=unknown 986d16b700174622774ff68af4ef323e8d0e23ba clean prompts=none sweep=none story=none trace=cb518f1f5785c258556383940a46c461 host=loom-worker-1 base=30241e1ccdd83b1b8ffb3836688d451bf7aecb48 run=loom-run/v1:timer:loom-worker-1/fleet-resync:97df92c5eca846de85e979810663a94b installs=0.19.765 c6cec65c4f320f11153c72e840e49a5d6a6f1afc -->
    Loom-Trace-Id: cb518f1f5785c258556383940a46c461
    Loom-Build: unknown 986d16b700174622774ff68af4ef323e8d0e23ba clean
    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
2026-10-06 chore: resync installed Loom surfaces
    <!-- loom:provenance v1 build=unknown 85e52221261264d7f7643251de706f00c8db289f clean prompts=none sweep=none story=none trace=a2434124d73d8cca0ca77230fc85adf5 host=robb-pro base=a35adf33632036549f8b443676a715a4a96629a4 run=loom-run/v1:timer:robb-pro/fleet-resync:abffb067-59ed-4a6e-94b6-8cf3500c935c installs=0.19.768 c9f7ca975144d991bce40f492403b8292e8b7fae -->
    Loom-Trace-Id: a2434124d73d8cca0ca77230fc85adf5
    Loom-Build: unknown 85e52221261264d7f7643251de706f00c8db289f clean
    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
2026-10-06 chore: resync installed Loom surfaces
    <!-- loom:provenance v1 build=unknown 31b34ebfd7d4539094523eaa7b56a104bebe5fc0 clean prompts=none sweep=none story=none trace=16fac36f144dc183c71465eb36c89afc host=loom-worker-3 base=a3104d4f47e5ae44fff794644ecd7e32bc034f41 run=loom-run/v1:timer:loom-worker-3/fleet-resync:c763e24590314b918c8ee8df5d2de1db installs=0.19.769 af995a5725fdadf708127f006aa8f248b482d7d7 -->
    Loom-Trace-Id: 16fac36f144dc183c71465eb36c89afc
    Loom-Build: unknown 31b34ebfd7d4539094523eaa7b56a104bebe5fc0 clean
    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
2026-10-06 chore: resync installed Loom surfaces
    <!-- loom:provenance v1 build=unknown 7bed309263b3785eae46a9cbc53b3b24a52b10d2 clean prompts=none sweep=none story=none trace=843adbd5eac450c43d3a2c43da1bf729 host=robb-studio base=07e8f7840123d4057322c27324764c6c89086aad run=loom-run/v1:timer:robb-studio/fleet-resync:f83d5ba4-81f7-479a-9768-6af33d4cc825 installs=0.19.783 a9b459e0c2b1916ceb116db33053e7eb0df57e7b -->
    Loom-Trace-Id: 843adbd5eac450c43d3a2c43da1bf729
    Loom-Build: unknown 7bed309263b3785eae46a9cbc53b3b24a52b10d2 clean
    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
2026-10-06 chore: resync installed Loom surfaces
    <!-- loom:provenance v1 build=unknown 07bc40ba9ab0f7dfe7cd0990377b7ac07a52d220 clean prompts=none sweep=none story=none trace=563f186108419cf03cef002a62c3b201 host=loom-worker-2 base=61bfeca98eacf5c6c3240c5992e26538576cc8a3 run=loom-run/v1:timer:loom-worker-2/fleet-resync:944beccd157a4197b81feafdd19f443e installs=0.19.785 2f0a9dbb4f06053f747b8a5615a3519f8e30b527 -->
    Loom-Trace-Id: 563f186108419cf03cef002a62c3b201
    Loom-Build: unknown 07bc40ba9ab0f7dfe7cd0990377b7ac07a52d220 clean
    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
2026-10-06 chore: resync installed Loom surfaces
    <!-- loom:provenance v1 build=unknown 31b34ebfd7d4539094523eaa7b56a104bebe5fc0 clean prompts=none sweep=none story=none trace=ea6600df41a4b420b6d8e967f839ccfd host=loom-worker-3 base=db70fd1670c2c12da6df5bc69c2dbc68dafdec09 run=loom-run/v1:timer:loom-worker-3/fleet-resync:c80415b48fd5404bbd599c4f6cc8a448 installs=0.19.793 7ceff96944c39d33e3c2f1141ca650c2c4c05679 -->
    Loom-Trace-Id: ea6600df41a4b420b6d8e967f839ccfd
    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
2026-10-06 chore: resync installed Loom surfaces
    <!-- loom:provenance v1 build=unknown 596a53e525683919daae1b43e6babe9bf847a02f clean prompts=none sweep=none story=none trace=b9c0cb42a5a72ecc21726229c957ef1f host=loom-worker-2 base=bceb7a834bfe37f843fba4e7416b5f4eec56c8e8 run=loom-run/v1:timer:loom-worker-2/fleet-resync:21d578f5cc0b4b7ba5f10759f5f30ae8 installs=0.19.801 524bdb33cb26c8355454d7550413c89e72c06fae -->
    Loom-Trace-Id: b9c0cb42a5a72ecc21726229c957ef1f
    Loom-Build: unknown 596a53e525683919daae1b43e6babe9bf847a02f clean
    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
2026-10-06 chore: resync installed Loom surfaces
    <!-- loom:provenance v1 build=unknown 40b591a33adb895d4f46977105f9b264d8a2599b clean prompts=none sweep=none story=none trace=e41c725fe0c176312eb412bc69fe5b01 host=robb-studio base=356a75ff8bbed5dc0549758854e71e331f74a02b run=loom-run/v1:timer:robb-studio/fleet-resync:37d704dd-4dfd-4341-adb4-6551637ad147 installs=0.19.802 72ce1f7385747dd773d1644408ec22072b8a5d20 -->
    Loom-Trace-Id: e41c725fe0c176312eb412bc69fe5b01
    Loom-Build: unknown 40b591a33adb895d4f46977105f9b264d8a2599b clean
    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
2026-10-06 chore: resync installed Loom surfaces
    <!-- loom:provenance v1 build=unknown 31b34ebfd7d4539094523eaa7b56a104bebe5fc0 clean prompts=none sweep=none story=none trace=5ad0480c4b21b80f9c852c448319e7a1 host=loom-worker-3 base=8b8f4ae117d110cc959dc6a7a18e71bf698e59fa run=loom-run/v1:timer:loom-worker-3/fleet-resync:48e836f11f9547ddb96de5aa0d072a05 installs=0.19.810 933f828e779602e492e4e157812988a4b8128111 -->
    Loom-Trace-Id: 5ad0480c4b21b80f9c852c448319e7a1
    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
2026-10-07 chore: resync installed Loom surfaces
    <!-- loom:provenance v1 build=unknown f71cf25de9e75bae6060da4a599df8fbabe75890 clean prompts=none sweep=none story=none trace=64943e35511da4833bbd385cf288be8a host=loom-worker-2 base=ae3fd1965e8be4e29b6d5e334b71b6c4f2740232 run=loom-run/v1:timer:loom-worker-2/fleet-resync:d69eb1b87d4849ae810a145b1b667d2f installs=0.19.822 1c6969ea8726c800a353c236d9f23456a5706f1a -->
    Loom-Trace-Id: 64943e35511da4833bbd385cf288be8a
    Loom-Build: unknown f71cf25de9e75bae6060da4a599df8fbabe75890 clean
    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
2026-10-07 chore: resync installed Loom surfaces
    <!-- loom:provenance v1 build=unknown 31b34ebfd7d4539094523eaa7b56a104bebe5fc0 clean prompts=none sweep=none story=none trace=cb192cb8f72cf6f2711f73f7ee12bebc host=loom-worker-3 base=96a8988d7c6a62b7a6d16e5e4e04d1aee0425e88 run=loom-run/v1:timer:loom-worker-3/fleet-resync:c1e385c3607e43ad8bed9c7d29811c66 installs=0.19.830 a966f7b89b714704fa1225b96e2dbee50480a4c6 -->
    Loom-Trace-Id: cb192cb8f72cf6f2711f73f7ee12bebc
    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
2026-10-07 refactor(sim): consolidate gen_ladder.py copies into sim/tools/gen_lock_ladder.py (#127)
    One shared ladder generator/reducer carrying record002/hystfix/resized and an
    optional --corner-cap; repoint all call sites and the SG13G2 README.
    Loom-Story: 2AMLogic/sg13g2-pll#127
    Loom-Trace-Id: 658c1fb55015fb5d005650a08d8571e1
    Loom-Build: 0.19.827 6b5119f48f153d6e74b5815da984b8998af166eb clean
2026-10-07 chore: resync installed Loom surfaces
    <!-- loom:provenance v1 build=unknown 8abdd34fddc879aff407380278baa713eca6b758 clean prompts=none sweep=none story=none trace=ea945665dad5ccb3880de51c4448e8b9 host=robb-pro base=49746b1b44006362e73fee60569643a54ac55482 run=loom-run/v1:timer:robb-pro/fleet-resync:1466e397-b80c-46ea-a42c-26a7fbd4e00e installs=0.19.831 61814c9c1912925cdff7418842ff3ea17cd56fe4 -->
    Loom-Trace-Id: ea945665dad5ccb3880de51c4448e8b9
    Loom-Build: unknown 8abdd34fddc879aff407380278baa713eca6b758 clean
    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
2026-10-07 chore: resync installed Loom surfaces
    <!-- loom:provenance v1 build=unknown 628be5bb140bcff803d159201bd61e1b868901b0 clean prompts=none sweep=none story=none trace=093df1dc315c5e78dcccfca9d699d5f5 host=loom-worker-2 base=0526f7f05454eca9477681d8cbc590dc14690fc2 run=loom-run/v1:timer:loom-worker-2/fleet-resync:0b0ea5e184c0429a9c431fcca6c791ad installs=0.19.832 1a0fc15974bf0575a9155fb8276f7529fc813542 -->
    Loom-Trace-Id: 093df1dc315c5e78dcccfca9d699d5f5
    Loom-Build: unknown 628be5bb140bcff803d159201bd61e1b868901b0 clean
    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
2026-10-07 chore: resync installed Loom surfaces
    <!-- loom:provenance v1 build=unknown 069e3b45d86c08f0d60c8fc2b0096de441e99bdc clean prompts=none sweep=none story=none trace=b1ba9d6b2b581e47827d9c099f717b04 host=loom-worker-1 base=11f2031c9de7eb914e746942a1171794811eecf1 run=loom-run/v1:timer:loom-worker-1/fleet-resync:aada8278bd4843bcaecce69fdf91251e installs=0.19.838 e70aa17f8dead31bda49cf044c3fc28119df6e90 -->
    Loom-Trace-Id: b1ba9d6b2b581e47827d9c099f717b04
    Loom-Build: unknown 069e3b45d86c08f0d60c8fc2b0096de441e99bdc clean
    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
2026-10-07 chore: resync installed Loom surfaces
    <!-- loom:provenance v1 build=unknown 31b34ebfd7d4539094523eaa7b56a104bebe5fc0 clean prompts=none sweep=none story=none trace=ef030e94bce76f728497f5927960865f host=loom-worker-3 base=f5d28876d3c72f17b6930e9841406b3584978ea5 run=loom-run/v1:timer:loom-worker-3/fleet-resync:28ba4284bfa446c888b501714eda0509 installs=0.19.840 59b533a2a1ed5e186fbf8446b5acbe42d7231854 -->
    Loom-Trace-Id: ef030e94bce76f728497f5927960865f
    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
2026-10-07 chore: resync installed Loom surfaces
    <!-- loom:provenance v1 build=unknown bc59c70c3412a87b31a0dbe65cd6abf968744328 clean prompts=none sweep=none story=none trace=766033e4e881801f24971d664c490ea3 host=robb-studio base=84219fdf62d8acdbaf6f88de3c131edd48f95fc2 run=loom-run/v1:timer:robb-studio/fleet-resync:6b3b079a-890e-4a79-9c3a-0b4bb33ff7c4 installs=0.19.840 59b533a2a1ed5e186fbf8446b5acbe42d7231854 -->
    Loom-Trace-Id: 766033e4e881801f24971d664c490ea3
    Loom-Build: unknown bc59c70c3412a87b31a0dbe65cd6abf968744328 clean
    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
2026-10-07 chore: resync installed Loom surfaces
    <!-- loom:provenance v1 build=unknown a068938e7a6c13759bcb3943e408273a3d352257 clean prompts=none sweep=none story=none trace=76bec863c8f6aff2d49b3aa2be128619 host=robb-pro base=085e1db013e3f2c655bb7adf7209bdb68de3ccdd run=loom-run/v1:timer:robb-pro/fleet-resync:d9927fc6-ee80-4b6a-ba2b-f13576bd5f9b installs=0.19.846 837b14d7440b89ae8a2cec6d045483ac33659af5 -->
    Loom-Trace-Id: 76bec863c8f6aff2d49b3aa2be128619
    Loom-Build: unknown a068938e7a6c13759bcb3943e408273a3d352257 clean
    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
2026-10-07 chore: resync installed Loom surfaces
    <!-- loom:provenance v1 build=unknown 628be5bb140bcff803d159201bd61e1b868901b0 clean prompts=none sweep=none story=none trace=5a6f676b4652a1a750bbce1386c68d06 host=loom-worker-2 base=087a00a84c11db15b91f45c4b30ba36366b491d5 run=loom-run/v1:timer:loom-worker-2/fleet-resync:bd416e653be04ef4b13353430625e379 installs=0.19.850 3bb4bfc90603b6ad65cabca9b3eb42a59f1a9d3a -->
    Loom-Trace-Id: 5a6f676b4652a1a750bbce1386c68d06
    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
2026-10-07 chore: resync installed Loom surfaces
    <!-- loom:provenance v1 build=unknown 40215645df8a13508180b248b44244dc488bb078 clean prompts=none sweep=none story=none trace=29fde30615e6e47f39b41aa314c2c883 host=loom-worker-1 base=455b4db478da726843cf80d197faf08d590bb291 run=loom-run/v1:timer:loom-worker-1/fleet-resync:d1fbedfcc7824ae59233c0ea94dc4650 installs=0.19.853 2889d5ed585b4da0935543cb916381cc03b19746 -->
    Loom-Trace-Id: 29fde30615e6e47f39b41aa314c2c883
    Loom-Build: unknown 40215645df8a13508180b248b44244dc488bb078 clean
    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
2026-10-07 chore: resync installed Loom surfaces
    <!-- loom:provenance v1 build=unknown 31b34ebfd7d4539094523eaa7b56a104bebe5fc0 clean prompts=none sweep=none story=none trace=cdf49c615da3f5ce46e9fcda1a24f787 host=loom-worker-3 base=e1e9838d80711aeef7d2ccfe0432bd5ccfb4caf1 run=loom-run/v1:timer:loom-worker-3/fleet-resync:cab31e05b8a24df09bc88f53ee3fb501 installs=0.19.857 7a0b529e6f57a79713f6924bf58d8392ff404259 -->
    Loom-Trace-Id: cdf49c615da3f5ce46e9fcda1a24f787
    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
2026-10-07 chore: resync installed Loom surfaces
    <!-- loom:provenance v1 build=unknown 4b44e7c5db0de1d2b5927de7de229120d546aad3 clean prompts=none sweep=none story=none trace=dfa656ee3483a044378501f49d36f812 host=robb-studio base=45faaf4532247f1a13d3d005a219a0e7fbbfd3c1 run=loom-run/v1:timer:robb-studio/fleet-resync:d80d6bc0-eb68-4a07-8226-2d947d328b3a installs=0.19.859 0aefebd79aba8ab33470f1af4b96847fc794bd0d -->
    Loom-Trace-Id: dfa656ee3483a044378501f49d36f812
    Loom-Build: unknown 4b44e7c5db0de1d2b5927de7de229120d546aad3 clean
    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
2026-10-07 chore: resync installed Loom surfaces
    <!-- loom:provenance v1 build=unknown b591c8cf436f0d4aa5870a9bc7cd5f7194e0e778 dirty prompts=none sweep=none story=none trace=6eca4b0c47205457aae7a3d721c17f17 host=robb-pro base=c444d5ca34c3ff0df7fd57d552ceca2494889cdf run=loom-run/v1:timer:robb-pro/fleet-resync:64af20b3-58cb-47f2-b770-117197cb41e9 installs=0.19.864 128a7eba2bb5f7bcf8891ba284b14cb7ebf8dd3d -->
    Loom-Trace-Id: 6eca4b0c47205457aae7a3d721c17f17
    Loom-Build: unknown b591c8cf436f0d4aa5870a9bc7cd5f7194e0e778 dirty
    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
2026-10-07 chore: resync installed Loom surfaces
    <!-- loom:provenance v1 build=unknown b551219fd5b8347113c0cbc79ea416e81c39fa9d clean prompts=none sweep=none story=none trace=5ac7c8c62dad54841e21dd94f0920de3 host=loom-worker-2 base=aed73c93941a80e4aec77152fef82d9e9049ffdc run=loom-run/v1:timer:loom-worker-2/fleet-resync:d10fb10789e94930ab1af368c15a8f8b installs=0.19.864 128a7eba2bb5f7bcf8891ba284b14cb7ebf8dd3d -->
    Loom-Trace-Id: 5ac7c8c62dad54841e21dd94f0920de3
    Loom-Build: unknown b551219fd5b8347113c0cbc79ea416e81c39fa9d clean
    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
2026-10-07 chore: resync installed Loom surfaces
    <!-- loom:provenance v1 build=unknown 90fbd167e4e376894396e651676cf58fc9aa223a clean prompts=none sweep=none story=none trace=196876656e912171b28029ceca9f772d host=loom-worker-1 base=f8480d4ee3db3fabf89d8ffbefecc3c132273f22 run=loom-run/v1:timer:loom-worker-1/fleet-resync:7b46720ff3a84a8184f2f2b3bc039260 installs=0.19.868 ee904e1c151bc9cf15b0eb55dfe9d57ad6136cff -->
    Loom-Trace-Id: 196876656e912171b28029ceca9f772d
    Loom-Build: unknown 90fbd167e4e376894396e651676cf58fc9aa223a clean
    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
2026-10-08 chore: resync installed Loom surfaces
    <!-- loom:provenance v1 build=unknown 5a3df331a0612dee585ef905015af01d08e3467f clean prompts=none sweep=none story=none trace=5690fa95febe608e500a46dde8a6ee92 host=loom-worker-2 base=8462ac774e1496f62915292f1ffdef5a9ea29bbc run=loom-run/v1:timer:loom-worker-2/fleet-resync:5c9c35d59b704bff9d8bf096ee7ba7be installs=0.19.876 b16d54e63fbbec4d7f15f13c1f43a5e5b38145ce -->
    Loom-Trace-Id: 5690fa95febe608e500a46dde8a6ee92
    Loom-Build: unknown 5a3df331a0612dee585ef905015af01d08e3467f clean
    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
2026-10-08 chore: resync installed Loom surfaces
    <!-- loom:provenance v1 build=unknown 134eb3ff06c1a86f49a911c6c17464f55e719736 clean prompts=none sweep=none story=none trace=c7df110d490314040dcd1347b2481843 host=loom-worker-1 base=7d97cbd3128dee9d8e666d9b88f173c03b84d60c run=loom-run/v1:timer:loom-worker-1/fleet-resync:53d0cec2cd61484eb9a0f8fb1f24ac5e installs=0.19.879 c15619905bdd8a24506c3853f45490d26e8f1cad -->
    Loom-Trace-Id: c7df110d490314040dcd1347b2481843
    Loom-Build: unknown 134eb3ff06c1a86f49a911c6c17464f55e719736 clean
    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
2026-10-08 chore: resync installed Loom surfaces
    <!-- loom:provenance v1 build=unknown 8f86de23319d8f6cf049557dcc9cf2e321211d9d clean prompts=none sweep=none story=none trace=17de45f778fbfd714af8afad02c96375 host=loom-worker-3 base=696b8b4967dee05db8923358d197968faae4c952 run=loom-run/v1:timer:loom-worker-3/fleet-resync:9e3e5d4a08824de3b7bc02940be2a0da installs=0.19.882 c9f85af3d967986cdd7a3f27e088a16f88712b05 -->
    Loom-Trace-Id: 17de45f778fbfd714af8afad02c96375
    Loom-Build: unknown 8f86de23319d8f6cf049557dcc9cf2e321211d9d clean
    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
2026-10-08 chore: resync installed Loom surfaces
    <!-- loom:provenance v1 build=unknown 4a5fb2b6276e17ff26ee1382acfe2ea7360ebea5 clean prompts=none sweep=none story=none trace=67857e1b7189785825a2dfc70921cf85 host=loom-worker-2 base=174473408448ac1e14892633db8cf7df922a37c2 run=loom-run/v1:timer:loom-worker-2/fleet-resync:dd6a5f3dceff4d8d8602a07a1dc89c95 installs=0.19.892 ce93e8a919d79a6f027bab268846a52084f9d94e -->
    Loom-Trace-Id: 67857e1b7189785825a2dfc70921cf85
    Loom-Build: unknown 4a5fb2b6276e17ff26ee1382acfe2ea7360ebea5 clean
    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
2026-10-08 chore: resync installed Loom surfaces
    <!-- loom:provenance v1 build=unknown b591c8cf436f0d4aa5870a9bc7cd5f7194e0e778 dirty prompts=none sweep=none story=none trace=28e7ca5fdb768489aa38bf002407d5a5 host=robb-pro base=3f604fee67a95df5780b8abcee51debe0e9dcdda run=loom-run/v1:timer:robb-pro/fleet-resync:eb5f838e-a774-4e20-8102-c37ee3ff31ca installs=0.19.895 9b30d293bcba1e79d49cabfc1c5bb5b6f4c0dc77 -->
    Loom-Trace-Id: 28e7ca5fdb768489aa38bf002407d5a5
    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
2026-10-08 chore: resync installed Loom surfaces
    <!-- loom:provenance v1 build=unknown 5684fc8c8ac418d95ad66a002d001eaea1283c9a clean prompts=none sweep=none story=none trace=c864acd3b9a5dbb419fddd8bd2a6283b host=loom-worker-3 base=c0ca96e55ef766650be628e52709ef5d53908de7 run=loom-run/v1:timer:loom-worker-3/fleet-resync:4771e7c630c34445b7f28539669d76e3 installs=0.19.898 3d55b9a1669c132d130d98f10a292c1325322c30 -->
    Loom-Trace-Id: c864acd3b9a5dbb419fddd8bd2a6283b
    Loom-Build: unknown 5684fc8c8ac418d95ad66a002d001eaea1283c9a clean
    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
2026-10-08 chore: resync installed Loom surfaces
    <!-- loom:provenance v1 build=unknown 04a1189116c7320def7d9ce357d2d9268405ae92 clean prompts=none sweep=none story=none trace=8e55b27fc60ffb045554bd413ad8f3c8 host=robb-pro base=8fa850d170621184beaf8a7a5d9cea6397eb8f7d run=loom-run/v1:timer:robb-pro/fleet-resync:83b69005-7c5b-44b3-96f8-33f07bf82f4b installs=0.19.917 d3c1ea3a4c81e01ce5487dc3e4bbdd86534e677e -->
    Loom-Trace-Id: 8e55b27fc60ffb045554bd413ad8f3c8
    Loom-Build: unknown 04a1189116c7320def7d9ce357d2d9268405ae92 clean
    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
2026-10-08 signoff: cite T1 item 4 (LVS clean) for both partitions from record 20261003-183059-dc5644a
    Bump grader pin to e6284fbe62e2 (first commit with manifest pointer support,
    klayout-tools#2376); add all-analog-block LVS coverage gate + CI step; regenerate
    tier report (5 of 22 met).
    Loom-Story: 2AMLogic/sg13g2-pll#146
    Loom-Trace-Id: 1eab5b0c0d4804b8b1a7fbb46b7159e2
    Loom-Build: 0.19.868 ee904e1c151bc9cf15b0eb55dfe9d57ad6136cff clean
2026-10-08 chore: resync installed Loom surfaces
    <!-- loom:provenance v1 build=unknown d2a55ce217b3ad1793611a2c54946676bb55b512 clean prompts=none sweep=none story=none trace=459637e4e8503593bdf58360865a7524 host=robb-pro base=3ec3e2b73b90417ea3dbccc885bc19819cf0caff run=loom-run/v1:timer:robb-pro/fleet-resync:95b3cf92-9cd9-4c36-8bbd-bdcace7c3874 installs=0.19.935 d347079cd0bad2db2c11ee4f0b760f04b2601d21 -->
    Loom-Trace-Id: 459637e4e8503593bdf58360865a7524
    Loom-Build: unknown d2a55ce217b3ad1793611a2c54946676bb55b512 clean
    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
2026-10-08 signoff: cite T1 items 1 and 2 and gate netlist regeneration in CI
    Adds 1.*/2.* manifest citations pinned to the 20261003-183059-dc5644a GDS
    revisions, extends the coverage gate to extract envelopes, adds a netlist
    regeneration workflow, regenerates the tier report (9/22 met), and documents
    divider_chain as the full-custom sub-case. Tool gap: klayout-tools#2887.
    Loom-Story: 2AMLogic/sg13g2-pll#151
    Loom-Trace-Id: 978abdd45318304a91c21e49815bafe1
    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
2026-10-08 ci(netlists): point PDK_ROOT at the IHP-Open-PDK clone root; also fail on untracked generated netlists
    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
2026-10-08 ci(netlists): pin IHP-Open-PDK before mm_ok, link sibling ihp-sg13g2 for cmos5l, check only untracked
    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
2026-10-08 docs: netlist gate observed green on runner; PDK now pinned
    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
2026-10-08 ci: run layout generator unit tests in a layout-tests job (#153)
    Loom-Story: 2AMLogic/sg13g2-pll#153
    Loom-Trace-Id: 7017e4fbe3d7813ab73d3cb996cbde41
    Loom-Build: 0.19.898 3d55b9a1669c132d130d98f10a292c1325322c30 clean
2026-10-08 signoff: audit PEX body-bias binding and cite T1 item 7 (post-layout) per block (#152)
    Adds klt pex envelopes for pfd, cp, loop_filter, vco, divider_chain; cites
    vco (7.analog) and divider_chain (7.digital); withholds lock_detector (#157).
    Loom-Story: 2AMLogic/sg13g2-pll#152
    Loom-Trace-Id: f6771902c3067c00f4eb0a75486032e6
    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
2026-10-08 signoff: klt erc supply specs/reports for the five analog blocks; cite T1 item 11.analog (#147)
    - Five per-block supply specs (layout/sg13cmos5l-pll/erc-supply-spec.pll_<block>.json):
    DR-004 rails as kind=supply, a checked drawn-NWell tie (Cont&nSD&Activ) and a
    well_boxes substrate tie (Cont&pSD&Activ, one box per nfet group) on every MOS
    block; loop_filter (passive) discloses its ties as unexpressible.
    - ERC-only record reports/20261008-230856-cd95c87: five reports at the grading
    pin (klt 0.6.0+ge6284fbe62e2), all erc_status clean, zero findings, plus the
    loop_filter gate-less error envelope (klayout-tools#2896).
    - manifests: 11.analog = [erc lock_detector, lvs lock_detector /resp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
2026-10-08 signoff: gate the ERC run form; correct loop_filter spec comment (#147)
    Judge feedback on PR #162:
    - check_erc_coverage.py now verifies how each report was run, from
    provenance: the four MOS blocks must carry deck sg13cmos5l at the pinned
    content hash, and vco (rppd, rhigh) / lock_detector (rhigh) must list those
    bodies as carved out with non-zero area; loop_filter must carry deck null,
    no carved devices, and no gates[].net containing a declared supply (VSS).
    - gds_layers() raises on a malformed or truncated stream (bad record length,
    record past EOF, no ENDLIB); the gate turns that into a failure instead of
    reading a layer as absent.
    - Negative tests: MOS blocks re-run without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
2026-10-08 docs: refresh README status to match landed design, layout and evidence (#160)
    Loom-Story: 2AMLogic/sg13g2-pll#160
    Loom-Trace-Id: b7ea9900b3de52861e263506b3442f27
    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
2026-10-08 sim: RECORD-006 -- isolate cp dump-node charge sharing as the 8.2% static phase error (#150)
    Nominal-corner diagnostic on RECORD-005's proposal deck (frozen
    cp_cascbias + pfd snapshots, behavioural /64, R1 x20, ideal caps).
    New runner/templates generate per-variant cp/pfd derivatives (committed
    as diffs) and an open-loop charge-per-pulse bench; all outputs are new
    files under corners/.
    - control reproduces RECORD-005 (8.204% vs 8.203%, 4-cycle run, no lock);
    repeats byte-identical
    - cp_dumpbuf holds VDUMP ~0.94 V below VOUT; each UP/DN turn-on pulls
    ~20-23 fC from the filter (-41.3 fC/pair, same sign) -> predicts 8.22%
    - ideal VDUMP=VOUT: 1.048%, 45-cycle dual lock, lock time 250 ns
    - i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
    [cpdiag_cycles_control_probe.csv, cpdiag_cycles_ideal_dump.csv, cpdiag_cycles_ideal_dump_ofs.csv, cpdiag_cycles_ideal_dump_rep.csv, cpdiag_cycles_ideal_sw.csv, cpdiag_cycles_reset_narrow.csv, cpdiag_cycles_reset_wide.csv, cppulse_events_control_probe.csv]
2026-10-09 sim: nominal closed-loop bench with repaired divider_chain; loop does not acquire (#159)
    Loom-Story: 2AMLogic/sg13g2-pll#159
    Loom-Trace-Id: 24474872e9868aa976ca7be41017fd12
    Loom-Build: 0.19.929 e0381fd31734743649019281f22b12223f853f41 clean
    [trace_control.csv, trace_real.csv, vctrl_control.csv, vctrl_real.csv]
2026-10-09 sim: persist divider-speed edge counts, index real-divider bench, fix extract window end (#168)
    Loom-Story: 2AMLogic/sg13g2-pll#168
    Loom-Trace-Id: 95c1a72d4e2cbefe0814d51105f6d484
    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
2026-10-09 signoff: gate sibling PEX reports and flattened schematic leg provenance (#170)
    Loom-Story: 2AMLogic/sg13g2-pll#170
    Loom-Trace-Id: e6972d3149a7e7bd1edfdab9473cc5ab
    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
2026-10-09 characterization: generated, CI-checked summary of committed sim evidence; document item 8 decision (#171)
    Loom-Story: 2AMLogic/sg13g2-pll#171
    Loom-Trace-Id: 9f729bf043b6f953d616be64bb580893
    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
2026-10-09 signoff: DRC sibling coverage gate for all six composed PLL blocks (#169)
    Loom-Story: 2AMLogic/sg13g2-pll#169
    Loom-Trace-Id: fd9595f408e079a321e7d5f540138a68
    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
2026-10-09 chore: resync installed Loom surfaces
    <!-- loom:provenance v1 build=unknown 05dba463c5b293d38f0ca071725983862498b3f3 clean prompts=none sweep=none story=none trace=14298316053024bcf5120bff695771ab host=robb-pro base=c1cbe7084db68e412f080e4cedbc4baab50d032d run=loom-run/v1:timer:robb-pro/fleet-resync:2f384483-6d77-4ba2-9888-aa1e4b5be36c installs=0.19.953 b93d7a955d63411cb4c94b986fd5138d27dedb0f -->
    Loom-Trace-Id: 14298316053024bcf5120bff695771ab
    Loom-Build: unknown 05dba463c5b293d38f0ca071725983862498b3f3 clean
    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
2026-10-09 spec: draft target-spec.md from the porting plan and DR-005 to DR-008
    Closes #148
    Loom-Story: 2AMLogic/sg13g2-pll#148
    Loom-Trace-Id: 940007f294b3e98214a95a76f1b32fd9
    Loom-Build: 0.19.950 72047016af9d66c08f900bb94c642a66dfd75fc5 clean
2026-10-09 ci: validate sim evidence records and enforce append-only (#180)
    Adds characterization/check_records.py (numbering, derived format rules,
    sources.json coverage, append-only vs base ref), its unit tests with
    deleted/edited/renamed negative fixtures, a grandfather baseline for 19
    pre-existing unlisted records and one duplicate number, and a records job
    in signoff.yml.
    Loom-Story: 2AMLogic/sg13g2-pll#180
    Loom-Trace-Id: f00ea2f93d69c26429288431346b6d47
    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
2026-10-09 signoff: add item-9 testbench coverage and PDK-pin gate (#179)
    Adds manifests/check_testbench_coverage.py with unit tests, a sim/README.md
    Cold start section (bench index, install steps, PDK pins), and a CI step.
    No record cites a PDK commit, so 37 pre-gate records are grandfathered
    (follow-up #182) and item 9 stays unmet; the manifest and tier report are
    unchanged on purpose.
    Loom-Story: 2AMLogic/sg13g2-pll#179
    Loom-Trace-Id: 34755484574dfa2429a09d0e4f92dfd8
    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
2026-10-09 sim: add cp up/dn mismatch Monte Carlo bench (controls only; campaign blocked, Part of #178)
    Adds sim/sg13cmos5l-cp-icp-trim-mc: testbench, klt sim requests (seed 178,
    N=100 x 15 corners), deterministic negative control (stddev exactly 0),
    positive probe, README cold-start, RECORD-001. Confirms sg13_hv_nmos/pmos
    carry mismatch under ngspice. The batch campaign and klt yield could not run
    on this fleet (runner klt 0.5.0 drops osdi_preload; klt_yield_native missing),
    so no yield claim is made and the tier report is untouched.
    Loom-Story: 2AMLogic/sg13g2-pll#178
    Loom-Trace-Id: ec34569608d270b61f3fd72a056889e6
    Loom-Build: 0.19.950 720470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
2026-10-09 sim: list cp MC RECORD-001 in sources, index the bench, cite PDK revision (Part of #178)
    - characterization/sources.json: add gap cp-mismatch-mc citing
    sim/sg13cmos5l-cp-icp-trim-mc RECORD-001 (no dataset: no yield estimate
    exists yet); SUMMARY.md regenerated.
    - sim/README.md: add sg13cmos5l-cp-icp-trim-mc to the bench index;
    testbench/gen_requests.py made executable as its entry point.
    - RECORD-001 (new in this PR): cite ihp-sg13cmos5l commit
    607e18d4bd9214a52575c194b4181ef449f9252f, the worker's clean checkout
    and the sim/README.md PDK-PIN.
    Loom-Trace-Id: ec34569608d270b61f3fd72a056889e6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
2026-10-09 sim: npn13G2 r_o/matching characterization vs cp CMOS cascode, klt bipolar extract/LVS probe, DR-009 (Closes #181)
    Loom-Story: 2AMLogic/sg13g2-pll#181
    Loom-Trace-Id: 98b7711c145162f2d89ab8006f6d6cc5
    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
    [cmos_ro_nominal.csv, hbt_mm_samples.csv, hbt_mm_summary.csv, hbt_ro.csv]
2026-10-09 sim: register hbt RECORD-001 in sources, index the bench, cite PDK revision (Part of #181)
    - characterization/sources.json: add dataset g2-npn13g2-ro-matching (hbt_ro,
    hbt_mm_summary, cmos_ro_nominal), notes stating the CMOS leg is mos_tt/27 C
    only; SUMMARY.md regenerated. records_baseline.json unchanged.
    - sim/README.md: add sg13g2-hbt-characterization to the Cold start bench index.
    - RECORD-001: cite IHP-Open-PDK commit 5cccb161f749 (tag v0.3.0). Basis: the
    installed tree's .fetched-version is 0.3.0 and the six model files used have
    git blob hashes identical to the tag; the hbt_ro / cmos_ro_nominal report
    models_lib_sha256 values match the local corner libs. hbt_mm fleet-side
    t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
2026-10-09 chore: resync installed Loom surfaces
    <!-- loom:provenance v1 build=unknown 7f06b288b150f2fe0a4b24c331a9b3ec093d709d clean prompts=none sweep=none story=none trace=a90c217ff3a3bd9e3a30282b8cadc24d host=robb-pro base=a3fc48ea5447f8c7d04eb6badef9674287746aa4 run=loom-run/v1:timer:robb-pro/fleet-resync:6e5ec9f3-d6ef-4953-80f7-c93035e2d359 installs=0.19.966 9bed656320e53ba6c64305daa60613431a7ed02d -->
    Loom-Trace-Id: a90c217ff3a3bd9e3a30282b8cadc24d
    Loom-Build: unknown 7f06b288b150f2fe0a4b24c331a9b3ec093d709d clean
    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
2026-10-09 manifests: spec row-table citation gate (benches, records, R-n, DR-NNN) (Closes #186)
    Loom-Story: 2AMLogic/sg13g2-pll#186
    Loom-Trace-Id: 3507b521c740dc9deae9e9889df26548
    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
2026-10-09 cp: VDUMP tracks VOUT -- cp_dumpbuf becomes a complementary unity-gain 5T OTA pair (#165)
    Replaces the NMOS source follower (VDUMP ~0.94 V below VOUT, the
    dump-node charge-sharing term RECORD-006 isolated) with the gf180-pll
    cp_dumpbuf topology re-sized to this cp's IBN/IBP mirror nodes.
    cp_dumpbuf gains an IBP pin; netlist re-exported. Adds the single-unit
    closed-loop runner for the new snapshot.
    Loom-Story: 2AMLogic/sg13g2-pll#165
    Loom-Trace-Id: 81a34ca17c34faee5ece293f5e1ea539
    Loom-Build: 0.19.972 113c7f31d7d16f75d30c470023e0b65b29b1fe94 clean
    [cp.sch, cp_dumpbuf.sch]
2026-10-09 cp_dumpbuf: shrink input pairs to bound VOUT loading (<=1% of C1) (#165)
    The gf180-pll input-pair sizing (16u/48u) adds 28-112 fF to the loop-
    filter node, up to 6.6% of this loop's 1.69 pF C1. 2u/1u NMOS and
    6u/0.5u PMOS inputs measure 3.7-10.5 fF over VOUT 0.3-2.9 V at nominal,
    inside the DR-001 / gf180 DR-005 loading condition.
    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
    [cp_dumpbuf.sch]
2026-10-09 chore: resync installed Loom surfaces
    <!-- loom:provenance v1 build=unknown 30c7a7ee2f74a6a2b5bb0f19fd9f049ec8ae8b5c clean prompts=none sweep=none story=none trace=7bc5ba399ff199d049d83d711920a157 host=robb-pro base=579dbd56c32269577277b32c798cd17aa3dab7e2 run=loom-run/v1:timer:robb-pro/fleet-resync:8e237160-c4d0-4ce3-85ac-c96aff5cf221 installs=0.19.982 2bc4cba624b9053535663441e6f0daf08a7acf2e -->
    Loom-Trace-Id: 7bc5ba399ff199d049d83d711920a157
    Loom-Build: unknown 30c7a7ee2f74a6a2b5bb0f19fd9f049ec8ae8b5c clean
    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
2026-10-09 cp_dumpbuf tracking buffer: DR-010, nominal DC + closed-loop evidence, cp PEX stale-pending (#165)
    Adds DR-010 (complementary unity-gain 5T-OTA pair, rejected alternatives,
    VOUT range 0.3-2.7 V), cp-icp-trim RECORD-005 (|VDUMP-VOUT|, loading,
    stability, Icp trim re-run; nominal only, batch grids failed on runner
    version mismatch), closed-loop RECORD-007 (row 7 static phase 0.779% at
    mos_tt/27C/3.3V on the proposal deck), frozen cp_otabuf snapshots and
    request JSONs. check_pex_coverage.py gains an explicit STALE_PENDING entry
    for cp (#195): the exported cp.spice changed, so its pre-#165 PEX leg
    would otherwise fail the freshness gate.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
    [cpdiag_cycles_otabuf.csv, cpdiag_cycles_otabuf_rep.csv, lock_trace_cpdiag_otabuf.csv, lock_trace_cpdiag_otabuf_rep.csv]
2026-10-09 characterization: cite cp-icp-trim RECORD-005 and closed-loop RECORD-007 (#165)
    Fixes the failing `records` check: both new records are now listed in
    characterization/sources.json as nominal-only datasets (mos_tt/27 C/3.3 V),
    with a new gap entry stating that the |VDUMP-VOUT| offset, the cp-icp-trim
    re-run and row 7 are not established across PVT and that cp layout evidence
    is stale until #195. records_baseline.json is untouched.
    gen_summary.read_rows now accepts an integer rows_path step so klt sim
    reports (corners.0.measurements) can be cited directly; unit test added.
    SUMMARY.md regenerated.
    The signoff README now also states that the pll_cp LVS/ERC/DRC evidence
    describes the pre-#165 b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
2026-10-10 chore: resync installed Loom surfaces
    <!-- loom:provenance v1 build=unknown 03c1cb521a10d5101bd8aa2c52a47cebfb0e795b clean prompts=none sweep=none story=none trace=09ccab293fce5c1a7b4aa907c7197bec host=robb-studio base=734c3a6289041a7f2e1a7eccaa32c734531c5ca6 run=loom-run/v1:timer:robb-studio/fleet-resync:ed2be6c5-20fe-4228-a206-940d35a4858f installs=0.19.996 0d2be7e9ae05753e2c9232a83b7399d45de5396e -->
    Loom-Trace-Id: 09ccab293fce5c1a7b4aa907c7197bec
    Loom-Build: unknown 03c1cb521a10d5101bd8aa2c52a47cebfb0e795b clean
    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
2026-10-10 chore: resync installed Loom surfaces
    <!-- loom:provenance v1 build=unknown a7d2b01d8eb7d09e597a4638e5cb3cdd8bab9156 clean prompts=none sweep=none story=none trace=35c1337ee84607e87ba2038523d63198 host=robb-pro base=734c3a6289041a7f2e1a7eccaa32c734531c5ca6 run=loom-run/v1:timer:robb-pro/fleet-resync:6bf32a81-6c4a-48c5-a51e-1ad65c6bedfd installs=0.19.1001 1c1131220b2f5950fe54b7cd02ebd3f1aae488dd -->
    Loom-Trace-Id: 35c1337ee84607e87ba2038523d63198
    Loom-Build: unknown a7d2b01d8eb7d09e597a4638e5cb3cdd8bab9156 clean
    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
2026-10-10 chore(characterization): burn down 5 grandfathered unlisted records (#185)
    Cite five historical records as extra_records with hash pins; baseline 19 -> 14.
    Loom-Story: 2AMLogic/sg13g2-pll#185
    Loom-Trace-Id: ac3ce9ef66e278f37cda55b198b94924
    Loom-Build: 0.19.996 0d2be7e9ae05753e2c9232a83b7399d45de5396e clean
2026-10-10 loop-bandwidth-pm: real idle cp on VCTRL in the PM bench; re-check DR-007/DR-008 tuples (#196)
    New append-only RECORD-005 plus generated klt sim benches:
    - tb_cp_cout_issue196.sp: total idle cp VOUT capacitance (real cp vs no cp,
    3.75/10/11 uA, plus buffer-less baseline; buffer-only part reproduces
    cp-icp-trim RECORD-005 exactly). typ: 9.7-16.6 fF at 11 uA.
    - tb_loop_ac_ccp_issue196.sp: RECORD-003/004 loops with the real idle cp on
    VCTRL over 0.3-2.9 V, with C_cp=0 anchor and bias-only control.
    - typ DR-008 tuple: 49.043 -> 48.231 deg worst case, still passes.
    - fast/slow grid submitted to batch, refused (runner klt 0.5.0, klt#2851);
    DR-008 fast projected below 45 deg, filed as #203.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
    [cout_issue196.csv, results_resized_issue196_ccp.csv]
2026-10-10 characterization: cite loop-bandwidth-pm RECORD-005 (#196)
    Fixes the failing `records` check: RECORD-005 (real idle cp on VCTRL in
    the PM bench) is now listed in characterization/sources.json as a
    nominal-only, schematic-only dataset citing corners/cout_issue196.csv and
    corners/results_resized_issue196_ccp.csv. The post-cp PM/f_c metrics are
    filtered to status=ran, so only the measured typ tuple is shown.
    A new gap entry records that the fast/slow grid is blocked on the batch
    fleet (klayout-tools#2851, #2727) and that the DR-008 fast projected flip
    is an estimate tracked in #203. SUMMARY.md regenerated. No record, DR or
    spec file is touched.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
2026-10-10 layout: fresh SG13CMOS5L record for the DR-010 cp dump buffer -- cp 28/28 LVS match (#195)
    Re-ran layout/bin/run-pll-cmos5l-layout-flow.sh unmodified on a clean
    tree at a4ca1b8 (klt 0.6.0+gdaf06a51afaf, KLayout 0.30.12, the pin in
    layout/requirements.txt). pll_cp now draws the 10-device cp_dumpbuf
    (two 5T OTAs): 28/28 devices, 22/22 nets, LVS match, block DRC clean.
    MP1/MP2's bulk extracts on XBUF_PSRC in their own NWell.
    Every non-cp GDS is byte-identical to record 20261003-183059-dc5644a;
    that record is left untouched. LATEST now names this record.
    Loom-Story: 2AMLogic/sg13g2-pll#195
    Loom-Trace-Id: 1b1ff277802117cb9495762e89625413
    L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
2026-10-10 pex: re-flatten the DR-010 cp leg and re-run all five klt pex envelopes on the new record (#195)
    run-klt-pex.sh now binds to the manifest's 4.analog record (the gate's own
    derivation) instead of a hardcoded directory, and takes KLT. The cp leg is
    re-flattened by the unchanged flattener, leg-provenance.json re-pinned, and
    STALE_PENDING emptied (mechanism kept, negative tests inject an entry).
    All five envelopes re-run at klt 0.6.0+g1eb3e4bfd0f5 with ngspice-46: the
    four unchanged blocks reproduce RECORD-001 exactly (only layout.path
    differs); cp is +0.141 % / -0.039 %. RECORD-002 states that this DC bench
    does not observe VDUMP tracking. The host ngspice-42 cannot load the PDK's
    OSDI v0.4 mo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
2026-10-10 manifest: re-pin item 1/2/4/11 citations to the #195 records; regrade (#195)
    Cited GDS hashes are unchanged (lock_detector, divider_chain byte-identical);
    the regenerated tier report differs from the old one only in citation paths
    (12/22 met, grader e6284fbe62e2, dirty: false).
    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
2026-10-10 characterization: cite klt-pex RECORD-002 and the re-run envelopes; retire 'layout stale' (#195)
    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
2026-10-10 chore: resync installed Loom surfaces
    <!-- loom:provenance v1 build=unknown c156f673e072832aaacb4cd1ec65b742e7f45867 clean prompts=none sweep=none story=none trace=9de99c124c651049199abe9a75070dc7 host=robb-pro base=ff10112073a4aeff508a1b48ad6d159d4657c38c run=loom-run/v1:timer:robb-pro/fleet-resync:f790885c-7154-4b3d-acd9-71fd537cd20b installs=0.19.1010 d1d5fcecb79550fe39658555a4419f98cec060fb -->
    Loom-Trace-Id: 9de99c124c651049199abe9a75070dc7
    Loom-Build: unknown c156f673e072832aaacb4cd1ec65b742e7f45867 clean
    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
2026-10-10 chore: resync installed Loom surfaces
    <!-- loom:provenance v1 build=unknown 52f79668bb5f93c1828b7f1ea4f7013b917b847b clean prompts=none sweep=none story=none trace=7057f3175071f1f6e34b354fab40a0ce host=robb-studio base=8ffc7fc79ae669fd63c459655960c3d8ec42a881 run=loom-run/v1:timer:robb-studio/fleet-resync:d8918779-1625-4202-b151-71f64465e8cd installs=0.19.1010 d1d5fcecb79550fe39658555a4419f98cec060fb -->
    Loom-Trace-Id: 7057f3175071f1f6e34b354fab40a0ce
    Loom-Build: unknown 52f79668bb5f93c1828b7f1ea4f7013b917b847b clean
    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
2026-10-10 feat(gate): validate append-only provenance addenda and superseding reruns (#198)
    Loom-Story: 2AMLogic/sg13g2-pll#198
    Loom-Trace-Id: a99648af088b1c0da596b6ddd6e140e8
    Loom-Build: 0.19.1009 8889f7bd1eccfb4bc8239e7f5669b65f9815c30e clean
2026-10-10 chore: resync installed Loom surfaces
    <!-- loom:provenance v1 build=unknown 525fe43b7b1b2a0271084bba444c934a1541a8d8 clean prompts=none sweep=none story=none trace=0d4424bd058cf912b74934ec0e7bf37e host=robb-pro base=923965860431fdcff15ee0e25517374a058364cf run=loom-run/v1:timer:robb-pro/fleet-resync:4812047c-8b9b-4da2-a5dc-13e6f6420a04 installs=0.19.1018 13e54f1cfc513507a7ef84ec6908085638d9c187 -->
    Loom-Trace-Id: 0d4424bd058cf912b74934ec0e7bf37e
    Loom-Build: unknown 525fe43b7b1b2a0271084bba444c934a1541a8d8 clean
    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
2026-10-10 chore: resync installed Loom surfaces
    <!-- loom:provenance v1 build=unknown 525fe43b7b1b2a0271084bba444c934a1541a8d8 clean prompts=none sweep=none story=none trace=d4059def94f46d8d158946acddd4d602 host=robb-studio base=5a583a91ba3123b3d5968e5e1eb6e6ec928eff41 run=loom-run/v1:timer:robb-studio/fleet-resync:4a4d1995-968e-44c5-b5fe-804b4d477795 installs=0.19.1019 febfc4335d0554865fadbecba718245cd88c6678 -->
    Loom-Trace-Id: d4059def94f46d8d158946acddd4d602
    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
2026-10-10 sim: inventory 37 grandfathered records and pin ihp-sg13g2 (Closes #210)
    - sim/provenance-migration.md: per-record inventory of all 37 _GRANDFATHERED
    records: bench, scope, PDK tree(s) actually read, contemporaneous host
    evidence, evidence consumers, recovered/superseded disposition, and
    execution batch (#211-#217) with decomposition/blocker flags.
    - Finding: ihp-sg13cmos5l tracks its MOS/RES model cards and the
    psp103/psp103_nqs/mosvar/r3_cmc OSDI paths as git symlinks into
    ihp-sg13g2, so all 34 SG13CMOS5L records are mixed-PDK. The
    schmitt_rewire.csv ihp-sg13g2 arm (54 of 108 rows) is called out
    explicitly.
    - sim/README.md: PDK-PIN ihp-sg13g2 5cccb161f7492697cfa52eb14dc03beb0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
2026-10-10 chore: resync installed Loom surfaces
    <!-- loom:provenance v1 build=unknown 5d5f41d89eef35adf478b92b96af06c6d86d27a6 clean prompts=none sweep=none story=none trace=05d2a40831b35ba1c48afada00c29519 host=robb-pro base=1323784bde7057f4508a2baa9a8c4bc0f82f2cd0 run=loom-run/v1:timer:robb-pro/fleet-resync:c58bb82e-a213-439d-b829-04234e141de9 installs=0.19.1028 48ce8a23fdab3059d078e9fffca79e4d4c911d60 -->
    Loom-Trace-Id: 05d2a40831b35ba1c48afada00c29519
    Loom-Build: unknown 5d5f41d89eef35adf478b92b96af06c6d86d27a6 clean
    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
2026-10-10 chore: resync installed Loom surfaces
    <!-- loom:provenance v1 build=unknown aa536103d6239818bb974a51d2f7f268eff38bad clean prompts=none sweep=none story=none trace=126a1328a3664e2119a0978086db9bea host=robb-studio base=58c5ab95308c695416d02107f9775ea87fb4343d run=loom-run/v1:timer:robb-studio/fleet-resync:fbc4e361-e290-4d81-ae3a-8b5fde796815 installs=0.19.1032 13ca937a7d6ba8768c296b0c126f2ce48f5f7ca4 -->
    Loom-Trace-Id: 126a1328a3664e2119a0978086db9bea
    Loom-Build: unknown aa536103d6239818bb974a51d2f7f268eff38bad clean
    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
2026-10-11 chore: resync installed Loom surfaces
    <!-- loom:provenance v1 build=unknown cf08873555e2eb95da295dcbee98b0dc34473381 clean prompts=none sweep=none story=none trace=67fbc483c3ca3e442d7928804c11ff06 host=robb-pro base=602e7042c06d36f4d0e27e517f3a7910b93036c1 run=loom-run/v1:timer:robb-pro/fleet-resync:e3f97888-2b26-404a-bd47-86fd28a4eced installs=0.19.1041 b65c266b47d796bf37d1c04c6f616be0bc699056 -->
    Loom-Trace-Id: 67fbc483c3ca3e442d7928804c11ff06
    Loom-Build: unknown cf08873555e2eb95da295dcbee98b0dc34473381 clean
    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
2026-10-11 chore: resync installed Loom surfaces
    <!-- loom:provenance v1 build=unknown e91831edf7b55b29d3a2d88e266916fab9ce2563 clean prompts=none sweep=none story=none trace=f72dd67520a2c3802aa0495b80ac65a5 host=robb-studio base=a76471524593b6efc5a4415c55a988d708158c87 run=loom-run/v1:timer:robb-studio/fleet-resync:91d2434e-eae5-45de-9305-d78c43fc7c7a installs=0.19.1042 5b6ebdcc40bfccc9357e15196984061f1d5e6178 -->
    Loom-Trace-Id: f72dd67520a2c3802aa0495b80ac65a5
    Loom-Build: unknown e91831edf7b55b29d3a2d88e266916fab9ce2563 clean
    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
2026-10-11 chore: resync installed Loom surfaces
    <!-- loom:provenance v1 build=unknown 5ec729b9f7dd55a2082752611e4c4964f49661fb clean prompts=none sweep=none story=none trace=efc2abc8b72538df6d1a6ea9d329603d host=robb-pro base=b74debbcb80fd32af6f7a62397c38ddb614116d6 run=loom-run/v1:timer:robb-pro/fleet-resync:0d396c06-f26e-423e-97ac-6d3ac04a8e51 installs=0.19.1054 f6a73bc7fc942d7b297514b2e3f57a0ca2076010 -->
    Loom-Trace-Id: efc2abc8b72538df6d1a6ea9d329603d
    Loom-Build: unknown 5ec729b9f7dd55a2082752611e4c4964f49661fb clean
    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
2026-10-11 chore: resync installed Loom surfaces
    <!-- loom:provenance v1 build=unknown 745f69d0daad6c23e76cc006720fa4fbeaa3d887 clean prompts=none sweep=none story=none trace=3baabc4a039fd85029fff227a6ae690a host=robb-studio base=0484a9c65b02fd907fbcbad38161c2058085781c run=loom-run/v1:timer:robb-studio/fleet-resync:3b3207d7-055d-49b5-a387-db375213668d installs=0.19.1060 3336676408ee1d4f1df2dc7f23adbb6c3170674e -->
    Loom-Trace-Id: 3baabc4a039fd85029fff227a6ae690a
    Loom-Build: unknown 745f69d0daad6c23e76cc006720fa4fbeaa3d887 clean
    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
2026-10-11 manifests: let records cite revisions for more than one PDK tree (Closes #221)
    Loom-Story: 2AMLogic/sg13g2-pll#221
    Loom-Trace-Id: e7e6079a07908eed517bdaf2da0e8f14
    Loom-Build: 0.19.1055 4737928b703aa8a4c87d04eefbf7299fb933eab4 clean
2026-10-11 sim: recover real-divider RECORD-001 provenance; RECORD-006 fails validation (Closes #224)
    Loom-Story: 2AMLogic/sg13g2-pll#224
    Loom-Trace-Id: 55e14bb2ddd9ada4ebac2272e5b7a9b7
    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
2026-10-11 fix: accept ADDENDUM-NNN files in check_records, address review nits
    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
2026-10-11 sim: rerun RECORD-002 PFD parity diagnostics on pinned dual-tree PDK; superseded addendum (Closes #226)
    Rebuilt the 65e2cb6 bench unmodified in a scratch checkout; as-drawn
    phase-blindness and the 400 ns patched-PFD trajectory reproduce, the
    patched REF-leads-FB duty does not (documented). RECORD-002 and all
    historical CSVs unchanged.
    Loom-Story: 2AMLogic/sg13g2-pll#226
    Loom-Trace-Id: 42829f30eaffe844065773b21f8af3b7
    Loom-Build: 0.19.1068 fcc4454e112d13e088464bb0a178b75c0dc96c0f clean
2026-10-11 sim: rerun RECORD-003 closed-loop decks on pinned dual-tree PDK; superseded addendum (Closes #227)
    Rebuilt the d633b9d bench unmodified in a scratch checkout; all four result
    CSVs reproduce byte-identically. RECORD-003 and historical CSVs unchanged.
    Loom-Story: 2AMLogic/sg13g2-pll#227
    Loom-Trace-Id: b9349609084f744a2bc96e031022d9e0
    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
2026-10-11 chore: resync installed Loom surfaces
    <!-- loom:provenance v1 build=unknown b37a005ac1889262fb9e5338f7cff4e9ed4987da clean prompts=none sweep=none story=none trace=25c158d7e9591610b251780caaff1c5f host=robb-pro base=a1b572e08b3f428ee6d0026859257fe84d5df976 run=loom-run/v1:timer:robb-pro/fleet-resync:7f020bca-6920-47f7-a5e4-bbd5c82d9bb8 installs=0.19.1072 29b48db1ead9c4501304e0114a5c33310e1d589f -->
    Loom-Trace-Id: 25c158d7e9591610b251780caaff1c5f
    Loom-Build: unknown b37a005ac1889262fb9e5338f7cff4e9ed4987da clean
    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
2026-10-11 sim: rerun RECORD-001 closed-loop decks on pinned dual-tree PDK; superseded addendum (Closes #225)
    Rebuilt the 1da08d7 bench unmodified in a scratch checkout. Outcome
    reproduces (Part A fb never toggles; Part B diverges, lock_time None) but
    results are not byte-identical (original: arm64 macOS ngspice-47). RECORD-001
    and historical CSVs unchanged.
    Loom-Story: 2AMLogic/sg13g2-pll#225
    Loom-Trace-Id: 64791ff529b7e69e055baa24a97c6327
    Loom-Build: 0.19.1071 dcab8265613676d08b763cddc911b93c7ab7d9d4 clean
2026-10-11 sim: ADDENDUM-003 states rerun agreement accurately (lock_detector ~2%)
    The addendum claimed every cited quantity reproduced within about 1
    percent, but RECORD-010's table has Part A lock_detector at -10.97 ->
    -11.183 uA (~1.9%). Reword to match RECORD-010: currents within 0.2
    percent except lock_detector (about 2 percent on Part A), voltages and
    delta_f/f_ref within about 1 percent, spur within 0.06 dB. RECORD-001
    and records_baseline.json untouched.
    Part of #225
    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
2026-10-11 sim: rerun RECORD-005 cascode-bias deck on pinned dual-tree PDK; superseded addendum (Closes #229)
    Rebuilt the f54b9ef bench unmodified in a scratch checkout and reran the
    single nominal Part B deck. The 49-row trace is byte-identical to the
    original (sha256 fda199af...). RECORD-005 and its historical CSV are
    unchanged. Nominal point only; no grid coverage implied.
    Loom-Story: 2AMLogic/sg13g2-pll#229
    Loom-Trace-Id: 45f6083a273de8854d962351bf12117c
    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
2026-10-11 sim: rerun RECORD-004 ideal-cp diagnostic on pinned dual-tree PDK; superseded addendum (Closes #228)
    Rebuilt the f38b0ee bench unmodified in a scratch checkout and rerun
    run_closed_loop_icp_eq_diag.sh at full duration (2.5 us, mos_tt/27 C/3.3 V)
    on the pinned dual-tree PDK (ihp-sg13cmos5l 607e18d4, ihp-sg13g2 5cccb161,
    ngspice-46 x86-64). Outcome reproduces exactly: static phase error
    collapses to noise (final-20-cycle mean -0.00044% vs -0.00235% original),
    41-cycle dual-lock run from 450 ns with zero drop-outs, lock_time 450 ns,
    i_cp = 0. Not byte-identical (original: arm64 macOS ngspice-47). RECORD-004
    and historical CSVs unchanged. Consumers updated only where the rerun
    measurably replace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
2026-10-11 chore: resync installed Loom surfaces
    <!-- loom:provenance v1 build=unknown 81a6b4499cb57b3620785bc1625c300da34f0735 clean prompts=none sweep=none story=none trace=d08bbd290651d7bcbda8b216c0dfbcdf host=robb-studio base=6f1bb00fd351fc2650d8a31f47bbc2e8bce82e99 run=loom-run/v1:timer:robb-studio/fleet-resync:71e05e3d-931c-46b4-b6d2-5f3f992c1e19 installs=0.19.1073 abb0872ba7d1d3f6f3a14f71f51a562e89308181 -->
    Loom-Trace-Id: d08bbd290651d7bcbda8b216c0dfbcdf
    Loom-Build: unknown 81a6b4499cb57b3620785bc1625c300da34f0735 clean
    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
2026-10-11 sim: partial rerun of RECORD-006 (control_probe, ideal_dump) on pinned dual-tree PDK; superseded addendum (Closes #239)
    Reran control_probe and ideal_dump (closed loop + open-loop pulse bench)
    of the historical cp_cascbias/pfd bench, unmodified, on ihp-sg13cmos5l
    607e18d4 + ihp-sg13g2 5cccb161 (ngspice-46, loom-worker-3). Open-loop
    charge identical to every printed digit (-41.302 / -8.099 fC); closed
    loop 8.2034% / 1.0478% with the same lock outcomes, traces not
    byte-identical (per-cycle diffs <= 0.030 pp). Remaining variants not
    rerun: batch submits refused by the fleet instance cap (verbatim in the
    record); no local fallback. RECORD-006 bytes unchanged.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
2026-10-12 chore: resync installed Loom surfaces
    <!-- loom:provenance v1 build=unknown ddfb67ccf9a5115d62dd86924613a468b9328f44 clean prompts=none sweep=none story=none trace=772605234b9d8cafd6a4049200f7425c host=robb-pro base=42e749bf1a8e8f526465b138984ade5335cb442c run=loom-run/v1:timer:robb-pro/fleet-resync:1ef28ffc-0277-424f-9224-7ee6eca46377 installs=0.19.1083 77a174ea7fcaddbb25d0082956cd25d8633fc2df -->
    Loom-Trace-Id: 772605234b9d8cafd6a4049200f7425c
    Loom-Build: unknown ddfb67ccf9a5115d62dd86924613a468b9328f44 clean
    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
2026-10-12 chore: resync installed Loom surfaces
    <!-- loom:provenance v1 build=unknown be358990895362019614bd207bcbe36bc9eeff2c clean prompts=none sweep=none story=none trace=f1dc643b95859c8f26e892ddb5e2c5d7 host=robb-studio base=ef4291a96bae29350f18387fc51cd8a10791d740 run=loom-run/v1:timer:robb-studio/fleet-resync:da486ca2-3e94-4a85-abd3-88707942489a installs=0.19.1087 51ac271f990b317a52ebf27cc21f34561e1179fb -->
    Loom-Trace-Id: f1dc643b95859c8f26e892ddb5e2c5d7
    Loom-Build: unknown be358990895362019614bd207bcbe36bc9eeff2c clean
    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
2026-10-12 chore: resync installed Loom surfaces
    <!-- loom:provenance v1 build=unknown a579728c137cc11d08a48b178e0ff9aa21683e72 clean prompts=none sweep=none story=none trace=10832f2750dbcd63f6c6f301a6f4da9b host=loom-worker-2 base=1910e7423fdedcb372530b5f6585dbb073c84eaf run=loom-run/v1:timer:loom-worker-2/fleet-resync:180f6d5054f0479ab3990b86ab4522a5 installs=0.19.1087 51ac271f990b317a52ebf27cc21f34561e1179fb -->
    Loom-Trace-Id: 10832f2750dbcd63f6c6f301a6f4da9b
    Loom-Build: unknown a579728c137cc11d08a48b178e0ff9aa21683e72 clean
    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
2026-10-12 chore(ci): adopt unified IHP-Open-PDK SG13CMOS5L pin for install and netlist CI (#252)
    Loom-Story: 2AMLogic/sg13g2-pll#252
    Loom-Trace-Id: a8533e8369f90176306954dbe67164b1
    Loom-Build: 0.19.1081 6966a93d1cd1b005f2a6b22bf9691ade8793ed73 clean
2026-10-12 chore: resync installed Loom surfaces
    <!-- loom:provenance v1 build=unknown 02ecafe7734bf5faa945ce88940589f00eca78e9 clean prompts=none sweep=none story=none trace=5f71c537126994dc4c45179122427514 host=robb-pro base=867e8954c1b375e357962adaa9fb5509ecb264a4 run=loom-run/v1:timer:robb-pro/fleet-resync:6293e6da-8a67-45aa-b277-c9ef85ddb810 installs=0.19.1101 27422582cd2d34d8ed5f60ce987007bc4bd61081 -->
    Loom-Trace-Id: 5f71c537126994dc4c45179122427514
    Loom-Build: unknown 02ecafe7734bf5faa945ce88940589f00eca78e9 clean
    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
2026-10-12 chore: resync installed Loom surfaces
    <!-- loom:provenance v1 build=unknown 5918da96dcd60c9a677a195737c86ea38972d215 clean prompts=none sweep=none story=none trace=49bb7a8942d6a23bf41754ca27ff2368 host=loom-worker-2 base=fcdb7aa8bf841288cf0f6b044a38e530a3265677 run=loom-run/v1:timer:loom-worker-2/fleet-resync:2e973f04abd1447d8ee4b696c2e7d2b4 installs=0.19.1108 72427939d156341080a7006ae6fbb5ec96b2368e -->
    Loom-Trace-Id: 49bb7a8942d6a23bf41754ca27ff2368
    Loom-Build: unknown 5918da96dcd60c9a677a195737c86ea38972d215 clean
    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
2026-10-12 chore: resync installed Loom surfaces
    <!-- loom:provenance v1 build=unknown 01467247f32c59822968bf02d3214d9a3d613452 clean prompts=none sweep=none story=none trace=0e97e9733eef09a33959cf96e6271f40 host=robb-studio base=0e8ede0c3e01400a05def9bf1ede9bd17b3e2b24 run=loom-run/v1:timer:robb-studio/fleet-resync:53a4d390-3842-4216-9018-5dced9d0ea17 installs=0.19.1109 d9498fcd419776b2517e30b99c88e76bbe92d2f4 -->
    Loom-Trace-Id: 0e97e9733eef09a33959cf96e6271f40
    Loom-Build: unknown 01467247f32c59822968bf02d3214d9a3d613452 clean
    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
2026-10-12 chore: resync installed Loom surfaces
    <!-- loom:provenance v1 build=unknown acadc2b4b0e852f2d889ac9dec616e1548705802 clean prompts=none sweep=none story=none trace=a69edb348af7f0e67b3bc77bc33b1bfc host=loom-worker-2 base=887dc42a379d2ce5000b2e7847935764930526a1 run=loom-run/v1:timer:loom-worker-2/fleet-resync:0923627ffda84cf69ec2486475772b10 installs=0.19.1126 7736d1276b6d01778fba3461114c858ef1bf5e2d -->
    Loom-Trace-Id: a69edb348af7f0e67b3bc77bc33b1bfc
    Loom-Build: unknown acadc2b4b0e852f2d889ac9dec616e1548705802 clean
    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
2026-10-12 chore: resync installed Loom surfaces
    <!-- loom:provenance v1 build=unknown 8d832cc8035d4ba07872510416468da0790332cd clean prompts=none sweep=none story=none trace=09a53bf60e96fc30a753caffd1de8c92 host=robb-studio base=9783d0acde2c4046401fe0693551beb047909dfb run=loom-run/v1:timer:robb-studio/fleet-resync:baf4c30c-65d9-4d4e-a740-f6a80cbb975c installs=0.19.1133 fd7af6d7adbad876821d49bff2c70c871f54b60c -->
    Loom-Trace-Id: 09a53bf60e96fc30a753caffd1de8c92
    Loom-Build: unknown 8d832cc8035d4ba07872510416468da0790332cd clean
    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
2026-10-12 chore: resync installed Loom surfaces
    <!-- loom:provenance v1 build=unknown aa1ed0d7d5499d2705977d971673d919dbbbaf4e clean prompts=none sweep=none story=none trace=2522608826ef5d5e4a88a9667055aeb7 host=loom-worker-2 base=9ef9e6b02f9de48c9711f21cc735d0c1a48ad3e9 run=loom-run/v1:timer:loom-worker-2/fleet-resync:8f26b719c712455381744111c50e90b4 installs=0.19.1142 b91ae5d1b5204f499a1abb875a6cf5bffc1d90b1 -->
    Loom-Trace-Id: 2522608826ef5d5e4a88a9667055aeb7
    Loom-Build: unknown aa1ed0d7d5499d2705977d971673d919dbbbaf4e clean
    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
2026-10-12 chore: resync installed Loom surfaces
    <!-- loom:provenance v1 build=unknown 8b64614d017d6ce7491c3a2ac9da51e5e2901c97 clean prompts=none sweep=none story=none trace=66044c049ba635bcd6a4797c3a77e84b host=robb-pro base=14aa0f140a4b17cde77a4b4a0e773916ebc97120 run=loom-run/v1:timer:robb-pro/fleet-resync:68f56594-05d0-4cc0-9c07-36263359d698 installs=0.19.1144 9e4381cbbd2386393e44c7a979583252948a3998 -->
    Loom-Trace-Id: 66044c049ba635bcd6a4797c3a77e84b
    Loom-Build: unknown 8b64614d017d6ce7491c3a2ac9da51e5e2901c97 clean
    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
2026-10-13 chore: resync installed Loom surfaces
    <!-- loom:provenance v1 build=unknown e66f00108a9519331aa981da8a01c6569ca623a9 clean prompts=none sweep=none story=none trace=d3e476cf8c03d5ed37f8e146b3632190 host=robb-studio base=43906cee89f7dfa57d34fd5426f18e79b2d2a6a1 run=loom-run/v1:timer:robb-studio/fleet-resync:1d7ace45-2daf-4c92-a752-67b11e982245 installs=0.19.1146 972552531e3e890528f13c6cc8fb7406877c96f9 -->
    Loom-Trace-Id: d3e476cf8c03d5ed37f8e146b3632190
    Loom-Build: unknown e66f00108a9519331aa981da8a01c6569ca623a9 clean
    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
2026-10-13 chore: resync installed Loom surfaces
    <!-- loom:provenance v1 build=unknown 98d08ab78cc223361354ee9947d996b1cb914b30 clean prompts=none sweep=none story=none trace=8b73addcdeaa8fbd65998649f42a8c50 host=loom-worker-2 base=d15010b2a0ee2360f0c6e959f7d3903dffaf917c run=loom-run/v1:timer:loom-worker-2/fleet-resync:3bfb13d52fca425f9cfced4541954cb6 installs=0.19.1148 1448fdfa79ac2dcab7fad6b95b72697b450f2a4a -->
    Loom-Trace-Id: 8b73addcdeaa8fbd65998649f42a8c50
    Loom-Build: unknown 98d08ab78cc223361354ee9947d996b1cb914b30 clean
    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
2026-10-13 chore: resync installed Loom surfaces
    <!-- loom:provenance v1 build=unknown d0bfbbc7ac309581d7abe02c4a269c7704010ee0 clean prompts=none sweep=none story=none trace=0ad6d167235000f3b5648cbd63d761ce host=robb-pro base=fcaca5d10d86cd94d2d40acbd7e489c717397288 run=loom-run/v1:timer:robb-pro/fleet-resync:4f7cbe22-40b6-49ff-8811-003ae8577c28 installs=0.19.1151 021b947d121929157cd83df0576e7f2aa12500d7 -->
    Loom-Trace-Id: 0ad6d167235000f3b5648cbd63d761ce
    Loom-Build: unknown d0bfbbc7ac309581d7abe02c4a269c7704010ee0 clean
    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
2026-10-13 chore: resync installed Loom surfaces
    <!-- loom:provenance v1 build=unknown 7916c4043a1b57e97a53bc5c111e74c5038a1091 clean prompts=none sweep=none story=none trace=20b27ffb08c4130dc9836ee8d9d97b97 host=loom-worker-2 base=56efb7510f5f0b66493212050967dc61ffc49c28 run=loom-run/v1:timer:loom-worker-2/fleet-resync:d34532ec625a4162ae8b58dde1a6738f installs=0.19.1151 f7d1deaab02a9c483fce1ced33fadb1af6d86f59 -->
    Loom-Trace-Id: 20b27ffb08c4130dc9836ee8d9d97b97
    Loom-Build: unknown 7916c4043a1b57e97a53bc5c111e74c5038a1091 clean
    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
2026-10-13 sim: rerun RECORD-001 five-block nominal klt pex on pinned dual-tree PDK; superseded addendum (Closes #255)
    Reran the five-block nominal single-corner klt pex flow on the reconstructed
    RECORD-001 inputs (layout 20261003-183059-dc5644a, dut/requests from e56e14a)
    with ihp-sg13cmos5l 607e18d4 + ihp-sg13g2 5cccb161, klt 0.7.1.dev228,
    ngspice-46, loom-worker-3. All deltas reproduce. Old-layout nominal only; the
    current PEX envelopes and whole-design sign-off are not refreshed. Failed
    ngspice-42 attempt retained. RECORD-001 and reports/pex.*.json unchanged.
    Loom-Story: 2AMLogic/sg13g2-pll#255
    Loom-Trace-Id: 709143eb32a4af7a78f111cd493b851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
2026-10-13 chore: resync installed Loom surfaces
    <!-- loom:provenance v1 build=unknown ac0bbcf6eda99918e88a0b8893d9762b106a2e45 clean prompts=none sweep=none story=none trace=8597ab8a51d68f9f8ee864fa71904bff host=robb-studio base=731d4bf911f4e80c8ca9da3ce3ec0de940f4938e run=loom-run/v1:timer:robb-studio/fleet-resync:2ea9dd71-a6b2-4d0c-86aa-859a0728c9b3 installs=0.19.1151 f7d1deaab02a9c483fce1ced33fadb1af6d86f59 -->
    Loom-Trace-Id: 8597ab8a51d68f9f8ee864fa71904bff
    Loom-Build: unknown ac0bbcf6eda99918e88a0b8893d9762b106a2e45 clean
    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
2026-10-13 chore: resync installed Loom surfaces
    <!-- loom:provenance v1 build=unknown 7916c4043a1b57e97a53bc5c111e74c5038a1091 clean prompts=none sweep=none story=none trace=99a9d442e177e2a14f9fe891925a70a9 host=loom-worker-1 base=812982336174732570340be00540aa29dd73498b run=loom-run/v1:timer:loom-worker-1/fleet-resync:c61893183c38452a8cff7a1b196057af installs=0.19.1151 f7d1deaab02a9c483fce1ced33fadb1af6d86f59 -->
    Loom-Trace-Id: 99a9d442e177e2a14f9fe891925a70a9
    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
2026-10-13 chore: resync installed Loom surfaces
    <!-- loom:provenance v1 build=unknown 7916c4043a1b57e97a53bc5c111e74c5038a1091 clean prompts=none sweep=none story=none trace=773e9e41a5730d2f79f2381ad2cde068 host=robb-pro base=dd2d7a954b4b7e77df96b893dac6fbdbce0f8d5a run=loom-run/v1:timer:robb-pro/fleet-resync:b7ca0d34-434e-4536-85b9-57adfa603a8d installs=0.19.1151 1ec34f9bb79942506958a3c18a31368f4e065508 -->
    Loom-Trace-Id: 773e9e41a5730d2f79f2381ad2cde068
    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
2026-10-13 chore: resync installed Loom surfaces
    <!-- loom:provenance v1 build=unknown f57244868aa20ef22c18aa8025972184aaea43e4 clean prompts=none sweep=none story=none trace=8e03b78fe6cb43a017c4a4823362ffa7 host=loom-worker-2 base=1ae1048ea89bfcf925a25b90a785d8e8ef91bc1f run=loom-run/v1:timer:loom-worker-2/fleet-resync:eb553d2fc2a54589aa37879f12b18ed5 installs=0.19.1151 a9d9bfc13e966655d6d847cb6876af523bc4a4c4 -->
    Loom-Trace-Id: 8e03b78fe6cb43a017c4a4823362ffa7
    Loom-Build: unknown f57244868aa20ef22c18aa8025972184aaea43e4 clean
    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
2026-10-13 chore: resync installed Loom surfaces
    <!-- loom:provenance v1 build=unknown 6fe43c87955e02019c2bc8dfad4fbd160b89170c clean prompts=none sweep=none story=none trace=49a4590bf54e81899c26d965f682504c host=robb-studio base=267e251a415213635992db58542d61a93f4942c1 run=loom-run/v1:timer:robb-studio/fleet-resync:459197b3-0050-4335-893e-e47b638eb819 installs=0.19.1151 d1d2dd6e9b17b05d0e718dc7b712685c24dd979d -->
    Loom-Trace-Id: 49a4590bf54e81899c26d965f682504c
    Loom-Build: unknown 6fe43c87955e02019c2bc8dfad4fbd160b89170c clean
    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
2026-10-13 sim: rerun RECORD-005 nominal lock-detector window on pinned dual-tree PDK; superseded addendum (Closes #256)
    Reran RECORD-005's nominal single-corner campaign (mos_tt/res_typ/27C/3.3V,
    real variant, 3.5 MHz ladder, 20 ps timestep check) on loom-worker-3 with
    ihp-sg13cmos5l 607e18d4 + ihp-sg13g2 5cccb161, ngspice-46 and
    klt 0.7.1.dev256, through run_rerun256.sh (run.sh with the output suffix
    changed only). The frozen DUT snapshot is byte-identical to the producing
    revision 3fd7967, so the original DUT bytes were measured, not today's
    design regenerated. All seven outputs reproduce the committed
    *_bodyfix_nominal.* set byte-identically (rc_extract 3 rows, window,
    schmitt, ladder, ladder_raw 2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
2026-10-13 chore: resync installed Loom surfaces
    <!-- loom:provenance v1 build=unknown 5dc3a07d084d0ec4034f0782d572925dcad86af7 clean prompts=none sweep=none story=none trace=cbc11657acadf58858409fe543c342e1 host=robb-pro base=e9c037a53fb0378d4ffe897579c129013a654e50 run=loom-run/v1:timer:robb-pro/fleet-resync:be586137-d91e-4e2c-82d6-3164d43aa9de installs=0.19.1152 2d5fe17958dca799058f16bdd74a12336990bec0 -->
    Loom-Trace-Id: cbc11657acadf58858409fe543c342e1
    Loom-Build: unknown 5dc3a07d084d0ec4034f0782d572925dcad86af7 clean
    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
2026-10-13 chore: resync installed Loom surfaces
    <!-- loom:provenance v1 build=unknown 27a266d5a27885323290840d2a837d73fcf4bcc6 clean prompts=none sweep=none story=none trace=e77cdd5477ef6bfc65fba6cc233788e0 host=loom-worker-2 base=97029013f05050d27f9c0ab4fde2998068cce9fe run=loom-run/v1:timer:loom-worker-2/fleet-resync:7fac7d82f298441a91761382ac989183 installs=0.19.1152 8d16eec5f10d705602ac4d1ab871c57266f1aa45 -->
    Loom-Trace-Id: e77cdd5477ef6bfc65fba6cc233788e0
    Loom-Build: unknown 27a266d5a27885323290840d2a837d73fcf4bcc6 clean
    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
2026-10-13 chore: resync installed Loom surfaces
    <!-- loom:provenance v1 build=unknown f2b62a2cf576d7d37092147b2281da809f8b5cf5 clean prompts=none sweep=none story=none trace=8adfa75521c72dded43e2932febb6329 host=loom-worker-3 base=0942daf5b0b74235f2cb8808a5b6dbcc9ae362e8 run=loom-run/v1:timer:loom-worker-3/fleet-resync:8a8198f8f80e4703bc7365a5e10595e0 installs=0.19.1152 a7c20e591a04d4acaeeca29fadd7fa4be7ca3122 -->
    Loom-Trace-Id: 8adfa75521c72dded43e2932febb6329
    Loom-Build: unknown f2b62a2cf576d7d37092147b2281da809f8b5cf5 clean
    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
2026-10-13 chore: resync installed Loom surfaces
    <!-- loom:provenance v1 build=unknown 84d11f248d368cae5e04a2255f6897a406c50089 clean prompts=none sweep=none story=none trace=8e50b4ccc3dc58f709a732f69d58fd44 host=robb-studio base=984043921ae4da129f743df2cea1dd1a848cbc9b run=loom-run/v1:timer:robb-studio/fleet-resync:05c9f3b1-eee2-412f-8996-5fbf02793d9e installs=0.19.1153 d8429a4fabdc955107af1cbc22c548e23eecf9b1 -->
    Loom-Trace-Id: 8e50b4ccc3dc58f709a732f69d58fd44
    Loom-Build: unknown 84d11f248d368cae5e04a2255f6897a406c50089 clean
    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
2026-10-17 feat(layout): content-addressed dedupe of new layout report artifacts
    Add record_store.py (dedupe + verify) and call it from both layout flow
    drivers after the record is rendered. Large artifacts move to an
    immutable reports/objects/<sha256> store behind same-path symlinks with an
    artifacts.json manifest; record.md/plan.json/build.json stay inline and
    existing records are untouched.
2026-10-17 feat(signoff): attest T1 item 10 with klt signoff --attest and bump the grading pin
    Add manifests/inventories/item-10.json and its tool-produced envelope, cite it
    for 10.analog and 10.digital, re-attest it in the signoff workflow, bump the
    klt pin to 44cc42323184 (klayout 0.30.12) and regenerate the tier report.
2026-10-23 characterization: repoint or drop gap rows that cite closed trackers
    - no-ratified-spec: spec is drafted in spec/target-spec.md (DRAFT), awaiting
    two-key ratification; #148 closed (draft landed), no ratification issue
    found -> none filed.
    - divider-speed: #168 closed; edge counts retained but still unselected;
    no open owner found -> none filed.
    - cp-charge-sharing: dropped. Resolved by DR-010 (#165 closed, PR #197:
    nominal row 7 0.78%, cp-tracking-dumpbuf-dc); pre-correction datasets
    carry per-dataset notes instead.
    - cp-dumpbuf-nominal-only: #165/#195 closed -> #178 (MC).
    - cp-vout-cap-pm-nominal-only: #196 closed -> #203.
    Regenerated SUMMARY.md; manifests/README.md item-8 list u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
2026-10-23 fix: add third reset-chain inverter to top-level pfd so reset = AND(UP,DN)
    Mirror of the sg13cmos5l fix (#56/#71): the even-parity XI1/XI2 chain handed
    back reset = NAND(UP,DN), leaving the SR latches transparent. Adds XI1B,
    regenerates design/netlist/pfd.spice via klt netlist, re-stamps and
    re-attests, and records a 36-corner PFD-only lead/lag check on the fleet.
2026-10-24 chore(layout): prune 8 superseded flow records and document retention policy
2026-10-27 build: pin klayout-tools to the 0.8.0 PyPI release and regenerate signoff evidence
    Replaces the daf06a51afaf git pin (layout/requirements.txt) and the
    44cc42323184 clone in signoff.yml with klayout-tools==0.8.0, asserts
    'klt 0.8.0' in CI, regenerates the tier report build block and item-10
    envelope, and refreshes both layout flow records.
2026-11-06 test: add static pfd reset-chain parity guard for committed netlists
    Walks NAND2(UP,DN) through single inverters to the srlatch R net in both
    committed pfd netlists and fails unless the inverter count is odd, with a
    test suite and a signoff.yml step.
2026-11-10 docs(design): annotate LOCK opin as active-low in lock_detector schematics
    Add a separate text object beside the LOCK opin in both the sg13g2 and
    sg13cmos5l lock_detector schematics. Pin and net names are unchanged.
2026-11-11 sim: rerun sg13g2 VCO Kvco table on batch fleet, supersede RECORD-001
    60-run matrix rerun as one klt sim decks request (probe job
    klt-sim-b0522cef1561, grid job klt-sim-a102ccafc592): 60/60 units,
    0 NA, periods identical to RECORD-001. Adds RECORD-002 and a superseded
    addendum; test fixture now picks the grandfathered original explicitly.
2026-11-11 sim: add klt sim batch deck-list driver for the sg13cmos5l lock_detector grid
    Expresses run.sh's grid as three klt sim deck-list requests (R/C extraction,
    window/Schmitt/tstep, ladder) submitted with --wait-for-capacity 600, reduced by
    the existing parsers into a new bodyfix_batch suffix. Includes the nominal-corner
    batch run and its parity result against RECORD-005.
2026-11-11 sim: re-measure SG13G2 divider repair opconv/hold/func on the batch fleet; superseded addendum (Closes #235)
    Reran RECORD-001's opconv, hold and func stages as klt sim requests on the
    batch fleet (23 jobs, ngspice-46 runner, ihp-sg13g2 repo pin) against the
    unchanged frozen divider_chain_repaired.spice, after a one-corner probe job
    (klt-sim-1bf42451d437). Every row shared with RECORD-001's CSVs reproduces;
    division ratio equals N for 9 baseline corners, 9 programming words and both
    range-edge corners; hold 9/9. The reltol=0.005 arm collapses (timestep too
    small) and the hold t_decay measurement has no value by design; both are kept
    as failed corners. Transferred CMOS5L setup/retime evidence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
2026-11-11 sim: rerun RECORD-003 divider repair re-verification on the batch fleet; superseded addendum (Closes #233)
    Reran all five RECORD-003 stages (opconv, hold, setup, func, retime) as 76
    pre-composed ngspice decks submitted with klt sim --backend batch (ngspice-46,
    runner klt 0.9.0). The decks are rendered by gen_rerun233_requests.py from
    run.sh's own templates and matrices against the frozen DUT snapshot, which is
    byte-identical to the producing revision a95a887. 20/20 divide ratios are
    exact, 9/9 hold, and 7/9 retime corners resolve, as originally. Analog values
    differ only in the last printed digit, and the two reltol=5e-3 arms fail as
    RECORD-003 Finding 2 records. The fleet worker exposes no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
2026-11-11 sim: rerun pre-repair divider RECORD-001/002 on the batch fleet; superseded addenda
    Rebuild the historical divider_chain (as-drawn and fbfix variants, snapshot
    byte-identical at 1d824d3/b8a14c8) as klt sim batch requests and rerun hold,
    setup and opconv in full plus the 100 MHz baseline and 1562 MHz retime at the
    nominal corner. Hold, setup and fbfix N=64.00 reproduce; the as-drawn opconv
    non-convergence and dead-chain state do not, and are recorded as such. The
    cmos5l tree used is the unified install pin, not the legacy PDK-PIN; the
    worker's tree is unstamped. Originals and existing corners/*.csv untouched.
2026-11-11 sim: rerun postlayout-pex-pvt RECORD-002 flow on pinned dual-tree PDK; superseded addendum
    Reran the floorplan-aware VCO route flow at ff8b653: layout GDS and the
    extracted pll_vco netlist are byte-identical to the originals, the 120-row
    Matrix A grid reproduces to printing precision and the 210-row RC attribution
    grid to 0.098 percent, LVS-recheck verdict shape unchanged. Grids ran as 27
    klt sim batch requests (330 units, all pass) with the pinned cmos5l (607e18d)
    and g2 (5cccb161, v0.3.0) model cards staged. RECORD-002 and its CSVs are
    unchanged; no consumer figure is replaced; item 9 stays unmet.
    Closes #324
    Part of #215
2026-11-11 sim: rerun RECORD-003 pfd and lock-detector arms on the batch fleet; superseded addendum
    Reran run_pfd.sh and run_lock_detector.sh from 07751ca unmodified through a
    deck-replay bridge (6 klt sim decks requests, 534 units). Schematic arm, post-layout
    reflead, 101/102 window-control points and capacitor rows reproduce; post-layout
    fblead inversion, resistor extraction, ladder classes and window deviation
    magnitude do not. Single-deck controls on the pinned checkout attribute the
    fblead flip and resistor shift to the fleet image's unpinned ihp-sg13cmos5l
    tree. RECORD-003 and its CSVs are untouched.
    Closes #325
2026-11-11 sim: batch-fleet rerun of sg13g2 lock-detector RECORD-001 with superseded addendum
    Re-measures the frozen resized lock-detector snapshot at RECORD-001's
    original matrices (R/C, window, Schmitt, tstep, 21-corner ladder, hysteresis
    diagnostic) as klt sim deck-list requests on the batch fleet; new
    *_resized_rerun236 outputs, byte-identical to the originals (ladder_raw
    modulo CRLF). Adds RECORD-002, ADDENDUM-001, run_batch.py, the job ledger and
    raw evidence. Sizing sweeps are not rerun (stated in the record).
2026-11-11 sim: full-grid batch-fleet rerun of the XRPU-bulk-on-VSS lock detector vs RECORD-004 (RECORD-009)
    Part of #16. Adds the *_bodyfix_batch full-grid outputs, fleet reports,
    keyed comparison script and output, RECORD-009 and the sim/README index
    entry. Ladder rows are PDK-confounded and the 20x idd_outlock probe is not
    run; both are disclosed in the record.
2026-11-11 sim: add SG13CMOS5L vco output-levels bench (spec row 14), 54-point klt batch grid
    Measures settled V_OH/V_OL into 50 fF across 3 PVT bundles x 3 temps x band 00/11 x 3 VCTRL.
    All 54 points inside the row-14 bounds; binding V_OH 3.003 V (+33 mV). Spec not edited.
    Closes #190
2026-11-11 Fix records/grade CI gates for divider-retiming-sizing RECORD-001
    - characterization/sources.json: list RECORD-001 (dataset
    divider-retiming-sizing-sweep) with a 1:1 CSV transcription of
    setup-sizing-sweep2.txt; regenerate SUMMARY.md and pin hashes.
    - RECORD-001: cite the ran-on PDK revision f7bca326 as inferred (the batch
    reports carry no PDK stamp), explicitly not the README pin.
    - sim/README.md: make the bench-index row parseable (one backticked token
    per cell).
    - Mark testbench/gen_sizing_requests.py executable (gate requires it).
2026-11-11 sim: add 3.0/3.3/3.6 V supply-range sweep for vco, lock_detector, divider_chain
    New bench sg13cmos5l-supply-range renders the sibling benches' templates at
    three supply points over the 3 PVT bundles as klt batch deck-list requests;
    RECORD-001 holds the 225-deck fleet results (probe + 3 jobs, all pass).
2026-11-12 sim: 9-corner retime, opposite-edge retiming and slow-corner ceiling for row-3 closure (RECORD-002)
    Retime of feedback-weakened dff_tg_hv variants at 9 corners (N=64/127), an
    opposite-edge XFRT variant, a slow-corner divider frequency sweep and 9-corner
    setup brackets, all via klt sim batch. Closing bound >= 1562 MHz not reached;
    best achieved and limits recorded. DR-012 updated (still proposed); spec and
    design unchanged.
    Part of #189
2026-11-12 sim: rerun RECORD-004 loop-filter and divider-chain arms on the batch fleet; superseded addendum
2026-11-13 refactor: split the SG13CMOS5L record renderer into per-section helpers
    `render-pll-cmos5l-record.py` was a single 525-line `main()` that reached
    its report sections only after shelling out to `klt` three times, so the
    ~460 lines producing every number and every conditional sentence of a
    full-run `record.md` ran in no test — they executed only at the end of
    `run-pll-cmos5l-layout-flow.sh`, which needs the PDK and `klt`.
    Extract `render(record_name, plan, build, pdk, deck, pdk_info, deck_info,
    klt_version) -> str`, a pure function of the two JSON files plus the
    resolved PDK/deck identity, and one helper per report section behind it
    (`_header_lines`, `_verdict_lines`, `_per_block_lines`, `_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
2026-11-13 refactor: move the klt-gen capability probes into cmos5l_probes.py
    `layout/bin/pll_cmos5l_layout.py` mixed two jobs with different audiences:
    the layout flow that produces every pass/fail claim for the block, and the
    three upstream-capability probes (issue #35) that re-measure whether `klt
    gen` / `klt gen-compose` can replace the local drawing and routing yet.
    The probes are deliberate and keep running on every build; they just no
    longer sit at the bottom of the flow they cannot affect.
    Moved to the new sibling `layout/bin/cmos5l_probes.py`, verbatim apart from
    the seam below: `probe_gen_compose_router`,
    `probe_gen_compose_block_routing`, `probe_generator_footprints`, their
    helpers `_port_c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
2026-11-13 docs: cite the LATEST record for cp's gen-compose probe figures
    The cmos5l layout prose quoted issue #35's original measurement of the
    router-probe block cp -- 8 groups, 14 devices, 13 multi-pin nets, 1 of 13
    routed -- as a current fact. The record reports/LATEST names
    (20261027-175228-74cf8d0-dirty) measures 13 groups, 28 devices, 97 ports,
    22 declared nets, with 2 of 22 routed on one plane.
    The two-layer row was stale in the other direction: README and three
    docstrings said gen-compose offers no second routing plane on this family
    and that 'metal2' is rejected as an unknown layer role (exit 1). The
    committed block-routing-two-layer attempt sends
    routing.cross_block_layer_role: "metal2" an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
2026-11-13 sim: run the cp mismatch Monte Carlo campaign and wire T1 item 6
    Runs the 1500-sample campaign the sg13cmos5l-cp-icp-trim-mc bench was
    built for (PR #191 left it blocked), on the DR-010 cp, and cites the
    resulting `klt yield` envelope from the manifest.
    Result: pooled yield 63.47 % (95 % CI 60.97-65.91 %) against the bench's
    own unratified +/-3.5 % screening limit, sigma 3.877 %, Cpk 0.273, 0
    errored samples. Sigma is driven by temperature, not process corner.
    `klt yield`'s sample-size verdict is `insufficient` (N = 1500 resolves
    the yield to +/-2.47 pp; 8907 needed for its default +/-1 pp), so
    `klt signoff` grades T1 item 6 analog `unmet` / `undersized_sample` --
    off `no_evidence`, not to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
2026-11-13 docs: correct two measurable claims in cp mismatch RECORD-002
    Judge review on PR #386 found two statements in the new append-only record
    contradicted by the PR's own committed data. Both are corrected before the
    record freezes.
    1. "Sigma falls monotonically with temperature in every one of the five
    process sections" is false for `mos_tt_mismatch`, which rises 3.963 % ->
    3.973 % from -40 C to 27 C before dropping to 3.121 % at 125 C. Four of
    five sections are monotonic. Restated as what was measured: sigma is
    lower at 125 C than at -40 C in all five, monotonic in four, with the
    N = 100 per-corner sampling uncertainty noted so "monotonic" is not
    carrying more than the data c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
2026-11-13 feat(probes): tally each gen-compose attempt's own Metal1/Via1/Metal2 shapes
    `probe_gen_compose_block_routing` recorded exit code, error and routed-net
    counts per attempt, but `gen-compose`'s response carries no per-leg layer —
    so "the second routing plane is drawn on" and "the role name resolves and
    everything still lands on Metal1" were indistinguishable in the record. That
    left klayout-tools#1474 documented as an open question the committed GDS
    already answered.
    `_top_cell_layer_shapes` opens the composed GDS and counts the shapes the top
    cell draws *in its own cell* on 8/0, 19/0 and 10/0 — not a flattened tally,
    which on Metal1 would be dominated by the instantiated blocks' own pads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
2026-11-13 sim+spec: measure the cp mismatch-to-phase-error gain on the DR-010 cp and retire the ±3.5% screening limit
    The Monte Carlo bench graded `cp` up/dn mismatch against a ±3.5% screening
    value derived from one closed-loop point measured on the pre-DR-010 `cp`
    (9.176% static phase error per 6.42% mismatch, assumed linear through the
    origin). That gain had never been re-measured on the `cp` the campaign
    simulates.
    Measure it. `sim/sg13cmos5l-closed-loop-lock` gains a sweep that steps the
    injected DC up/dn mismatch of the committed DR-010 snapshot from −11.998%
    to +12.009% (±3.1σ) by scaling one mirror leg, measures each perturbed
    snapshot's own DC mismatch rather than assuming it, and runs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
2026-11-13 build: run the repo's stdlib test and check gates from package.json
    `test`, `check:ci`, `check:all` and `lint` printed a placeholder and exited 0,
    so `pnpm test` reported success without running anything; `worktree:return`
    pointed at `.loom/scripts/worktree-return.sh`, which does not exist in this
    repo (exit 127). This was a passing gate with nothing behind it, in a repo
    whose rule is "no claim without a testbench".
    Point `test` at the 11 stdlib `test_*.py` files signoff.yml and
    artifact-manifests.yml already run, and `check:ci` at those plus the 11
    tool-free `check_*.py` / `gen_summary.py --check` gates beside them. Both
    chain with `&&`, so the first failure short-circuits and the command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
2026-11-14 ci: gate the two testbench metric-extraction self-tests
    `test_cpdiag_metrics.py` and `test_mismatch_gain_metrics.py` were the only
    two of the repo's 13 stdlib `test_*.py` outside `layout/tests` that no
    workflow ran, so a regression in the metric extraction RECORD-006 and
    RECORD-014 cite as provenance could not fail any gate.
    Add both as one step in `signoff.yml`'s existing offline `records` job --
    already stdlib-only with `setup-python`, and the job that guards the
    records whose numbers this extraction produces -- and append both to
    `package.json`'s `test` chain so the local command stays an exact mirror
    of the CI gate set. `check:ci` inherits them via `pnpm run test`.
    One step rather than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
2026-11-14 refactor: drop check-osdi-arch.sh --warn-only, the blanket exit-0 downgrade
    `--warn-only` downgraded a genuine OSDI architecture mismatch on *every*
    object to exit `0`, with nothing named on stdout and nothing for the caller
    to branch on — the "record a number produced by a silently different
    circuit" outcome the script's own header says it exists to prevent. It had
    no caller in the tree or anywhere in this repo's history.
    `--soft <basename>` (07e1866, #52) already replaced it with the narrow form:
    per-object, named on stdout, exit `3`, caller must branch and must label the
    substituted rows. Removing the blanket predecessor carries that decision to
    completion rather than reversing it; `--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
